crab2424/LEDplaying_system/チーム内部資料/7_3_23時計画書/img/LEDマトリクス基本設計詳細設計.pptx

エンターテイメントとしての
LEDマトリクス
Processingでの楽器選択
演奏中マトリクス
表示選択
演奏箇所の音程表示
演奏楽器の表示
演奏箇所の歌詞の表示

## Slide 2

クラスについて書く
