crab2424/LEDplaying_system/チーム内部資料/7_3_23時計画書/img/全体情報流れ.pptx

どうやって一定間隔で
LEDを光らせるのか

音程どんな形で送信するのか
長さはどうやって処理するのか(前言ってくれてた前回のテンポを参考に長さを決める)
楽譜情報は楽器用arduinoに入っているためどうやって送信するのか

点滅色の入れ替わり

指揮者用Arduino

・R,G,B値

楽器用Arduino

・音程
・音の長さ
・テンポ情報

楽器用PC(Processing)

・RBGの強さ

analogWriteでR,G,Bの値をフルカラーLEDへ送信

受光素子が受けとったR,B,G値をanalogReadで受信

USBで接続し，
シリアル通信
Serial.writeで送信．
sirialEvent()で受信．

## 通信の方法と内容

- 指揮者用Arduinoと演奏者用Arduino間のLEDでの通信
  - 指揮者用のArduinoのフルカラーLEDで色を出力し，演奏者用Arduinoに繋いだカラーセンサで受け取り通信する．
  - この時送信する内容はテンポ，誰が次のテンポを受け取った時に始めるかを送る．
- 演奏者用ArduinoとProcessing間でのシリアル通信
  - 演奏者ArduinoとPCをUSB Type-Cで接続し，Processing側でArduinoのシリアルポートと接続しシリアル通信を行う．
  - Arduino側はserial.write()関数を用いてデータを送信し，Processing側では1バイトのデータが届いた時に動くserialEvent()関数を用いて送受信を行う．
  - Processingへは演奏する音程，長さ，テンポ(テンポLED情報の間隔)を送る．

## LEDライトの状態ごとに何の信号とするのか(数値的に)

外部割り込みはLOW, CHANGE, RISING
FALLINGのときだけ発生させられる．
そのため，analogReadで取得するから無理．

・次のテンポLEDから曲をスタートする合図(楽器*4)
・テンポ用発光
5種類のRGBパターン?

テンポの取り方
パルス波的な信号をanalogReadで取得．脈拍のように下がる時の最大値を音の大きさとする
どうやって電圧値を一瞬だけ上げて下げるか　何かで時間をとってあげてその時間を過ぎたらpinの電圧を下げればよい．(外部割り込み使えない+loopの中の判定式で信号を取得する場合.短すぎるとanalogReadのタイミングで取り逃がす == 受け取り側の1Loop以上の長さ)
(赤がテンポで，青緑00以外のサンパターンはできる)ここ確認したい

アナログかデジタルか．どういう状態をどのパターンとするか

## 発表来週 計画発表

- 題目申請 今日17:00まで
- 計画発表: 題目申請 来週の計画書，設計書は全て同じ題目(タイトルにする)

## 役割分担

- システムの役割分担
- 単体，結合テスト，システムテスト
- 結合テストで作成できたものが動くのかのテスト(毎週)

## 必要な機材

- どの構成要素・役割に何が必要かまとめる
- 全てで共通のもの
- Arduino *5
- ブレッドボード
- PC processing..
- 指揮者に必要なもの
- 演奏者に必要なもの

## Slide 7
