crab2424/LEDplaying_system/チーム内部資料/7_3_23時計画書/26_計画書・設計書(2026年7月3日版)_24G1040.pdf

2026 年 7 月 3 日 Version 1.6

# ハッカソン 〜計画書と設計書〜

## チーム 26

24G1040 : 金枝 優介
24G1074 : 荘司 あかね
24G1125 : 三芝 空音
25G1009 : 飯塚 蓮
25G1034 : 恩田 隼士
25G1063 : 佐藤 羽琉

目次

第 1 章 | プロジェクトの計画書 ・・・・・・・・・・・・・・・・・・・・・・・・・・・・ | 1
1.1 | プロジェクトの概要・・・・・・・・・・・・・・・・・・・・・・・・・・・・・・ | 1
1.1.1 | プロジェクトの題目 ・・・・・・・・・・・・・・・・・・・・・・・・・・・・ | 1
1.1.2 | プロジェクトの目的 ・・・・・・・・・・・・・・・・・・・・・・・・・・・・ | 1
1.2 | 社会的背景 ・・・・・・・・・・・・・・・・・・・・・・・・・・・・・・・・・・・ | 1
1.2.1 | 既存の技術とプロジェクトの独自性・・・・・・・・・・・・・・・・・・・ | 2
1.3 | スコープ・マネジメント ・・・・・・・・・・・・・・・・・・・・・・・・・・・ | 4
1.3.1 | 成果物・・・・・・・・・・・・・・・・・・・・・・・・・・・・・・・・・・・・・ | 4
1.3.2 | プロジェクトの対象範囲と非対象範囲 ・・・・・・・・・・・・・・・・・ | 4
1.3.3 | 機能分解構造 FBS・・・・・・・・・・・・・・・・・・・・・・・・・・・・・・ | 5
1.3.4 | 製品分解構造 PBS・・・・・・・・・・・・・・・・・・・・・・・・・・・・・・ | 5
1.3.5 | FBS と PBS の対応関係 ・・・・・・・・・・・・・・・・・・・・・・・・・・ | 6
1.4 | 作業計画・・・・・・・・・・・・・・・・・・・・・・・・・・・・・・・・・・・・・ | 7
1.4.1 | 作業分解構造 WBS と管理番号・・・・・・・・・・・・・・・・・・・・・・ | 7
1.4.2 | アローダイアグラムとクリティカルパス・・・・・・・・・・・・・・・・ | 9
1.4.3 | 役割分担 ・・・・・・・・・・・・・・・・・・・・・・・・・・・・・・・・・・・ | 9
1.4.4 | ガントチャート ・・・・・・・・・・・・・・・・・・・・・・・・・・・・・・・ | 10
1.5 | 検証と妥当性確認: V&V 計画 ・・・・・・・・・・・・・・・・・・・・・・・・ | 11
1.5.1 | プロジェクトの成果物に対する有効指標 MOE ・・・・・・・・・・・・ | 11
1.5.2 | 有効指標 MOE に対応する性能指標 MOP ・・・・・・・・・・・・・・・ | 12
1.5.3 | システムテストで評価する性能指標 MOP ・・・・・・・・・・・・・・・ | 12
1.5.4 | 結合テストで評価する性能指標 MOP・・・・・・・・・・・・・・・・・・ | 13
1.5.5 | 単体テストで評価する性能指標 MOP・・・・・・・・・・・・・・・・・・ | 13
1.5.6 | プロジェクト中に監視する技術性能指標 TPM ・・・・・・・・・・・・ | 16
1.6 | 資源・調達管理・・・・・・・・・・・・・・・・・・・・・・・・・・・・・・・・・ | 16
1.7 | リスク管理 ・・・・・・・・・・・・・・・・・・・・・・・・・・・・・・・・・・・ | 18
第 2 章 | システムの基本設計・・・・・・・・・・・・・・・・・・・・・・・・・・・・・・ | 19

2

2.1 | 機能一覧・・・・・・・・・・・・・・・・・・・・・・・・・・・・・・・・・・・・・ | 19
2.2 | システム構成図・・・・・・・・・・・・・・・・・・・・・・・・・・・・・・・・・ | 21
2.3 | 操作インターフェース設計・・・・・・・・・・・・・・・・・・・・・・・・・・ | 21
2.4 | 状態遷移図 ・・・・・・・・・・・・・・・・・・・・・・・・・・・・・・・・・・・ | 23
第 3 章 | システムの詳細設計・・・・・・・・・・・・・・・・・・・・・・・・・・・・・・ | 25
3.1 | 部品一覧・・・・・・・・・・・・・・・・・・・・・・・・・・・・・・・・・・・・・ | 25
3.2 | ハードウェア設計 ・・・・・・・・・・・・・・・・・・・・・・・・・・・・・・・ | 27
3.3 | ソフトウェア設計 ・・・・・・・・・・・・・・・・・・・・・・・・・・・・・・・ | 29
3.3.1 | ファイル構成・・・・・・・・・・・・・・・・・・・・・・・・・・・・・・・・・ | 29
3.3.2 | 通信設計 ・・・・・・・・・・・・・・・・・・・・・・・・・・・・・・・・・・・ | 29
3.3.3 | LED マトリクスへの歌詞表示 ・・・・・・・・・・・・・・・・・・・・・・ | 31
3.3.4 | 音生成・再生・・・・・・・・・・・・・・・・・・・・・・・・・・・・・・・・・ | 33
3.3.5 | 受光機能 ・・・・・・・・・・・・・・・・・・・・・・・・・・・・・・・・・・・ | 33
3.4 | スイッチによる入力制御の詳細設計 ・・・・・・・・・・・・・・・・・・・・ | 37
3.4.1 | 入力ピンの割り当てと初期設定 ・・・・・・・・・・・・・・・・・・・・・ | 37
3.4.2 | 可変抵抗によるテンポ入力 ・・・・・・・・・・・・・・・・・・・・・・・・ | 38
3.4.3 | 可変抵抗による分圧の原理 ・・・・・・・・・・・・・・・・・・・・・・・・ | 38
3.4.4 | タクトスイッチによる起動・停止制御 ・・・・・・・・・・・・・・・・・ | 39
3.4.5 | 入力制御の処理フロー ・・・・・・・・・・・・・・・・・・・・・・・・・・・ | 41
3.4.6 | オブジェクト設計 (クラス図)・・・・・・・・・・・・・・・・・・・・・・・ | 42
3.4.7 | 関数設計 ・・・・・・・・・・・・・・・・・・・・・・・・・・・・・・・・・・・ | 44
3.5 | 処理フローの設計 ・・・・・・・・・・・・・・・・・・・・・・・・・・・・・・・ | 45
3.6 | テストの設計 ・・・・・・・・・・・・・・・・・・・・・・・・・・・・・・・・・・ | 50
3.6.1 | システムテストの設計 ・・・・・・・・・・・・・・・・・・・・・・・・・・・ | 50
3.6.2 | 結合テストの設計・・・・・・・・・・・・・・・・・・・・・・・・・・・・・・ | 51
3.6.3 | 単体テストの設計・・・・・・・・・・・・・・・・・・・・・・・・・・・・・・ | 51

# 第 1 章 プロジェクトの計画書

## 1.1 プロジェクトの概要

### 1.1.1 プロジェクトの題目

本プロジェクトの題目は，「単一のフルカラー LED と Arduino を用いた光無線通信 による楽器間同期演奏システムの開発」である．

### 1.1.2 プロジェクトの目的

従来の同期システムでは，有線接続による配線制約や，無線通信における通信遅 延・通信環境依存などが課題となっている．本プロジェクトの目的は，LED の光を 用いた無線通信による楽器間同期演奏システムを構築し，楽器演奏のズレを最小限に 抑え，合奏を成立させることである．さらに，利用者が楽器変更やテンポ変更等の演 奏機能を制御するための Web サイトや視覚的に合奏を認識するために LED マトリク ス歌詞表示システムを構築することでシステムの操作性及びエンターテイメント性の 向上を目指す．最終的なゴールは，ユーザの操作に応じて，複数楽器の同期演奏を成 立させることである．

## 1.2 社会的背景

近年，音楽演奏や視覚演出の分野において，出力装置を複数台組み合わせた作品や システムが研究されている．例えば神田らは複数のモバイルデバイスを用いたインタ ラクティブメディアアートを提案している [1]．これらのシステムでは，各装置が正 確なタイミングで動作することが求められ，リアルタイム同期処理が重要な要素と なる．
特に音楽演奏においては，複数の演奏者や演奏装置が同一テンポで動作する必要が あり，わずかな同期ズレであっても演奏品質に影響を与える．音声遅延が演奏に与え

1

る影響は大きく，先行研究では数 ms 程度の遅延であっても演奏品質や演奏感覚に影 響を与えることが報告されている [2]．そのため，演奏同期システムにおいては，演 奏に支障を与えるような遅延や同期ズレを低減するための高精度な同期制御技術が求 められる．
また，近年の IoT 技術の発展により，様々なデバイスがネットワークに接続される ようになり，データ流通量のさらなる増加へとつながっている [3]．このような技術 は，スマートホームや産業機器の制御，エンターテインメントシステムなど，多様な 分野において応用されている．
一方で，複数装置を連携させる従来の同期システムでは，有線接続による配線制約 や，無線通信における通信遅延・通信環境依存などの課題が存在する．そのため，複 数装置を柔軟に同期可能な，新たな同期手法が求められている． また，輪唱のような複数パートが異なるタイミングで演奏する楽曲では，聴衆が各 パートの演奏状況を聴覚のみで把握することは難しい．音楽演奏において視覚情報と 聴覚情報を組み合わせることで，聴衆の楽曲理解や没入感が向上することが報告され ており [4]，演奏システムにおける視覚的演出の重要性は高まっていると言える．

### 1.2.1 既存の技術とプロジェクトの独自性

既存の通信方法として現在幅広く利用されているものに，有線通信および

Bluetooth や Wi-Fi を用いた無線通信がある．
有線通信は通信の安定性が高く遅延の影響を受けにくいという利点を持つが，複数 装置を接続するためには配線が必要となり，設置の自由度が低下するという課題があ る．特に近距離環境での複数装置の同期において，配線の取り回しがシステム構成の 複雑化を招く．一方，無線通信は配線を必要とせず柔軟なシステム構成が可能である が，電波干渉や通信環境の影響を受けやすく，遅延やパケット損失が発生する可能性 がある [5]．
また，本システムに関連する技術として光無線通信が挙げられる．光無線通信と は，我々が日常的に使用している放送や携帯電話の電波と同じ電磁波の一種である 光を電波媒体とするシステムである [6]．この通信システムの光源には LED や LD， VCSEL が用いられ，光信号の受信用検出器には Pin-PD や APD が使われる． 従来の光通信では，光の有無や強弱といった単一の情報を扱う方式が一般的であ り，伝達可能な情報量が限られるという課題がある．これは，従来の強度検出型の光 通信方式では，主に光の強弱のみを情報として利用していることに起因する．また，

2

外乱光の影響を受けやすく，環境光の変動による誤検出が生じる可能性がある．さら に，複数の信号を識別することが困難であり，多数の装置を同時に制御する用途には 適していない．
これらの課題に対し，本システムは近距離環境での複数装置の同期制御を対象と し，フルカラー LED とカラーセンサを用いた光通信を採用することで配線を不要と し，近距離環境における配線削減およびシステム構成の簡略化を図る．
単一の LED から全演奏者へ同時に信号を送信する構成とすることで，演奏者間の 信号のばらつきをなくし，同期ズレを防ぐ設計とした．光は電波と比較して外部から の干渉を受けにくく，混線が生じないため，無線通信で問題となる同期ズレの低減が 期待される．また，光通信ではネットワークを介した無線通信と異なり，パケット損 失や通信環境変動の影響を受けにくく，安定した信号伝達を行うことができると考 えられる．加えて，単一の LED を使用することで，有線通信のように装置の増加に 伴って分配器やケーブルが増大する問題がなく，受光可能範囲内であれば装置の追加 や配置変更が容易である．さらに，光通信はネットワークを介した無線通信と比較し て，通信処理が単純であるため，低遅延化が期待できる．加えて，センサ周辺を遮光 することで外部照明の影響を低減し，誤検出の低減を図る． 本システムではフルカラー LED とカラーセンサを用いることで，光の色，発光間 隔，光強度といった複数のパラメータを同時に利用した通信を実現している．これに より，従来の強度ベースの光通信と比較してより多くの情報を表現可能である．さら に，光の点灯間隔をセンサで検出することでテンポ情報を直接取得し，数値データを 用いずに演奏タイミングを制御する点に特徴がある．また，色ごとに異なる意味を割 り当てることで複数の楽器や制御信号を同時に扱うことができる． 以上より，本システムは光通信の簡易性と多機能性を両立した光同期システムであ る点に独自性がある．さらに，本システムでは LED マトリクスによる歌詞表示機能 を実装することで，輪唱における各パートの演奏タイミングを視覚的に提示し，聴覚 情報のみでは把握しにくい輪唱の構造を視覚情報と組み合わせて表現する点にも独自 性がある．

3

## 1.3 スコープ・マネジメント

### 1.3.1 成果物

本プロジェクトにおける最低限達成すべき機能として，光無線通信による楽器間の 演奏ズレが限りなく少ない合奏機能を実装する．同期通信，演奏制御，エンターテイ メントとしての歌詞表示を含めた本プロジェクトの成果物は，以下の通りである．

•フルカラー LED を用いた光通信による同期演奏システム •各楽器の音再生プログラム
•LED マトリクスによる歌詞表示機能
•Web 演奏制御機能

### 1.3.2 プロジェクトの対象範囲と非対象範囲

フルカラー LED を用いた同期演奏システムを構築するために必要な本プロジェク トの対象範囲は以下の通りである．

•LED による光通信機能実装
•カラーセンサを用いた光信号の受信，解析
•テンポ取得
•4 種類の楽器音再生
•Web からのテンポ変更，楽器変更，音量変更，楽譜選択・ループ演奏選択機能 実装
•LED マトリクスによる歌詞表示

一方で，本プロジェクトでは，指揮者，演奏者間の同期通信に焦点を当てるため， 実際の楽器を演奏するのではなくデータとして楽器を演奏する．また，Web サイトで の演奏制御は同期処理に負荷をかけないよう，演奏前に楽器の変更などを行うため ネットワーク環境の整備は本プロジェクトでは対象外とした．よって，非対象範囲は 以下の通りである．

•商用レベルの高速・長距離光通信

4

•実際の楽器を演奏するための入力インターフェース
•システム運用に必要なネットワーク環境の整備

### 1.3.3 機能分解構造 FBS

本システムのユーザ目線から見た機能分解としての FBS を図 1.1 に示す．ユーザが 可能な制御は演奏中と，演奏前の二つに分けられる．演奏前は，演奏者ごとに楽器変 更，楽譜選択，個別音量の調節が可能で，演奏中は，テンポ変更，全体音量の調節， およびループ演奏の切り替えが可能である．また，それらの演奏制御は物理的なス

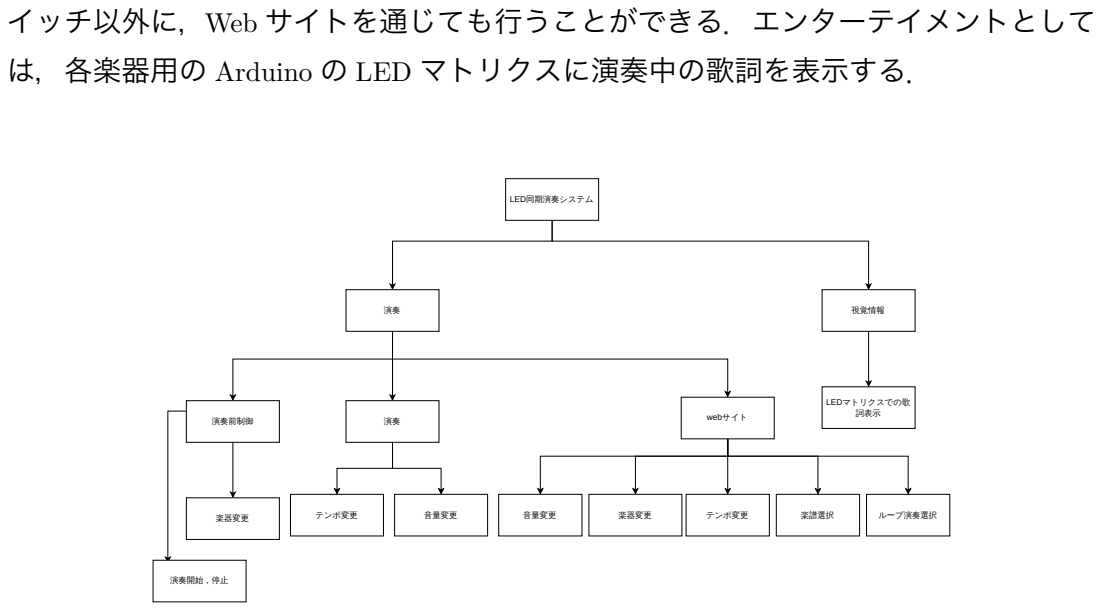
[picture p4: figure]
イッチ以外に，Web サイトを通じても行うことができる．エンターテイメントとして; は，各楽器用の Arduino の LED マトリクスに演奏中の歌詞を表示する．; LED同期演奏システム; 視覚情報; LEDマトリクスでの歌 詞表示; 演奏前制御; webサイト; 楽器変更; テンポ変更; 音量変更; 楽譜選択; ループ演奏選択; 演奏開始，停止

図 1.1 機能分解構造 (FBS)

### 1.3.4 製品分解構造 PBS

本システムの FBS を実装するための機能である PBS を図 1.2 に示す．ハードウェ アの面では，演奏同期のための LED の送受信の機能と，演奏開始や停止などの演奏 制御をボタン，スイッチを用いて実装する．また，ソフトウェアの面では，演奏を実

5

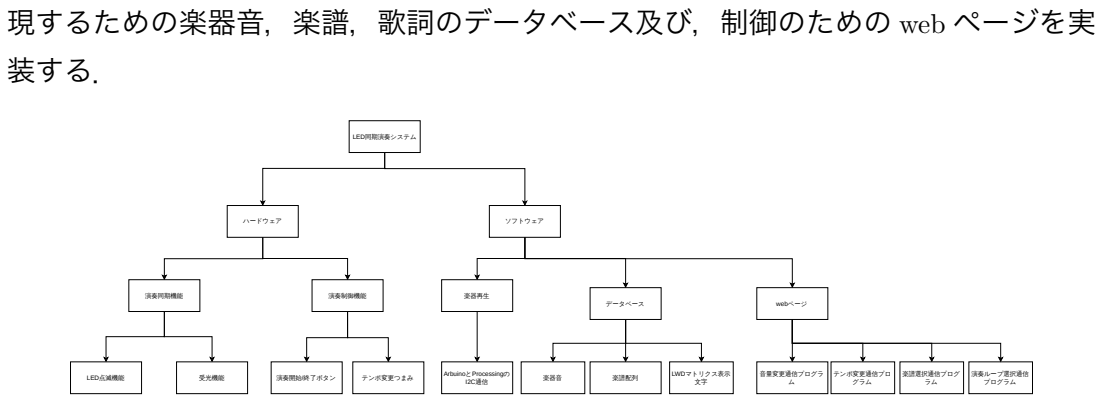
[picture p5: figure]
現するための楽器音，楽譜，歌詞のデータベース及び，制御のための web ページを実; 装する．; LED同期演奏システム; ハードウェア; ソフトウェア; 演奏同期機能; 演奏制御機能; 楽器再生; LED点滅機能; 受光機能; 演奏開始/終了ボタン; テンポ変更つまみ; ArbuinoとProcessingの; I2C通信; データベース; 楽譜配列; LWDマトリクス表示; 文字 楽器音; webページ; 音量変更通信プログラ ム; テンポ変更通信プロ グラム; 楽譜選択通信プログ ラム; 演奏ループ選択通信 プログラム

図 1.2 製品分解構造 (PBS)

### 1.3.5 FBS と PBS の対応関係

FBS と PBS の対応関係を以下の表 1.1 に示す．FBS の各機能に対して，それを実 現する PBS のサブ成果物を対応付けた．各機能は 1 つ以上の成果物によって実現さ れる．
「楽器演奏」機能については，ソフトウェア側の「演奏プログラム（ピアノ・バイ オリン・フルート・パーカッション再生）」と，ハードウェア側の「音再生用 PC」に よって実現される．「演奏制御」機能のうち，「演奏同期」は「送受信プログラム」 と「フルカラー LED」「カラーセンサ」の組み合わせにより，光無線通信として実装 される．また，「演奏開始・停止」は「Web サイト」と指揮者 Arduino に設置された 「タクトスイッチ」がその役割を担う．「Web サイト」による「テンポ変更」「音量変 更」「楽器変更」「楽譜選択」「ループ演奏選択」は，Web サイトに対応した各プログ ラムの構築により実現される．「視覚情報表示」機能である「LED マトリクス歌詞表 示」は，ソフトウェア側の「LED マトリクス表示プログラム（文字配列データ）」と， ハードウェア側の「演奏者 Arduino」によって実装される．このように，本プロジェ クトにおける全ての機能要件は，定義されたソフトウェアおよびハードウェアの構成 要素によって網羅されている．

6

表 1.1 FBS と PBS の対応関係
FBS（機能） | PBS（成果物）
ピアノ演奏 | 演奏プログラム（ピアノ音再生），楽器音データ，楽譜配列データ
バイオリン演奏 | 演奏プログラム（バイオリン音再生），楽器音データ，楽譜配列データ
フルート演奏 | 演奏プログラム（フルート音再生），楽器音データ，楽譜配列データ
パーカッション演奏 | 演奏プログラム（パーカッション音再生），楽器音データ，楽譜配列データ
演奏開始・停止 | 送信プログラム，受信プログラム
演奏同期 | 送信プログラム，受信プログラム
楽器変更 | Web サイト（楽器変更プログラム）
テンポ変更 | Web サイト（テンポ変更プログラム），テンポ変更つまみ
音量変更 | Web サイト（音量変更通信プログラム）
楽譜選択 | Web サイト（楽譜選択プログラム）
演奏ループ選択 | Web サイト（演奏ループ選択プログラム）
LED マトリクス歌詞表示 | LED マトリクス表示プログラム，LED マトリクス文字配列

## 1.4 作業計画

### 1.4.1 作業分解構造 WBS と管理番号

本開発における作業分解構造 WBS と管理番号を表 1.2 に示す．

7

表 1.2 本開発における WBS と管理番号

目的 | フェーズ | タスク | 活動タスク | 担当者
LED の発光色による光同期システム | 100 設計 | 110 基本設計 | 111 楽器演奏 | 各楽器担当者
112Web サイト | 金枝
113LED マトリクスデザイン | 三芝
120 詳細設計 | 121LED 点滅機能 | 佐藤
| 122 受光機能 | 飯塚
| 123 演奏開始・停止ボタン | 恩田
| 124Arduino と Processing の通信 | 飯塚
| 125 テンポ変更機能 | 佐藤
| 126 楽器変更機能 | 金枝
| 127 楽器音 | 各楽器担当者
| 128 楽譜配列 | 恩田
| 129LED マトリクス文字配列 | 三芝
200 機材調達 | 210 部品選定 | 211 購入または借用 | 全員
300 実装 | 310 楽器音作成 | 311 ピアノ音 | 佐藤
| | 312 フルート音 | 佐藤
| | 313 バイオリン音 | 恩田
| | 314 パーカッション音 | 荘司
| 320 同期システム | 321 光信号発信 | 佐藤
| | 322 光信号受信 | 飯塚
| | 323 演奏開始・停止ボタン | 恩田
| | 324 シリアル通信 送信 | 飯塚
| | 325 シリアル通信 受信 | 飯塚
| 330Web サイト作成 | 331 テンポ変更機能 | 佐藤
| | 332 楽器変更機能 | 金枝
| | 333 楽譜選択機能 | 金枝
| | 334 演奏ループ選択機能 | 金枝
| | 335 音量変更機能 | 金枝
| 340 演出 | 341LED マトリクス | 三芝
400 テスト | 410 単体テスト | 411 楽器音テスト | 各楽器担当者
| | 412 開始停止スイッチテスト | 恩田
| | 413 テンポ変更スイッチテスト | 飯塚
| 420 結合テスト | 421 光通信の同期テスト | 全員
| | 422Web 通信テスト | 全員
| | 423 接続テスト | 全員
| | 424 遅延テスト | 全員
| | 425 合奏が成り立っているかのテスト | 全員
| 500 仕上げ | 510 結合 | 511 全体結合 | 全員
| | 520 システム評価会 | 521 システム評価会実施 | 全員

各タスクには 100 番台から 500 番台の管理番号を付与し，設計・機材調達・実装・ テスト・仕上げの 5 フェーズで構成した．

8

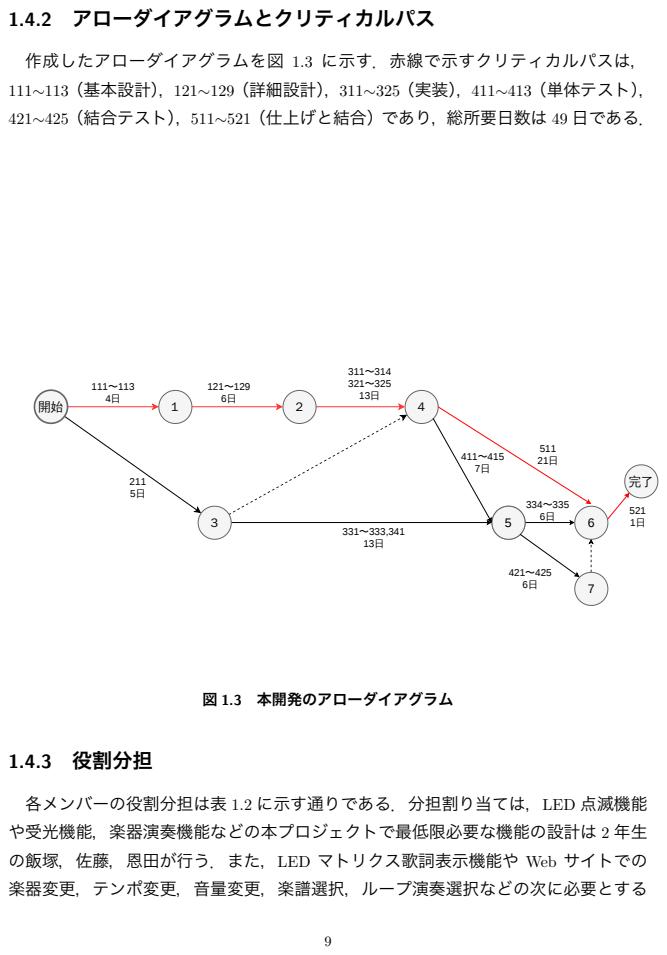
[picture p6: page 12]
1.4.2 アローダイアグラムとクリティカルパス; 図 1.3 本開発のアローダイアグラム; 1.4.3 役割分担

作成したアローダイアグラムを図 1.3 に示す．赤線で示すクリティカルパスは，
111∼113（基本設計），121∼129（詳細設計），311∼325（実装），411∼413（単体テスト），
421∼425（結合テスト），511∼521（仕上げと結合）であり，総所要日数は 49 日である．

各メンバーの役割分担は表 1.2 に示す通りである．分担割り当ては，LED 点滅機能
や受光機能，楽器演奏機能などの本プロジェクトで最低限必要な機能の設計は 2 年生
の飯塚，佐藤，恩田が行う．また，LED マトリクス歌詞表示機能や Web サイトでの
楽器変更，テンポ変更，音量変更，楽譜選択，ループ演奏選択などの次に必要とする

機能の設計を 3 年生全体で行う．結合テストおよび機材調達については全員で対応 する．

### 1.4.4 ガントチャート

本プロジェクトにおけるガントチャートを図 1.4 に示す．横軸に日付，縦軸に WBS の各タスクを示す．プロジェクトは 2026 年 5 月 20 日に開始し，設計・機材調達・実 装・テストの順に進める．設計フェーズを 5 月中に完了させ，6 月上旬までに実装，7 月頭までにテストを完了することを目標とする．テスト終了予定日から 1 週間は，不 具合発生時の修正作業および開発遅延への対応を行うための予備期間として確保す る．これにより，リスク管理で想定する遅延や同期精度の問題に対して柔軟に対応で きるようにする．また，中間テストのある 6 月上旬に，土日を含めた 3 日間をテスト 対策期間として空けている．

10

LED の発光色による光同期システム | シンプル ガント チャート (Vertex42.com)

26班

| https://www.vertex42.com/ExcelTemplates/simple-gantt-chart.html

セル B3 に、プロジェクト主任の名前を入力します。セル E3 には、プロジェクトの開始日を入力します。プロジェクトの開始: ラベルはセル C3 にあります。

1

18 19 20 21 22 23 24 | 25 26 27 28 29 30 31 | 1 | 2 | 3 | 4 | 5 | 6 | 7 | 8 | 9 10 11 12 13 14 | 15 16 17 18 19 20 21 | 22 23 24 25 26 27 28 | 29 30 1 | 2 | 3 | 4 | 5 | 6 | 7 | 8 | 9 10 11 12
タスク | 担当者 | 進捗状況 | 開始 | 終了 | 月 | 火 | 水 | 木 | 金 | 土 | 日 | 月 | 火 | 水 | 木 | 金 | 土 | 日 | 月 | 火 | 水 | 木 | 金 | 土 | 日 | 月 | 火 | 水 | 木 | 金 | 土 | 日 | 月 | 火 | 水 | 木 | 金 | 土 | 日 | 月 | 火 | 水 | 木 | 金 | 土 | 日 | 月 | 火 | 水 | 木 | 金 | 土 | 日 | 月 | 火 | 水 | 木 | 金 | 土 | 日

基本設計

楽器演奏 | 2年 | 5/20/26 | 5/23/26
Webサイト | 金枝 | 5/20/26 | 5/23/26
LEDマトリクスデザイン | ３年 | 5/20/26 | 5/23/26

詳細設計

LED点滅機能 | 佐藤 | 5/23/26 | 5/27/26
受光機能 | 飯塚 | 5/23/26 | 5/27/26
演奏開始、停止ボタン | 恩田 | 5/23/26 | 5/27/26
ArduinoとProcessing通信 | 飯塚 | 5/26/26 | 5/28/26
テンポ変更機能 | 佐藤 | 5/26/26 | 5/28/26
楽器変更機能 | 金枝 | 5/26/26 | 5/28/26
楽器音 | 2年 | 5/23/26 | 5/27/26
楽譜配列 | 恩田 | 5/26/26 | 5/28/26
LED マトリクス文字配列 | 3年 | 5/23/26 | 5/27/26

機材調達

部品選定 | 全員 | 5/20/26 | 5/24/26

実装

ピアノ音 | 佐藤 | 5/25/26 | 6/12/26
フルート音 | 佐藤 | 5/25/26 | 6/12/26
バイオリン音 | 恩田 | 5/25/26 | 6/12/26
パーカッション音 | 荘司 | 5/25/26 | 6/14/26
光信号発信 | 佐藤 | 5/25/26 | 6/12/26
光信号受信 | 飯塚 | 5/25/26 | 6/12/26
演奏開始、停止ボタン | 恩田 | 5/25/26 | 6/12/26
テンポ変更機能 | 佐藤 | 5/25/26 | 6/12/26
楽器変更機能 | 金枝 | 5/25/26 | 6/12/26
楽譜選択機能 | 金枝 | 6/20/26 | 6/25/26
ループ演奏選択機能 | 金枝 | 6/20/26 | 6/25/26
Webサイト | 金枝 | 5/25/26 | 6/3/26
LEDマトリクス | 三芝 | 5/25/26 | 6/5/26
ArduinoとProcessing通信 | 飯塚 | 5/27/26 | 6/12/26

テスト

楽器音テスト | 2年 | 6/13/26 | 6/19/26
開始停止スイッチテスト | 恩田 | 6/13/26 | 6/19/26
テンポ変更スイッチテスト | 飯塚 | 6/13/26 | 6/19/26
Web通信テスト | 金枝 | 6/13/26 | 6/19/26
光通信同期テスト | 全員 | 6/20/26 | 7/1/26
接続テスト | 全員 | 6/20/26 | 7/1/26
遅延テスト | 全員 | 6/20/26 | 7/1/26
演奏が成り立っているかテスト | 全員 | 6/20/26 | 7/1/26

仕上げ

結合 | 全員 | 6/17/26 | 7/7/26
班内システム評価会実施 | 全員 | 7/8/26 | 7/8/26

プロジェクトの開始:

週表示: | 2026/6/15 | 2026/7/6

水, 2026/5/20

2026/5/18 | 2026/5/25 | 2026/6/1 | 2026/6/8 | 2026/6/22 | 2026/6/29

図 1.4 ガントチャート

## 1.5 検証と妥当性確認: V&V 計画

### 1.5.1 プロジェクトの成果物に対する有効指標 MOE

本プロジェクトの成果物は，離れた場所にいる演奏者が指揮者の LED による光信 号を基準として同期しながら合奏できるシステムである．このシステムの有効性を評 価するための有効指標（MOE）を以下に示す．

•MOE1：光同期の実現
指揮者の光信号が各演奏者に遅延なく届き，演奏者間の同期がとれた合奏が成立

11

すること．
•MOE2：音色の再現性
本システムが出力する楽器音が，実際の楽器音を十分な精度で再現している こと．
•MOE3：Web サイトによるリアルタイム制御
指揮者が Web サイトを通じてテンポや楽器などの演奏パラメータをリアルタイ ムに変更できること．

### 1.5.2 有効指標 MOE に対応する性能指標 MOP

各 MOE に対応する定量的な性能指標（MOP）を以下に示す．

表 1.3 MOE と MOP の対応
MOE | 評価項目 | MOP | 目標値
MOE1 | 光と音の発生時間差 演奏者間の同期ズレ 光同期の通信精度 | 通信遅延 楽器間同期ズレ パケット損失率（IPLR） | 125 ms 以内 40 ms 以内 1%以内
MOE2 | 楽器音の再現度 | 立ち上がり時間差（AT 差） スペクトル重心相対差（SC 差） スペクトル変動度差（DSV 差） 奇偶倍音比差（OER 差） 音色アンケート評価 | 60 ms 以内 24%以内 16%以内 0.20 以内 3.51 以上
MOE3 | Web サイトの応答速度 Web サイトの通信精度 | 送信〜反映までの遅延 パケット損失率（IPLR） | 100 ms 以内 1%以内

### 1.5.3 システムテストで評価する性能指標 MOP

システムテストでは，システム全体を結合した状態で以下の MOP を評価する．

•光と音の発生時間差（目標：125 ms 以内）
指揮者の LED が発光してから演奏者 PC のスピーカーから音が出るまでの時間 差を評価する．光（映像）が先，音（音声）が後の場合，125 ms を超えるとズレ に気づき，185 ms を超えると許容できなくなることが知られている [7]．

12

•楽器間の同期ズレ（目標：40 ms 以内）
複数の演奏者間における各拍の発音タイミングのズレを評価する．先行音と後続 音のズレが 40 ms 以内であれば一つの音として認識される [8]．
•Web サイト送信〜演奏反映までの遅延（目標：100 ms 以内）
Web サイトでテンポなどのパラメータを Web サイトで変更してから，演奏プロ グラムに反映されるまでの時間を評価する．人間がシステムを操作した際，100 ms 以内の応答であれば遅延を知覚しない [9]．

### 1.5.4 結合テストで評価する性能指標 MOP

結合テストでは，各機能モジュールを接続した状態で以下の MOP を評価する．

•光同期のパケット損失率（目標：1%以内）
指揮者から演奏者への光同期通信において，LED の発光を光センサで検知でき たかを計数し，パケット損失率を評価する．ITU-T の規定するリアルタイムデー タ通信の許容 IPLR は 1%以下である [10]．
•Web サイトのパケット損失率（目標：1%以内）
Web サイトから演奏プログラムへの制御コマンド送信において，送信ログと受信 ログを比較し，パケット損失率を評価する．同様に ITU-T の規定する許容 IPLR である 1%以下を目標とする [10]．

### 1.5.5 単体テストで評価する性能指標 MOP

単体テストでは，個々の機能モジュール単体で以下の MOP を評価する．

•音色の再現性（目標：各音色特徴量が目標差以内）
実際の楽器音の録音データと，本システムが出力した音の録音データを録音して 比較する．
人間の音色知覚を構成する特徴量である以下の 4 つを用いて音色の再現精度を 評価する [17]．比較の前処理として，両者の音量を RMS 正規化により統一し， pYIN アルゴリズムで推定した F0 を用いて音程が一致していることを確認する． AT・SC・DSV・OER の 4 つの音色特徴量を算出し，各音程ごとに参照音源と再 現音のズレ量（または相対差）を求め、全音程にわたる平均値を目標値と比較す る．それぞれの数値の説明は以下に示す．本テストは各楽器・音程ごとに行った

13

うえで平均を取り評価する．
立ち上がり時間（AT）：RMS エンベロープがピーク値に到達するまでの時間 [ms]．音の立ち上がり（アタック）の速さが参照音とどれだけズレているかを評 価する．音声波形から RMS エンベロープ（短時間ごとの RMS 振幅の時系列）を 計算し，音が鳴り始めた時点から RMS が最大値（ピーク）に達するまでの時間 を求める．全音程にわたるズレの平均値を 60 ms 以内に収めることを目標とす る．この数値は，Siedenburg (2019) が 10 楽器 Œ12 音程の実験において，AT を ś60ms 操作した際の弁別命中率が約 79%になることから決定した [12]．この水準 を「人間が違いに気づきはじめる境界」とみなし，それ未満のズレであれば知覚 的に同等とみなせるとし，目標とした．
スペクトル重心（SC）：持続区間（全体の 25〜75%）でのスペクトル重心周 波数 [Hz]．音の明るさ・硬さの指標であるスペクトル重心が参照音とどれだ けズレているかを評価する．音の持続区間（音の長さの 25%〜75%の区間）に ついて FFT で周波数スペクトルを求め，各周波数成分をその振幅で重み付け した平均周波数（重心）を計算する．SC は SC =

P
P

(fi×|X(fi)|)
|X(fi)| で求められる．
ここで fi は周波数、X(fi) は振幅である．参照音源と再現音の SC 値の相対差

（|SCref−SCsynth|

SCref

× 100）を音程ごとに算出し，全音程の平均値を求める．全音程に わたる SC 相対差の平均値を 24%以内に収めることを目標とする．この数値は Wun et al. (2014) が複数楽器の平均で SC を − 24%変化させると弁別率が 75%を 超えることを確認したことに基づき決定した [13]．この変化量を「聴感上区別が つき始める閾値」とし，それ未満を目標とした．
スペクトル変動度（DSV）：フレーム間の L2 相対変化量の平均 [%]．音の持続 中にスペクトル（音色）がどれだけ揺らぐか、その安定性が参照音とどれだけズ レているかを評価する．音声を短いフレームに分割し，連続するフレーム間での スペクトル（FFT 振幅）の変化量を L2 ノルムで算出し，前フレームのスペクト ルで正規化した相対変化量を求める．参照音源と再現音の DSV 値の相対差を音 程ごとに算出し，全音程の平均値を求める．全音程にわたる DSV ズレの平均値 を 16%以内に収めることを目標とする．この数値は Horner et al. (2004) が 8 楽器 を対象とした実験において，スペクトル変動誤差が 16%程度で知覚上の弁別が中 程度となることを報告していることに基づき決定した [14]．これを許容できる誤 差の上限として採用した．
奇偶倍音比（OER）：奇偶倍音比奇数倍音と偶数倍音のバランス（楽器固有の

14

音色を決定づける要素．例：クラリネットは奇数倍音優位，フルートは均等）が 参照音とどれだけズレているかを評価する．pYIN アルゴリズム [15] で F0（基本 周波数）を推定し，n×F0 （n=1,2,3…）の位置にある倍音成分のエネルギーを抽 出する．奇数次倍音のエネルギー合計を E_odd、偶数次倍音のエネルギー合計 を E_even とし，Eodd/(Eodd + Eeven) を算出する．参照音源と再現音の OER 値の 相対差を音程ごとに算出し，全音程の平均値を求める．全音程にわたる OER 相 対差の平均値を 20%以内に収めることを目標とする．Caclin et al. (2005) がスペ クトル不規則性（奇偶倍音比はその指標の一つ）が音色知覚の重要な相関物であ ることを実験的に確認した [16] こと，McAdams et al. (1995) の知覚次元モデルと も一致するため，相対差 20%以内を目標とした [17]．

音色の知覚には倍音構成・エンベロープ・ノイズ成分など無数の物理的特徴が関わ るが，心理学的な多次元尺度構成法（MDS）を用いた聴取実験から，人間が実際に音 色を判断する際に利用している主要な次元はごく少数に絞り込めることが示されてい る．McAdams et al. (1995) は楽器音に対する非類似度判断を MDS 分析し，人間の音 色知覚が「立ち上がり時間（時間的特徴）」「スペクトル重心（明るさ）」「スペクトル 変動度（音色の時間的揺らぎ）」というごく少数の次元でほぼ説明できることを示し た [17]．AT・SC・DSV はこの主要 3 次元に直接対応する指標である．一方，この 3 次元だけでは一部の楽器に残る差（楽器固有の「特異性」）を説明できないことも示 されており,Caclin et al. (2005) はその主な要因がスペクトル不規則性（奇数次倍音と 偶数次倍音のエネルギーバランスの偏り）であることを実験的に確認した [16]．OER はこの第 4 の次元に対応する指標である．つまり AT・SC・DSV が音色知覚の主要 3 次元，OER がそれだけでは捉えきれない楽器固有の特異性を補う指標として機能し ており，この 4 つを組み合わせることで人間が実際に音色の違いとして知覚する範囲 をほぼ網羅的に説明できる．そのため，4 項目すべてが目標差以内に収まっていれ ば，人間が知覚する音色差は小さいと考えられ，参照音源と再現音は知覚上おおむね 類似した音色を有すると判断できる．
また，音色の評価に関して，AT・SC・DSV・OER の 4 つの音色特徴量の算出の他 にアンケートも同時に行う．作成した回答用フォームを用いた音色評価を実施し，そ の結果を元に評価を行う．この音色評価は，参加者に作成した音と実際の楽器の音を 聞き比べてもらい，目的音をどの程度再現できているかを以下の 5 段階で評価しても らい，その平均値を用いて評価する．集計したものの平均が 3.51 以上の場合，音色が

15

十分再現されていると判断する．音色の評価では，AT・SC・DSV・OER による音響 特徴量の解析結果と，アンケートによる聴取評価の双方を用いて総合的に評価する．

### 1.5.6 プロジェクト中に監視する技術性能指標 TPM

作業分解構造に基づくタスクの消化進捗率を監視する．当初の予定に対して進捗の 遅延が 15％を超えた場合には，楽器変更機能などの付加的な機能の優先順位を下げ， コアとなる合奏同期機能の完成を最優先する．
プロジェクト実行中に監視する技術性能指標 TPM を表 1.4 に示す．演奏同期は， 光信号受信から演奏開始までの遅延を測定し，100ms を超えた場合には通信方式や処 理手順を見直す．楽器演奏は，出力音の周波数を測定し，基準周波数との差を確認す る．誤差が大きい場合には，発振周波数や音源生成処理を調整する．LED マトリク ス歌詞表示は，演奏タイミングとのズレを測定し，ś100ms を超える場合には表示更 新処理の改善を行う．
これらの TPM を継続的に監視することで，システム全体の品質向上と問題の早期 発見を目指す

表 1.4 技術性能指標 TPM

FBS 要素 | 監視指標 | 理由
演奏同期 | 光信号受信から演奏開始までの遅延 | 同期はシステムの根幹にかかわるため
楽器演奏 | 参考周波数とのズレ | 音程の正確さはシステムの品質に直結するため
LED マトリクス歌詞表示 | 演奏タイミングと歌詞表示のズレ | 視覚情報の同期はシステムの完成度にかかわるため

## 1.6 資源・調達管理

本開発にあたって必要な機材とその調達方法を表 1.5 に示す．

16

表 1.5 使用機材一覧

使用機材 | 型番 | 単価 (円) | 個数 | 調達方法
マイコンボード | Arduino UNO R4 WiFi | 0 | 5 | 所有
抵抗器 330 Ω | - | 6 | - | 所有
抵抗器 3300 Ω | - | 1 | - | 所有
ブレッドボード | 165401020E | 0 | 3 | 所有
ジャンパワイヤー | 165012000E | 0 | 1 式 | 所有
カラーセンサ | TCS34725 | 500 | 4 | Amazon にて購入
カラー LED | OSTA5131A-R/PG/B | 50 | 2 | 秋月電子通商にて購入
Processing 実行用 PC | MacBook Air/Pro | - | 5 台 | 所有
USB Type-C to C ケーブル | - | - | 5 | 所有
タクトスイッチ | - | - | 1 | 学科借用
可変抵抗器 | RK09D117000B | 60 | 1 | 秋月電子通商にて購入
ルータ | - | 0 | 1 | 学科借用
覆いの箱 | - | 0 | 1 | 班員私物

17

## 1.7 リスク管理

本プロジェクトにおいて，光同期の精度が低い，進捗が遅く実装が間に合わないな どのリスクが考えられる．光同期の精度が低い場合，周囲の光によるノイズなどの外 部からのノイズを排除するために，光通信全体を仕切りで覆うなどの処置を施す．進 捗が遅く実装が間に合わない場合，進捗が十分なメンバーが終わっていない作業のサ ポートを行い，それでも間に合わない場合は優先順位の低い追加機能の実装を諦める こととする．これらをまとめた，リスク内容と発生可能性並びに影響度，対策を表 1.6 に示す．

表 1.6 リスク管理

リスク内容 | 発生可能性 | 影響 | 対策
光通信の精度が出ない | 高 | 大 | センサの感度調整・遮光対策を行う
遅延が大きく同期がとれない | 中 | 大 | テストを早めに行い早期発見する
想定より実装に時間がかかる | 中 | 大 | クリティカルパスを優先し，余裕日数を活用する
メンバー間で進捗に差が出る | 中 | 中 | 進捗をこまめに共有し，タスクを再分配する
データの紛失 | 低 | 大 | GitHub などでバージョン管理を行う
部品が届かない・壊れる | 低 | 中 | 予備部品を確保しておく

18

# 第 2 章 システムの基本設計

## 2.1 機能一覧

本システムの機能一覧を FBS に基づいて表 2.1 に示す．本システムは，指揮者と複 数の演奏者からなるオーケストラ形式の同期演奏を実現するための多様な機能を備え ている．システムの根幹となる制御機能は，指揮者用 Arduino に直接取り付けられた スイッチによって管理され，これにより LED の点滅開始と終了，すなわち演奏の開 始と停止を即座に行うことが可能である．通信においては，フルカラー LED を用い た独自の光通信プロトコルを採用しており，発光色によって各 Arduino の演奏開始を 指示する．なお，再生する楽器音は Web サイトから事前に指定された楽器 ID に従う ため，色と楽器音は直接対応しない．点滅間隔の長さによって楽曲のテンポを精密に 調整する．また，LED の点滅の強さ，すなわち光量のピーク値を算出することで，各 楽器の音量を動的に変化させることができ，柔軟な強弱表現を可能としている． ユーザーとのインターフェースとして機能する Web サイトからは，テンポ変更や 全体音量の調節，演奏者ごとの個別音量の調節に加えて，演奏の開始と停止，楽譜選 択，ループ演奏選択といった高度な演奏制御が行える．さらに，ネットワーク環境に 問題が発生するなどして Web サイトが利用できない事態を想定し，可変抵抗による アナログ電圧変化を用いたテンポ調整機能もあわせて実装する．視覚的な演出面で は，演奏者側の Arduino に搭載された LED マトリクスのうち，横 8× 縦 8 の範囲を利 用して歌詞を一文字ずつ表示する．楽譜情報の送信進捗に合わせた動的なテキスト表 示をすることによって，エンターテインメント性における独創性を高めている．

19

表 2.1 本システムの機能一覧
機能名 | 機能概要
システム起動・停止 | 指揮者用 Arduino に取り付けられた物理スイッチを 操作することで，全体の演奏開始および終了を制御 する．
光信号同期通信 | 指揮者側 LED の発光色によって各パートの演奏開 始を指示し，点滅間隔の長さに基いてテンポを調節 する．
Web 遠隔制御 | Web ブラウザを介して，BPM の指定，全体音量の調 節，楽器パートの変更，楽譜選択，演奏者ごとの個 別音量の調節，およびループ演奏の切り替えを指示 する．
楽器音合成・再生 | 演奏者側 PC の Processing 上で，受信した音高，光量 由来の音強，点滅由来の音長情報を基に波形を合成 し再生する．
個別音量・表現制御 | LED の点滅の強さ（光量のピーク値）から個別の音 量倍率を算出し，動的な音楽表現を実現する．
歌詞表示演出 | LED マトリクスの横 8× 縦 8 範囲を利用し，カタカ ナを用いて歌詞を一文字ずつ表示する．輪唱におい て各パートが異なるタイミングで演奏を開始するた め，聴覚のみでは把握しにくい演奏構造を視覚情報 として補完する．
アナログ制御（予 備） | ネットワーク環境等により Web 制御が困難な場合， 可変抵抗の電圧変化を利用してテンポを可変させる．
同期確認用 LED（箱 外） | 視覚フィードバックおよび遅延計測用に使用する LED，指揮者側 LED と同じ光り方をする．

20

## 2.2 システム構成図

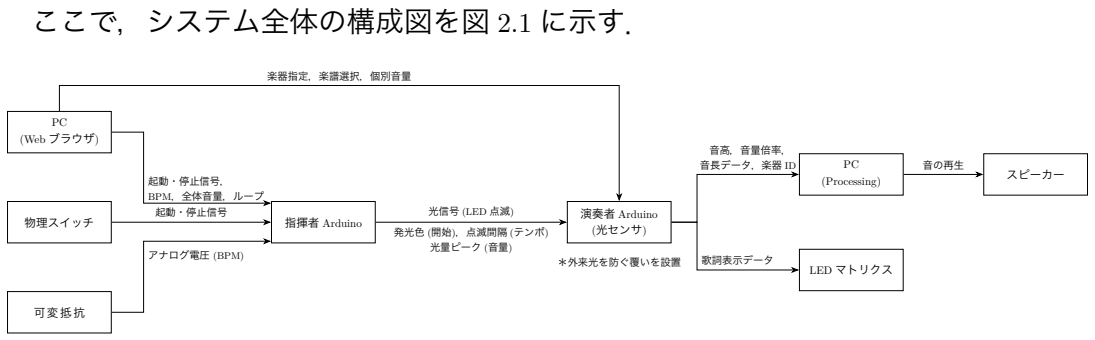
[picture p7: figure]
ここで，システム全体の構成図を図 2.1 に示す．; 指揮者 Arduino; 演奏者 Arduino; (光センサ); ＊外来光を防ぐ覆いを設置; 物理スイッチ; PC (Web ブラウザ); 可変抵抗; (Processing); LED マトリクス; スピーカー 起動・停止信号，; BPM，全体音量，ループ; 起動・停止信号; アナログ電圧 (BPM); 楽器指定，楽譜選択，個別音量; 光信号 (LED 点滅); 発光色 (開始)，点滅間隔 (テンポ) 光量ピーク (音量); 音高，音量倍率， 音長データ，楽器 ID; 歌詞表示データ; 音の再生

図 2.1 システム構成図

## 2.3 操作インターフェース設計

本システムの操作インターフェースでは，主系統である Web ブラウザ UI と，予備 系統である物理的なアナログ入力の両方を設計する．
主系統のインターフェースとして，WiFi ネットワーク経由の HTTP 通信を利用し たブラウザベースのコントロールパネルを用意する．図 2.2 に Web ブラウザの UI 配 置を示す．

21

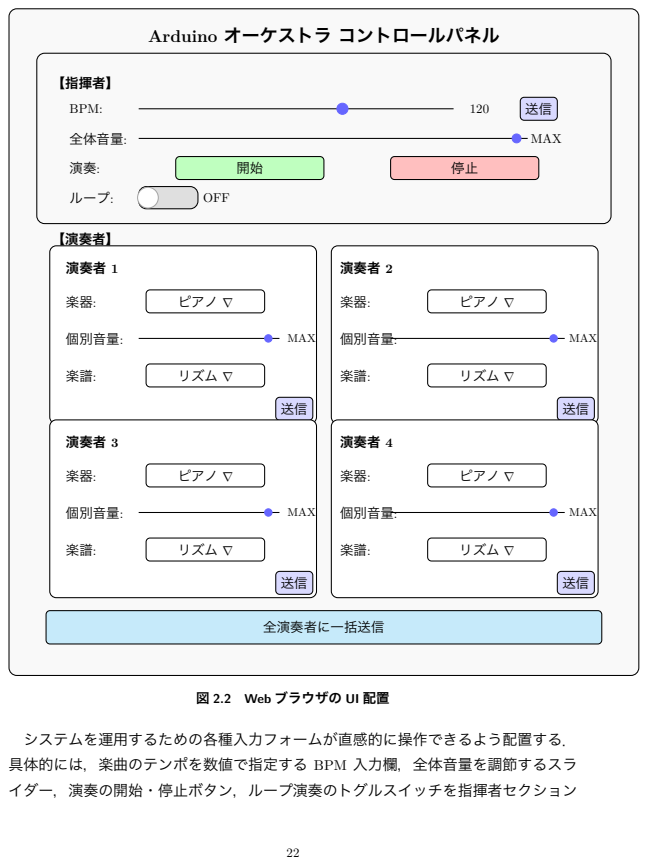
[picture p8: page 25]
【指揮者】; BPM:; 全体音量:; MAX; ループ:; OFF; 【演奏者】; 演奏者 1; ピアノ ∇; 個別音量:; リズム ∇; 演奏者 2; 演奏者 3; 演奏者 4; 全演奏者に一括送信

Arduino オーケストラ コントロールパネル

サーバー IP: 192.168.xx.xx

図 2.2 Web ブラウザの UI 配置

システムを運用するための各種入力フォームが直感的に操作できるよう配置する．
具体的には，楽曲のテンポを数値で指定する BPM 入力欄，全体音量を調節するスラ
イダー，演奏の開始・停止ボタン，ループ演奏のトグルスイッチを指揮者セクション

に配置する．また，演奏者ごとに楽器の変更，個別音量の調節，楽譜の選択が行え る演奏者カードを設ける．入力された各種パラメータは，送信ボタンを押すことで HTTP 通信によって Arduino へ送信される仕組みである． 一方，予備系統のインターフェースとして，ネットワーク障害や PC の不具合等に より Web UI が利用不可能な事態を想定し，指揮者用 Arduino に直接接続された可変 抵抗を用いた物理的な操作機構を用意する．可変抵抗を操作することによって生じる アナログ電圧の変化を Arduino の A/D コンバータで読み取り，その数値を BPM に マッピングすることで，直感的なテンポ制御を可能とする．これにより，不測の事態 においても合奏の続行は担保することができる設計となっている．

## 2.4 状態遷移図

本システムの中心となる指揮者用 Arduino は，外部からの入力に応じて複数の状態 を遷移しながら動作を継続する．図 2.3 にその詳細な状態遷移を示す．システムの 電源投入および初期設定の完了後，デバイスは「待機・定周期点滅状態」へと移行 し，接続要求を待つ．この状態において Web ブラウザから BPM 情報を受信した場合 「BPM 更新処理」へと遷移し，内部変数の書き換えが完了した後に再び待機状態へと 復帰する．
また，指揮者用 Arduino に搭載された物理スイッチが押下（ON）されると，システ ムは「演奏・同期信号送出状態」へと移行し，設定された BPM に基づいた光信号の 送出を開始する．演奏中に再度スイッチが押下（OFF）される，あるいは Web ブラ ウザから停止命令を受信した場合には，信号送出を停止して初期の待機状態へと遷移 する仕組みである．

23

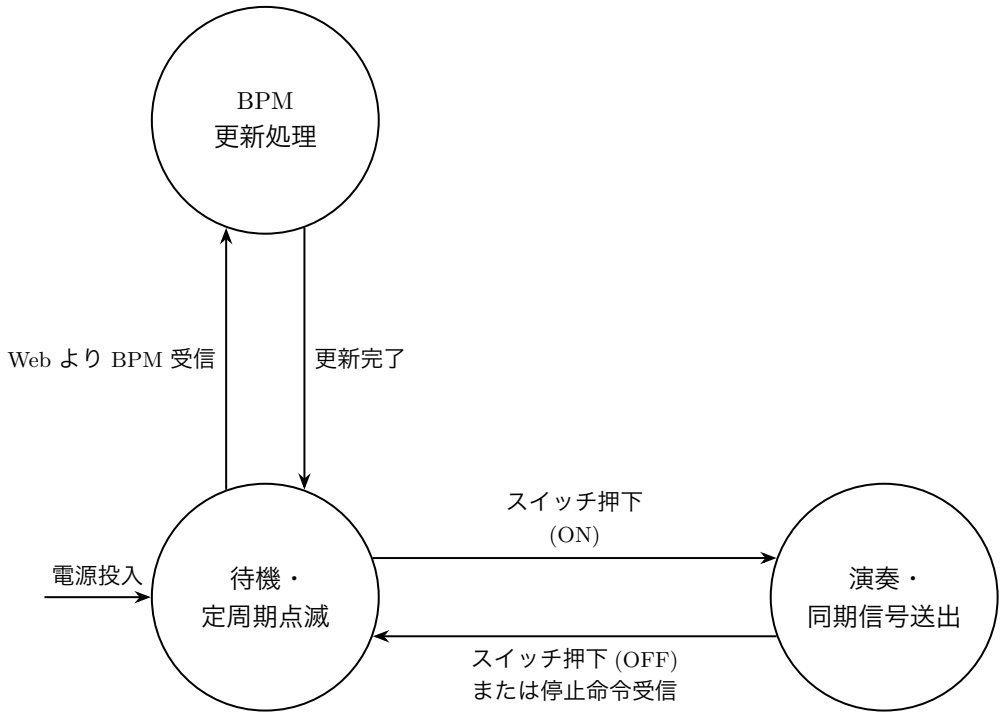
[picture p9: figure]
待機・ 定周期点滅; BPM 更新処理; 演奏・ 同期信号送出; 電源投入; Web より BPM 受信; 更新完了; スイッチ押下; スイッチ押下 (OFF) または停止命令受信

図 2.3 指揮者 Arduino の状態遷移図

24

# 第 3 章 システムの詳細設計

## 3.1 部品一覧

本システムを構築するために使用する主要なハードウェア部品の一覧を表 3.1 に 示す．

25

表 3.1 本システムの主要部品一覧
部品名 | 型番・仕様 | 用途および選定理由
マ イ ク ロ コ ン ト ローラ | Arduino Uno R4 WiFi | 指揮者側および演奏者側のメイン制御を行う． PC とのシリアル通信や，センサ・LED の高速 な制御に必要な処理能力を満たす．
カラーセンサ | TCS34725 | 演奏者側デバイスにおいて，指揮者側からの光 信号（発光色および光量）を読み取るために使 用する．RGB 値に加えて Clear 値（光量そのも のの値）を直接出力できる特性を持つため，音 量計算用の値を直接測定することができ，処理 負荷の軽減が期待できる点が選定の決め手と なった．
フルカラー LED | OSTA5131A-R/PG/B | 指揮者側デバイスにおいて，演奏開始・停止， テンポ，および音量の各情報を，発光色，点滅 間隔，光強度という光信号に変換して空間へ送 出するために使用する．
LED マトリクス | 8×8 ドット | 演奏者側デバイスにおいて，楽曲の進行に合わ せて歌詞を表示する演出用ディスプレイとして 使用する．解像度の制約上，カタカナを一文字 ずつ描画する．Arduino Uno R4 WiFi 内蔵のも のを利用する．
物理スイッチ | タクトスイッ チ | 指揮者側デバイスにおいて，システム全体の合 奏を物理的に起動および停止させるためのトリ ガー入力として使用する．
可変抵抗 | ポ テ ン シ ョ メータ | Web インターフェースがネットワーク障害等 で使用できない場合の予備系統として用意す る．ツマミの回転によるアナログ電圧変化を BPM 制御に利用する．

26

## 3.2 ハードウェア設計

本システムのハードウェアは，図 3.1 に示すように，独立した指揮者デバイスと演 奏者デバイスの 2 種類の筐体で構成される．本ハードウェア構成にした理由は，指揮 者の出す LED 同期信号を複数の演奏者が同時に受信し遅延を減少させることを目的 としたため，図 3.1 のように構成した．

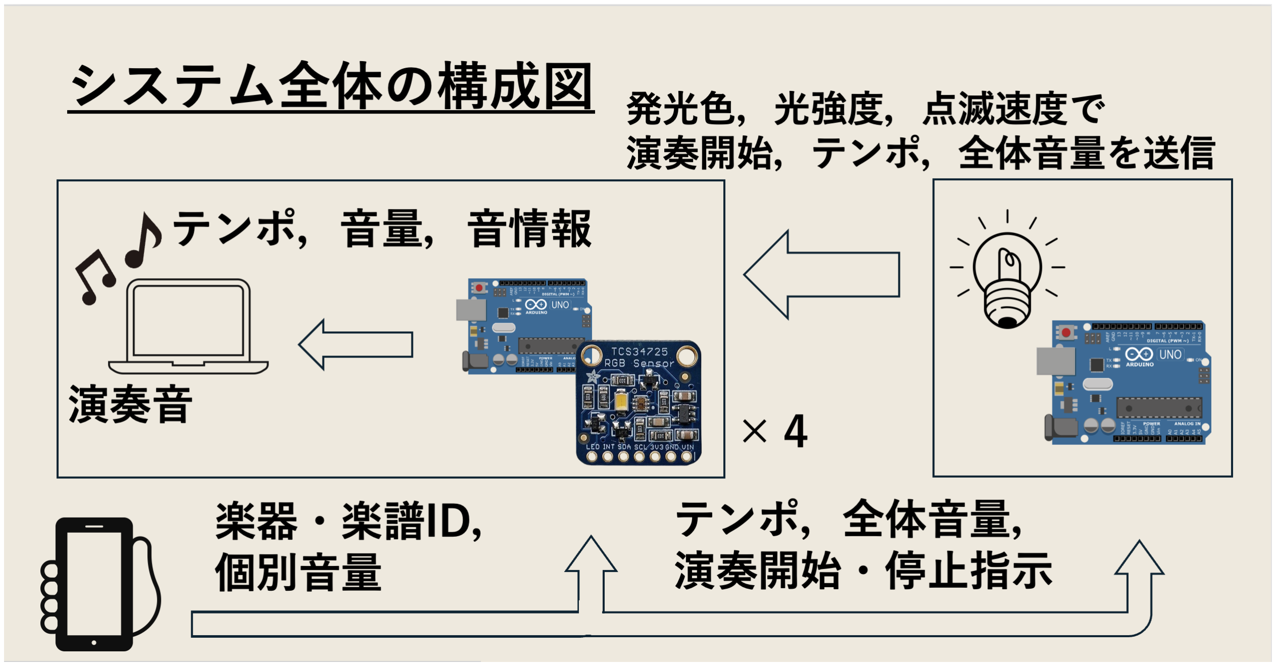
[picture p10: figure]

図 3.1 指揮者および演奏者デバイスの構成図

また，本システムの LED 通信部の指揮者，演奏者 Arduino の回路図を図 3.2 に示 す．指揮者デバイスでは，フルカラー LED 赤，青，緑のピンを Arduino の D9，D10， D11 ピンへ接続し，PWM 制御によって発光色及び光強度を制御する．演奏者デバイ スでは，カラーセンサと I2C 通信を行うため，Arduino で用意されている SDA，SCL， 電源，2 つの GND ピンを用いて受光機能を実現する．このとき，電圧はカラーセン サごとの最大電圧に応じて決定する．

27

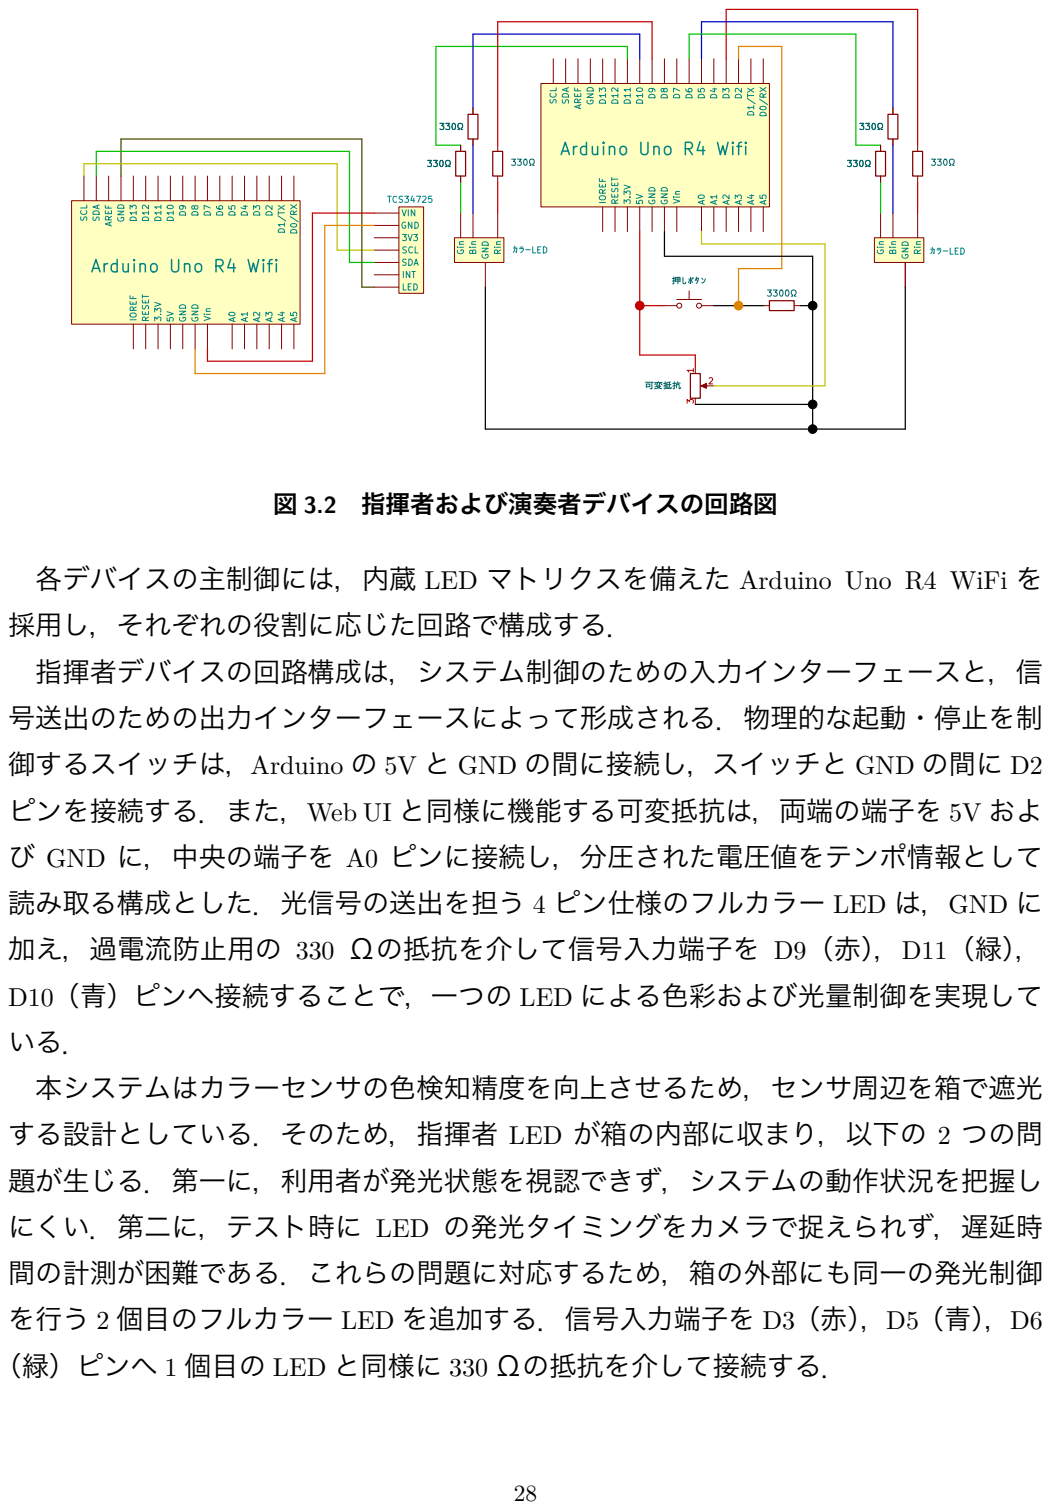
[picture p11: page 31]

Arduino Uno R4 Wifi RESET

各デバイスの主制御には，内蔵 LED マトリクスを備えた Arduino Uno R4 WiFi を
採用し，それぞれの役割に応じた回路で構成する．
指揮者デバイスの回路構成は，システム制御のための入力インターフェースと，信
号送出のための出力インターフェースによって形成される．物理的な起動・停止を制
御するスイッチは，Arduino の 5V と GND の間に接続し，スイッチと GND の間に D2
ピンを接続する．また，Web UI と同様に機能する可変抵抗は，両端の端子を 5V およ
び GND に，中央の端子を A0 ピンに接続し，分圧された電圧値をテンポ情報として
読み取る構成とした．光信号の送出を担う 4 ピン仕様のフルカラー LED は，GND に
加え，過電流防止用の 330 Ωの抵抗を介して信号入力端子を D9（赤），D11（緑），
D10（青）ピンへ接続することで，一つの LED による色彩および光量制御を実現して
本システムはカラーセンサの色検知精度を向上させるため，センサ周辺を箱で遮光
する設計としている．そのため，指揮者 LED が箱の内部に収まり，以下の 2 つの問
題が生じる．第一に，利用者が発光状態を視認できず，システムの動作状況を把握し
にくい．第二に，テスト時に LED の発光タイミングをカメラで捉えられず，遅延時
間の計測が困難である．これらの問題に対応するため，箱の外部にも同一の発光制御
を行う 2 個目のフルカラー LED を追加する．信号入力端子を D3（赤），D5（青），D6
（緑）ピンへ 1 個目の LED と同様に 330 Ωの抵抗を介して接続する．

一方，演奏者デバイスの回路構成は，受光および視覚的フィードバックに特化した 設計となっている．指揮者側からの光信号を検知するカラーセンサは，I2C 通信イン ターフェースを利用して接続される．具体的には，モジュールの VIN および GND を Arduino の 5V および GND へ接続し，SDA および SCL ピンをそれぞれの通信専用ピ ンへと結線している．またモジュールの LED もモジュールに付属している LED が発 光するのを防ぐため，GND に接続している．

## 3.3 ソフトウェア設計

### 3.3.1 ファイル構成

本システムのソフトウェアは，指揮者デバイス，演奏者デバイス，および PC 上で 動作する音声再生プログラム，Web サイトでの演奏制御プログラムの 4 種類によって 構成される．各プログラムの主要ファイルを表 3.2 に示す．

表 3.2 ソフトウェアのファイル構成

ファイル名 | 動作環境 | 主な処理内容
conductor.ino | 指揮者 Arduino | BPM 取得，LED 発光制御，演奏開始・停止制御，Web 受信処理を行う．
playerRGBMethod.ino | 演奏者 Arduino | カラーセンサによる光信号受信，色判定，音情報のシリアル送信，Web 受信処理を行う．
soundPlayer.pde | Processing | Arduino から受信した音情報に基づき，楽器音の再生および制御を行う．
lyrics.h | 演奏者 Arduino | LED マトリクスに表示する歌詞データ，楽譜データを管理する．
index.html | PC | 利用者が楽器やテンポ等の演奏パラメータを選択するための操作画面を定義する．
script.js | PC | 送信ボタン押下時に設定値を JSON 形式でサーバーへ送信する処理を担う．
server.js | PC | Node.js 環境で動作し，ブラウザからの要求を各 Arduino へ中継する．

### 3.3.2 通信設計

### 3.3.2.1 LED 通信

指揮者 Arduino と演奏者 Arduino 間での通信の内容と方法を示す．この区間での通 信内容は，表 3.3 のように LED の点滅によるテンポ，点灯時のピーク時の光量による 全体音量，LED の発光色による演奏者 Arduino ごとの開始タイミングである．

29

表 3.3 LED 通信内容
送信データ | LED 表現 | 受信側処理
テンポ (bpm) | 指 揮 者 の 保 持 す る bpm に応じて LED を 点滅 | 前回 LED 全体の光量が閾値を超えた ときとの時間差で計算する．
全体音量 | 音量を光量で制御す る． | ピーク時の CLEAR 値を CLEAR_MAX_LOW から CLEAR_MAX_HIGH の範囲で 20〜 100 にリスケーリングし，個別音量倍 率をかけて音量を算出する．
Arduino ご と の 開始タイミング | 特定の LED の色を演 奏者の開始タイミン グとして設定する． | 紫，赤，青，緑を受光した RGB 値の閾 値で判別し，各色に対応する Arduino を識別する．自身の担当色を検出した Arduino が，Web サイトから事前に受 信した楽器 ID に従って音再生を開始 する．

### 3.3.2.2 シリアル通信

演奏者 Arduino と楽器演奏用の Processing 間での通信の内容と方法を示す．送信内 容は，表 3.4 のように，楽器変更，音再生のために音高，音量，音の長さ，楽器 ID を

送信する．この区間の通信は Arduino と Processing 側の PC を USB Type-C で繋げ，
シリアル通信を行う．シリアル通信の送受信は，データ転送レート bps(baud) を合わ

せる．送信は serial.write(buf,len) を用いて行う．Serial.write は 1 Byte ずつデータを送
ることができ，本送信データは合計 4 Byte 以下であるため，4 つの 1 Byte 配列で送 信する．そのため，図 3.3 のように，通信データをビットシフトで非負 32 bit 整数に 入れ込み，バイト配列に入れていく．受信は，SerialEvent 関数を用いて 4 Byte 受け 取ったら，データを取り出し音を再生する．

30

表 3.4 送信内容
送信データ | 送信内容 | 送信ビット数
音高 (pitch) | ドレミファソラシドを (0-31) に対応し送信 | 6 bit
音量 (volume) | 音量を (0-100) で送信 | 7 bit
音の長さ (duration) | 一音の長さを (0-4095)ms で送信 | 12 bit
楽器 ID(instrumentData) | ピアノ・バイオリン・フルート・パーカッションを (0-3) に対応し送信 | 2 bit

uint32_t data

音の長さ 12bit | 音量 7bit | 音高 6bit 楽器ID
2bit 余り
d | v1 | v2 | v3 | v4 | v5 | v6 | v7 | p1 | p2 | p3 | p4 1 | d2 | d3 | d4 | d5 | d6 | d7 | d8 | d9 | d10 | d11 | d12 i 1 | i 2
v4 | v5 | v6 | v7 | p1 | p2 | p3 | p4 d | v1 | v2 | v3 i 2 | d1 | d2 | d3 | d4 | d5 | d6 | 8 | d9 | d10 | d11 | d12 i 1 | d7

送信データ uint8_t buf[4]
buf[0] | buf[1] | buf[2] | buf[3]
p5 | p6
p5 | p6

図 3.3 Byte 配列での送信方法

### 3.3.3 LED マトリクスへの歌詞表示

エンターテイメントとして演奏者 Arduino に現在の再生している音に対応した歌詞 を表示させる．データは演奏者 Arduino が保持し，表示内容は図 3.4 のように Arduino の LED マトリクスへカタカナを表示させる．表示タイミングは全体の演奏の遅延を 考慮して，演奏者 Arduino から Processing へ音情報を送信した後に歌詞を表示させ る．データとしては，表 3.5 のように各文字ごとの配列と曲全体の歌詞配列を持つ． このとき，歌詞データは楽譜情報と同じ要素数を持ち，同じインデックスを共有して 使用する．それぞれの文字は，定数で 32 ビットの符号なし整数型であり，16 進数の 3 要素で LED マトリクスの 96 bit を表現している．マトリクスをコード内で使用す るために必要な関数などを表 3.6 に示す．LED マトリクス用のヘッダファイルと楽譜

31

情報の入った lyrics ヘッダファイルをインクルードし，オブジェクトを作成する．

セットアップ関数内で Serial.begin を呼び出し，matrix.loadFrame 関数で表示する．


図 3.4 LED マトリクスに 1 文字ずつ表示

表 3.5 歌詞データ
型 | 配列名 | 要素内容 | データ
const uint32_t | ka[3] | カタカナの「カ」 | 0x201f, 0xc0240240, 0x4404408c
const uint32_t | e[3] | カタカナの「エ」 | 0x1f004, 0x400400, 0x400403f8
const uint32_t∗ | lyrics[] | カエルの歌全体の歌詞 | ka, e, ru,..

表 3.6 LED マトリクスを使用するためのコード
コード | 場所 | 内容
#include "Arduino_LED_Matrix.h" | コード先頭 | LED マトリクスを使用するためのヘッダファイル

#include "lyrics.h" | コード先頭 | 歌詞データを格納したヘッダファイル

ArduinoLEDMatrix matrix | コード先頭 | オブジェクトを作成
matrix.begin() | setup 関数内 | LED Matrix を開始
matrix.loadFrame(lyrics[index]) | loop 関数内 | 表示させたい文字配列を引数で指定し表示する．

32

### 3.3.4 音生成・再生

楽器音は Processing のオーディオライブラリ Minim を使用し，各楽器の音色特性に 応じて，波形，倍音，ノイズ成分，エンベロープを組み合わせて生成する． ピアノ・バイオリン・フルートの音色生成には加算合成を用いる．加算合成とは， 複数のサイン波（基音および倍音）を重ね合わせることで任意の音色を表現する手法 であり，出力波形 y(t) は式 (3.1) で表される．

y(t) = X

N

n=1

An sin(2πnf0t) | (3.1)

ここで，f0 は基音周波数，n は倍音次数，An は各倍音の振幅である．An の組み合 わせを楽器ごとに変えることで音色の違いを表現する．パーカッションはノイズ成分 と低周波サイン波を組み合わせて打撃音を生成する．
各楽器の倍音構成 An は，実際の楽器音の録音データに対して FFT（高速フーリ エ変換）を適用し，得られた周波数スペクトルから基音および各倍音成分の振幅を 読み取ることで決定する．また，録音データ全体の振幅を解析し，Attack，Decay， Sustain，Release の各パラメータを取得する．取得した ADSR パラメータは，振幅の 時間変化として波形生成に反映する．

### 3.3.5 受光機能

### 3.3.5.1 点滅間隔計測

LED の点滅間隔を計測することで，演奏テンポの取得を行う．clear 値が閾値を超 えた時刻を記録し，連続する 2 回の検出時刻の差を点滅間隔として算出する．この値 を演奏タイミング制御へ利用する．
図 3.5 に点滅間隔計測の概要を示す．

33

# 受光機能(点滅間隔の計測)

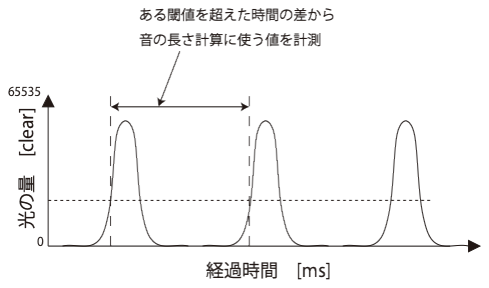
[picture p12: figure]

図 3.5 点滅間隔計測の概要

### 3.3.5.2 光量ピーク検出

受光した光量値の最大値を利用することで，演奏音量の制御を行う．受光した光が 強いほど大きな音量，弱いほど小さな音量となるように設定することで，光強度に応 じた演奏表現を可能とする．
図 3.6 に光量最大値計測の概要を示す．

34

# 受光機能(光量最大値の計測)

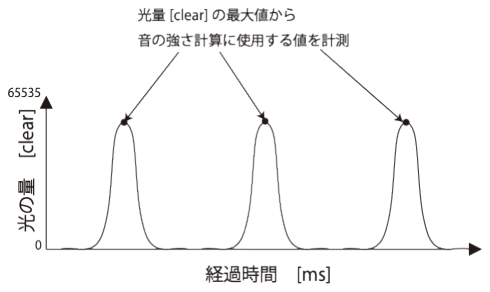
[picture p13: figure]

図 3.6 光量最大値計測の概要

### 3.3.5.3 発光色の識別

カラーセンサから取得した RGB 値を用いて，発光色の識別を行う．本システム では赤・緑・青・紫の 4 色を使用し，各色に異なる Arduino を割り当てる．演奏者 Arduino は割り当てられた色を検出したら，演奏を開始する．一度自色を検出した後 は，以降の点滅に対して色判定を行わず点滅検出のみで楽譜を進行させる．色の判定 は RGB 値そのものではなく，図 3.7 に示すように各成分の割合（R/(R+G+B) など） が事前測定により決定した閾値を上回るか下回るかによって行う．具体的には，R 成 分の割合が閾値以上かつ G・B 成分の割合が閾値以下の場合を赤と判定するなど，各 色に対応する RGB 割合の条件を図 3.8 に示す方法で事前測定により決定し，色識別 を行う．

35

R 値

## R 値 +G 値 +B 値

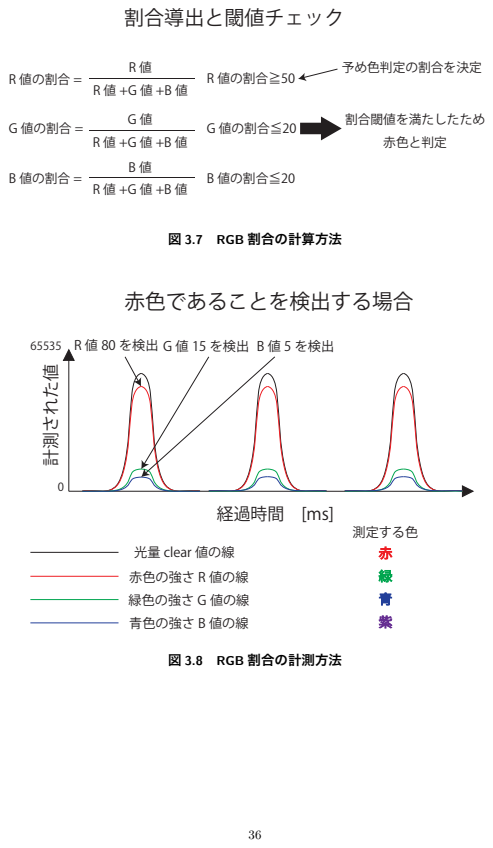
[picture p14: page 39]
R 値の割合 =; G 値の割合 =; B 値の割合 =; 割合導出と閾値チェック; R 値の割合≧50; G 値の割合≦20; B 値の割合≦20; 割合閾値を満たしたため 赤色と判定; 予め色判定の割合を決定; 図 3.7 RGB 割合の計算方法; 経過時間 [ms]; R 値 80 を検出; 赤色であることを検出する場合; B 値 5 を検出; 計測された値; G 値 15 を検出; 測定する色 赤 緑 青 紫; 図 3.8 RGB 割合の計測方法

光量 clear 値の線
赤色の強さ R 値の線
緑色の強さ G 値の線
青色の強さ B 値の線

## 3.4 スイッチによる入力制御の詳細設計

本節では，指揮者デバイスにおける物理入力，すなわち演奏の起動・停止を担うタ クトスイッチと，予備系統としてテンポを制御する可変抵抗について，その具体的な 入力制御の方法を述べる．これらの入力は，図 2.1 に示すシステム構成のうち，指揮 者 Arduino への入力インターフェースに該当する．以降の設計は，検証用に実装した 指揮者デバイスの入力制御プログラム（LED_switch.ino）の動作を基にしている．

### 3.4.1 入力ピンの割り当てと初期設定

指揮者デバイスでは，タクトスイッチ，可変抵抗，および同期用 LED をそれぞれ 独立したピンに割り当てる．各入力の接続および設定方法を表 3.7 に示す．

表 3.7 指揮者デバイスの入力ピン割り当てと設定
入力要素 | ピン | 設定および接続方法
タクトスイッチ | D2 | INPUT_PULLUP に設定し，内部プルアップ抵 抗を有効化する．スイッチの他端を GND へ 接続し，外付け抵抗を不要とするとともに ノイズによる誤検出を抑制する．
可変抵抗 | A0 | INPUT に設定し，A/D コンバータでアナロ グ電圧を読み取る．3 端子の可変抵抗（ポテ ンショメータ）を用い，両端の端子を 5V・ GND に，中央端子（ワイパ）を A0 へ接続す ることで，可変抵抗自体が分圧器として機 能し，ツマミ位置に応じた電圧をテンポ情 報として取得する（3.4.3 項参照）．
同期用 LED | D9,D11,D10 | OUTPUT に設定し，analogWrite による PWM 制御で発光の ON/OFF および光強度を制御 する．
同 期 用 LED（箱 外） | D3,D5,D6 | 箱内 LED と同一の制御信号を出力する．利 用者への視覚フィードバックおよびテスト 時の遅延計測を目的として追加する．

37

タクトスイッチを INPUT_PULLUP とすることで，スイッチが押されていないときは 入力が HIGH，押されたときに GND へ落ちて LOW となる．プログラム上では，押下 を真として扱うために読み取り値を論理反転し，「押下時に true」となる状態変数と して保持する．

### 3.4.2 可変抵抗によるテンポ入力

可変抵抗から読み取ったアナログ値を，演奏テンポ（BPM）および同期用 LED の 点滅間隔へ変換する．A/D コンバータは入力電圧を 0〜1023 の整数値として出力す る．この入力値 v を，演奏に用いるテンポ範囲 30〜240 BPM へ対応させる．変換後 の BPM B は式 (3.2) で与えられる．

B = 30 +

240 − 30
1023
v | (3.2)

得られた BPM から，同期用 LED が 1 回点滅する周期（点灯と消灯を合わせた時 間）Tpulse [ms] を式 (3.3) により算出する．本設計では，1 拍を 2 分割した 8 分音符の 間隔で点滅させる．

Tpulse =

60000
B × 2

(3.3)

ここで，1 回の点滅における点灯時間は，テンポによらず短い固定値 Ton（本設計 では 20 ms）とし，残りの時間 Tpulse − Ton を消灯時間に充てる．このように点灯時間 を短縮することで，発光が鋭いパルス状となり，受光側のカラーセンサが点滅（テン ポ）を検出しやすくなる利点がある．
式 (3.2)・式 (3.3) により，可変抵抗のツマミ位置に応じて LED の点滅間隔が連続的 に変化し，ネットワークを介さずに直感的なテンポ制御を可能とする．可変抵抗の値 はメインループ内で常時読み取られ，演奏中のリアルタイムなテンポ変更にも対応 する．

### 3.4.3 可変抵抗による分圧の原理

前項のテンポ入力を成立させるには，ツマミの操作に応じて A0 ピンの電圧が連続 的に変化する必要がある．本設計では，図 3.9 に示すように，3 端子の可変抵抗（ポ テンショメータ）を分圧器として用いる．
3 端子の可変抵抗は，抵抗体の両端（端子 1・端子 3）と，抵抗体上を摺動するワイ

38

パ（端子 2）からなる．ワイパによって抵抗体は，端子 1 側の抵抗 Ra と端子 3 側の 抵抗 Rb の 2 つに分割される．ここで，端子 1 を電源電圧 Vcc（5 V），端子 3 を GND， ワイパを A0 ピンへ接続すると，A0 ピンの電圧 VA0 は式 (3.4) で与えられる．

VA0 = Vcc ·

Rb
Ra + Rb

(3.4)

ツマミを回すとワイパ位置が移動し，Ra と Rb の比が変化するため，式 (3.4) に 従って VA0 が 0 V から Vcc まで連続的に変化する．このように，可変抵抗 1 つで分圧 器が構成されるため，外付けの固定抵抗を別途追加する必要はない．この電圧変化を A/D コンバータで 0〜1023 の値として読み取り，式 (3.2) により BPM へ対応させる ことで，テンポの可変制御を実現する．

端子 1：Vcc (5 V)

端子 3：GND

端子 2（ワイパ）：A0 ピンへ

Ra

Rb

図 3.9 3 端子可変抵抗（ポテンショメータ）による分圧

### 3.4.4 タクトスイッチによる起動・停止制御

タクトスイッチは，押すたびに演奏の開始・停止が交互に切り替わるトグル動作と する．ここで，スイッチを「押している間 ON」とする単純な読み取りではなく，「押 された瞬間」のみを一度だけ検出してシステム状態を反転させる方式を採用する．こ れは，1 回の押下で複数回の切り替えが発生することを防ぐためである．

### 3.4.4.1 押下エッジの検出

押された瞬間を検出するため，直前のループでのスイッチ状態 sprev と現在のス イッチ状態 snow の 2 つを保持する．そして，sprev が非押下（false）かつ snow が押 下（true）へ変化した遷移を「押下の立ち上がりエッジ」として検出する．この立ち 上がりエッジが検出されたときにのみ，システム全体の ON/OFF 状態 Ssys を反転さ

39

せる．ループの末尾で sprev ← snow と更新することで，次回ループでの変化検出に備 える．

### 3.4.4.2 チャタリング（バウンス）対策

機械式スイッチでは，押下・開放の瞬間に接点が短時間振動し，意図しない複数回 の ON/OFF が発生するチャタリング（バウンス）が生じる．これを抑制するため， 状態を切り替えた時刻 tlast を記録し，前回の切り替えから一定時間 Tdeb（本設計では 定数として 50 ms を与える）が経過していない間は，新たな押下エッジを無効とする 時間的なフィルタリングを行う．すなわち，押下エッジの検出条件は式 (3.5) を満た す場合に限る．

¬sprev ∧ snow ∧ (tnow − tlast > Tdeb) | (3.5)

この時間判定は，押下エッジの検出条件と同一の条件式の中で評価する実装とし た．条件が成立した場合のみ Ssys を反転し，tlast を現在時刻 tnow で更新する．ここ で，経過時間の判定にはマイコンの起動からの経過ミリ秒を返す関数（millis）を用 い，処理を止めて待つブロッキング遅延を使わずに実装する．これにより，待機中も 可変抵抗の読み取りや LED 点滅などの他処理を継続したまま，1 回の物理的な押下 を確実に 1 回の状態遷移へ対応させることができる．

### 3.4.4.3 システム状態に応じた点滅制御

システム状態 Ssys が ON（true）のときのみ，同期用 LED を点滅させる．このと き，点灯状態では前回の切り替えからの経過時間が点灯時間 Ton を超えた時点で消灯 へ，消灯状態では経過時間が Tpulse − Ton を超えた時点で点灯へ切り替える．すなわ ち，短い点灯と相対的に長い消灯を交互に繰り返すことで，鋭いパルス状の発光を Tpulse の周期で送出する．点灯時の光強度は PWM のデューティ比により設定し，全 体音量に対応する光量として送出する．Ssys が OFF（false）のときは LED を消灯 し，点滅状態を初期化する．スイッチの読み取りと状態判定を高速に繰り返すため， メインループは短い周期で実行する構成とする．

40

### 3.4.5 入力制御の処理フロー

以上のタクトスイッチおよび可変抵抗による入力制御の流れを，図 3.10 に示す． 本処理はメインループ内で繰り返し実行され，可変抵抗値の読み取りによるテンポ

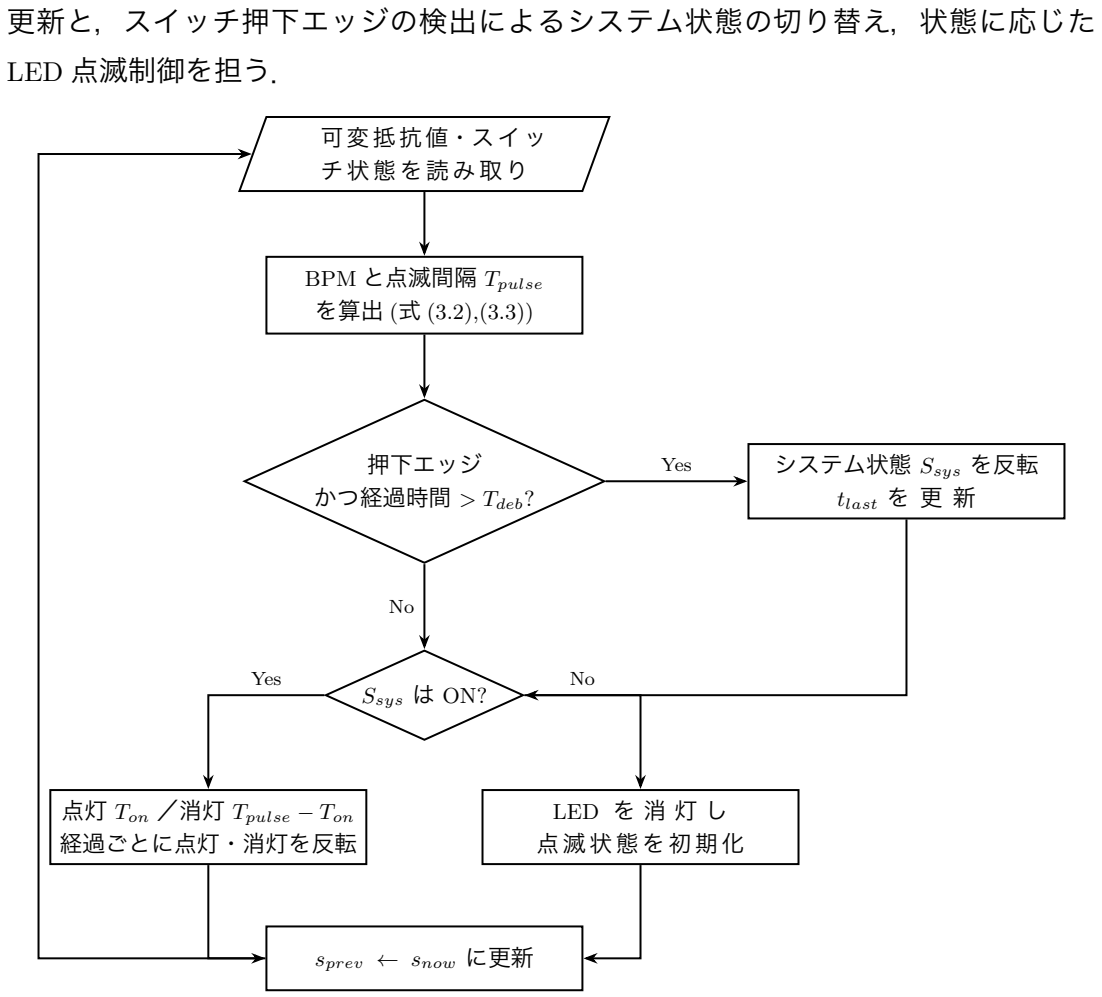
[picture p15: figure]
更新と，スイッチ押下エッジの検出によるシステム状態の切り替え，状態に応じた; LED 点滅制御を担う．; 可変抵抗値・スイッ チ状態を読み取り; BPM と点滅間隔 Tpulse; を算出 (式 (3.2),(3.3)); 押下エッジ かつ経過時間 > Tdeb?; システム状態 Ssys を反転; tlast を 更 新; Ssys は ON?; 点灯 Ton ／消灯 Tpulse − Ton 経過ごとに点灯・消灯を反転; LED を 消 灯 し 点滅状態を初期化; sprev ← snow に更新; Yes

図 3.10 タクトスイッチ・可変抵抗による入力制御の処理フロー

このように，本システムの起動・停止およびテンポ制御は，押下エッジ検出とチャ タリング対策を備えたトグル方式のスイッチ入力，ならびに可変抵抗のアナログ値を BPM へ線形変換するテンポ入力によって実現する．

41

### 3.4.6 オブジェクト設計 (クラス図)

全体で使用するクラスを図 3.11 に示す．使用するクラスは，楽器再生の Processing で使用する楽器クラスで構成されている．各楽器クラスは Instrument インタフェー

スを実装しており，PianoInst（ピアノ），FluteInst（フルート），ViolinInstrument
（バイオリン），SnareInstrument（スネアドラム）の 4 種類が定義されている．各ク ラスは playNoteFromData() 関数から楽器 ID に応じて呼び出され，音高・音量・音長 の情報をもとに，それぞれの音合成アルゴリズムで音を生成・出力する役割を持って いる．指揮者デバイス（conductor.ino）では，BPM や演奏状態などの変数を保持し， LED 発光制御・Web 受信・BPM 表示を制御する役割を持っている．演奏者デバイス （playerRGBMethod.ino）では，カラーセンサからの RGB 値や音符番号などの変数を 保持し，LED 同期による色判定・音情報の生成・シリアル送信を制御する役割を持っ ている．

42

LEDController

- int bpm; テンポ
- Color color; R,G,B値

+ void sendSignal(color);
colorのRGB値に応じて，
LEDのピンに電圧を出力．

void updateTempo(&bpm);
bpmに新しいテンポの値を
代入

SensorReader

- Color color; R,G,B値
- int brightness; LEDからの明るさの値
- unsigned long lastTempoTime; 最後にLEDを 受け取った時間．
- unsigned long noteNum; Processingへ送る楽 譜の音番号
- bool detectStart; 演奏をするかの判定
- unsigned long peakVol; ピーク値の電圧

+ void readLED(&color, &brightness); LEDから の情報を変数に代入する

+ int changeTempo
(&lastTempoTIme); lastTempoTimeを更新

+ int thresholdDetect(); 受け取ったRGB値が閾 値を超えているか．

+ void detectPlay();
受け取ったRGB値に応じてdetectStartをtrue または，演奏情報を送信.

+ bool peakDetect(); peakVolが下がったら false

+ sendSerial(peakVol): 送ったらpeakVolを0に する．

audioPlayer

- int instrument; 演奏楽器
- Note note; 音情報
- int bpm; テンポ

+ playback(instrument,
note, bpm); 再生のための情
報を引数として，演奏楽器
の音程をもらい，音を出
力．

図 3.11 役割ごとのクラス図

43

### 3.4.7 関数設計

表 3.8 LED 同期関連の関数設計
関数名 | 引数 | 戻り値 | 処理
applyLED(c, level) | c : 点灯色, level : 輝度 | void | フルカラー LED を指定した色・輝 度で点灯させる．（conductor.ino）
colorForPulse(pul-seIdx) | pulseIdx : パルス番号 | LightColor | パルス番号に対応する点灯色を 返す．（conductor.ino）
detectColorID(r, g, b) | r, g, b : RGB 値 | int | 受信した色情報が自分の担当色 と一致するか判定し，色 ID を返 す．一致しない場合は-1 を返す． （playerRGBMethod.ino）

表 3.9 シリアル通信関連の関数設計
関数名 | 引数 | 戻り値 | 処理
sendNote() | なし | void | 音高・音量・音長・楽器 ID を 32bit にパックしてシリアル通信で送 信 す る．（playerRGBMethod.ino）
serialEvent(p) | p : Serial オブジェクト | void | 受信した 4 バイトをシフト演 算 で 分 解 し，音 高・音 量・音 長・楽器 ID を変数へ格納する． （soundPlayer.pde）

表 3.10 LED マトリクス関連の関数設計
関数名 | 引数 | 戻り値 | 処理
showBPM(bpm) | bpm : BPM 値 | void | BPM の値を 3 桁の数字として LED マトリクスに表示する． （conductor.ino）
drawDigit(bitmap, digit, xOffset) | bitmap : 描 画 バ ッ ファ, digit : 表示する 数字, xOffset : X 方向 オフセット | void | LED マトリクスの描画バッファ に 1 桁の数字を書き込む．（con-ductor.ino）

44

表 3.11 音再生関連の関数設計
関数名 | 引数 | 戻り値 | 処理
playNoteFrom-Data(pi, vol, dur, inst) | pi : 音高, vol : 音量, dur : 音長, inst : 楽器 ID | void | 受信した音情報を基に，楽器 ID に応じた音色で音を再生する． （soundPlayer.pde）

表 3.12 Web 通信関連の関数設計
関数名 | 引数 | 戻り値 | 処理
handleWebRe-quest() | なし | void | Web サーバーからの HTTP リ ク エ ス ト を 受 信 し，BPM・音 量・演奏開始停止等のパラメー タを反映する．（conductor.ino / playerRGBMethod.ino）
sendHeartbeat() | なし | void | サーバーへ定期的に登録リク エ ス ト を 送 信 し，接 続 状 態 を 維持する．（conductor.ino / play-erRGBMethod.ino）
tryReconnect() | なし | void | 待機中にサーバーへの再登録を 試み，成功した場合は Web サー バーを起動する．（conductor.ino / playerRGBMethod.ino）
getWeb-Param(query, key) | query : クエリ文字列, key : パラメータ名 | int | クエリ文字列から指定キーの 値 を 取 り 出 す．存 在 し な い 場 合は-1 を返す．（conductor.ino / playerRGBMethod.ino）
enterStan-daloneMode() | なし | void | WiFi への接続またはサーバーへ の登録に失敗した場合に，WiFi 無しの単体動作モードへ移行 する．（conductor.ino）

## 3.5 処理フローの設計

図 3.12 に本システム全体のシーケンス図を示す．本システムは指揮者 Arduino，演

奏者 Arduino，Processing，Web サイトの 4 つで構成される．Web サイトから BPM，
全体音量，ループ，起動・停止信号を指揮者 Arduino が受信し，LED による光信号と して演奏者 Arduino へ送信する．また，楽器，楽譜，個別音量は Web サイトから演奏

45

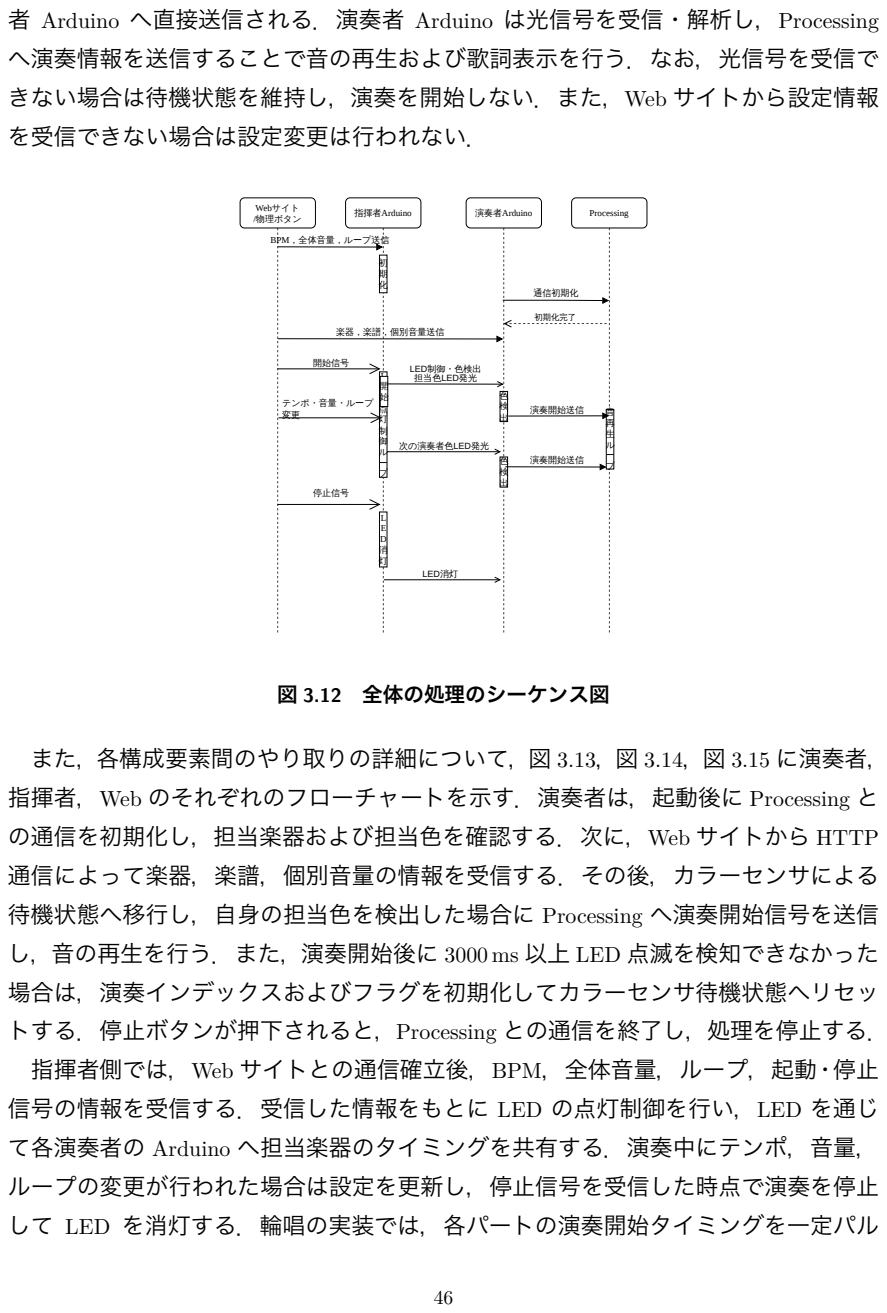
[picture p16: page 49]
指揮者Arduino; 演奏者Arduino; LED制御・色検出; 次の演奏者色LED発光; Processing; 初期化完了; Webサイト /物理ボタン; 通信初期化; 開始信号; 担当色LED発光; 演奏開始送信; 停止信号; LED消灯; 図 3.12 全体の処理のシーケンス図

者 Arduino へ直接送信される．演奏者 Arduino は光信号を受信・解析し，Processing
へ演奏情報を送信することで音の再生および歌詞表示を行う．なお，光信号を受信で
きない場合は待機状態を維持し，演奏を開始しない．また，Web サイトから設定情報
を受信できない場合は設定変更は行われない．

BPM，全体音量，ループ送信

楽器，楽譜，個別音量送信

テンポ・音量・ループ

また，各構成要素間のやり取りの詳細について，図 3.13，図 3.14，図 3.15 に演奏者，
指揮者，Web のそれぞれのフローチャートを示す．演奏者は，起動後に Processing と
の通信を初期化し，担当楽器および担当色を確認する．次に，Web サイトから HTTP
通信によって楽器，楽譜，個別音量の情報を受信する．その後，カラーセンサによる
待機状態へ移行し，自身の担当色を検出した場合に Processing へ演奏開始信号を送信
し，音の再生を行う．また，演奏開始後に 3000 ms 以上 LED 点滅を検知できなかった
場合は，演奏インデックスおよびフラグを初期化してカラーセンサ待機状態へリセッ
トする．停止ボタンが押下されると，Processing との通信を終了し，処理を停止する．
指揮者側では，Web サイトとの通信確立後，BPM，全体音量，ループ，起動・停止
信号の情報を受信する．受信した情報をもとに LED の点灯制御を行い，LED を通じ
て各演奏者の Arduino へ担当楽器のタイミングを共有する．演奏中にテンポ，音量，
ループの変更が行われた場合は設定を更新し，停止信号を受信した時点で演奏を停止
して LED を消灯する．輪唱の実装では，各パートの演奏開始タイミングを一定パル

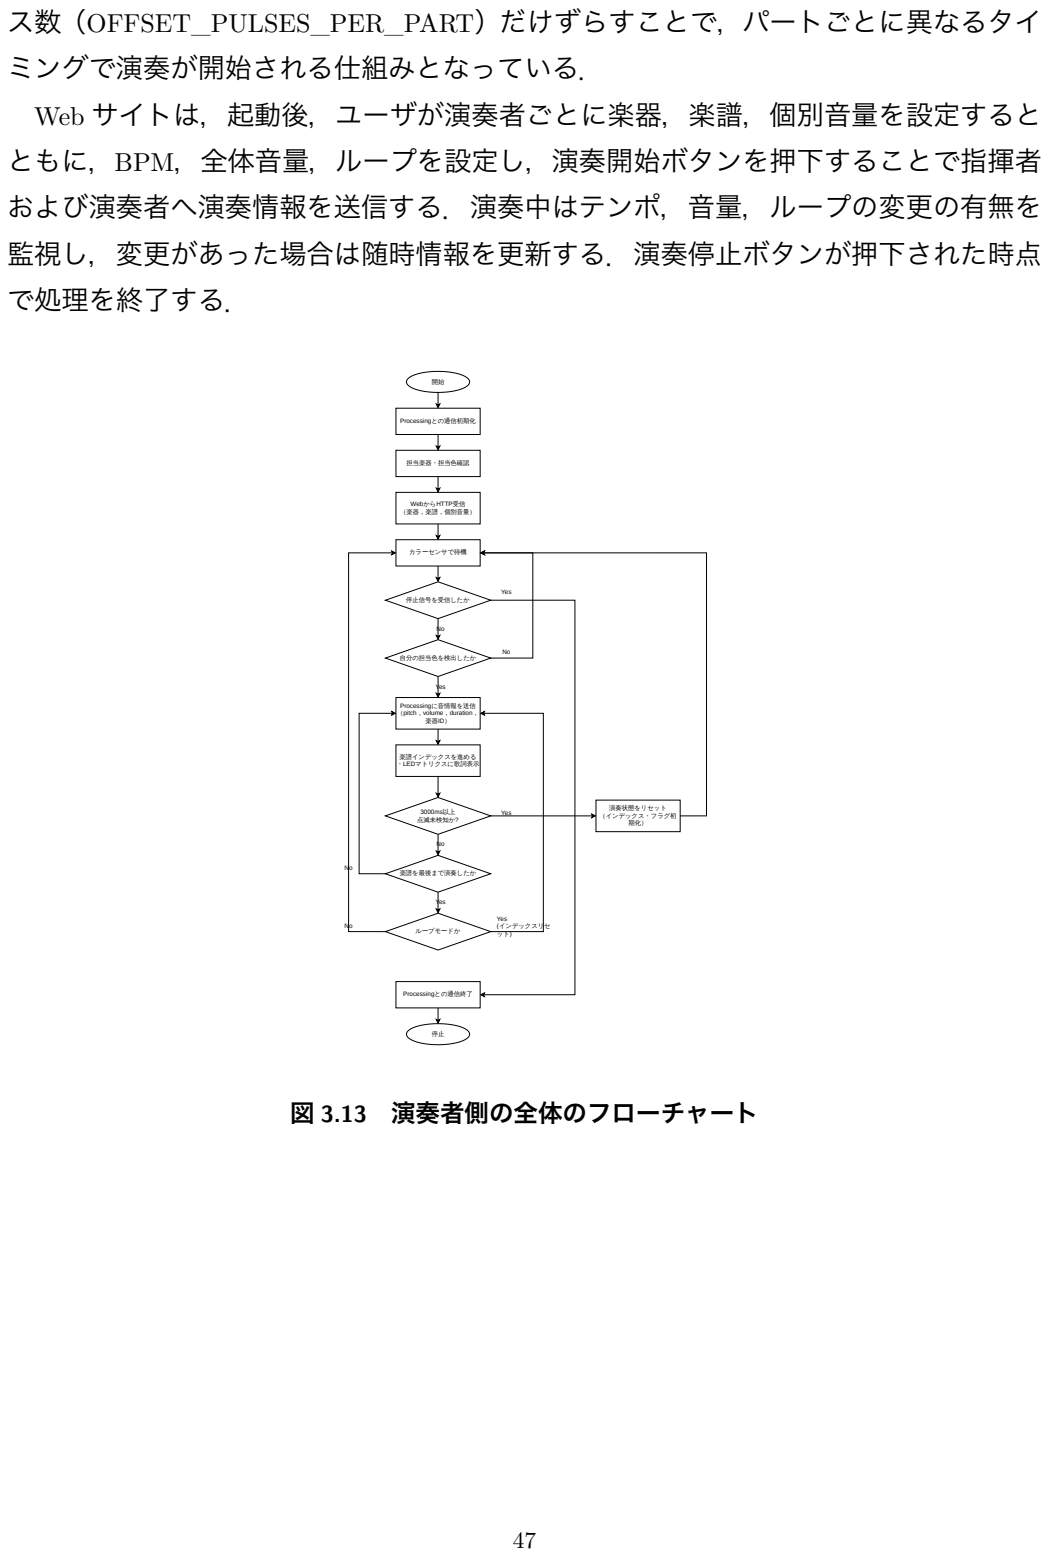
[picture p17: page 50]
Processingとの通信初期化; 担当楽器・担当色確認; カラーセンサで待機; 停止信号を受信したか; 自分の担当色を検出したか; 楽器ID）; 楽譜インデックスを進める ・LEDマトリクスに歌詞表示; 3000ms以上 点滅未検知か?; 演奏状態をリセット （インデックス・フラグ初 期化）; 楽譜を最後まで演奏したか; ループモードか; Processingとの通信終了; Yes; Yes (インデックスリセ ット); 図 3.13 演奏者側の全体のフローチャート

ス数（OFFSET_PULSES_PER_PART）だけずらすことで，パートごとに異なるタイ
ミングで演奏が開始される仕組みとなっている．
Web サイトは，起動後，ユーザが演奏者ごとに楽器，楽譜，個別音量を設定すると
ともに，BPM，全体音量，ループを設定し，演奏開始ボタンを押下することで指揮者
および演奏者へ演奏情報を送信する．演奏中はテンポ，音量，ループの変更の有無を
監視し，変更があった場合は随時情報を更新する．演奏停止ボタンが押下された時点
で処理を終了する．

WebからHTTP受信
（楽器，楽譜，個別音量）

Processingに音情報を送信
（pitch，volume，duration，

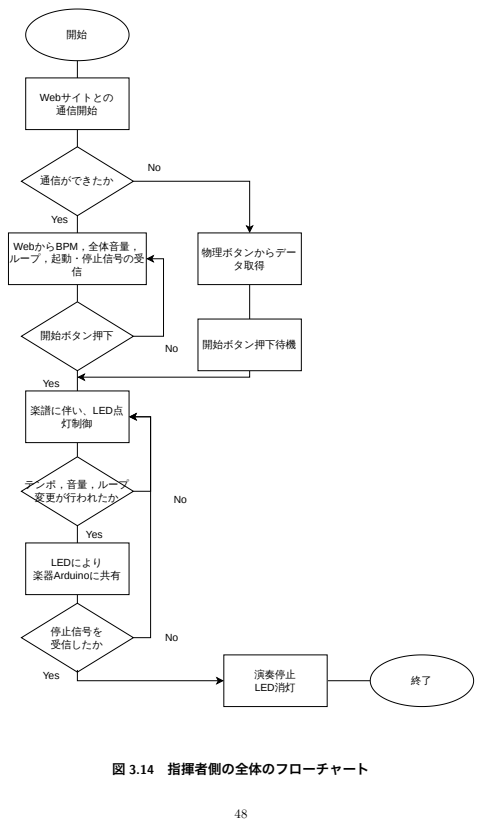
[picture p18: page 51]
Webサイトとの 通信開始; 楽譜に伴い、LED点 灯制御; 停止信号を 受信したか; 演奏停止; LED消灯; 開始ボタン押下; Yes; 通信ができたか; 物理ボタンからデー タ取得; 開始ボタン押下待機; LEDにより 楽器Arduinoに共有; 図 3.14 指揮者側の全体のフローチャート

WebからBPM，全体音量，
ループ，起動・停止信号の受

テンポ，音量，ループ
変更が行われたか

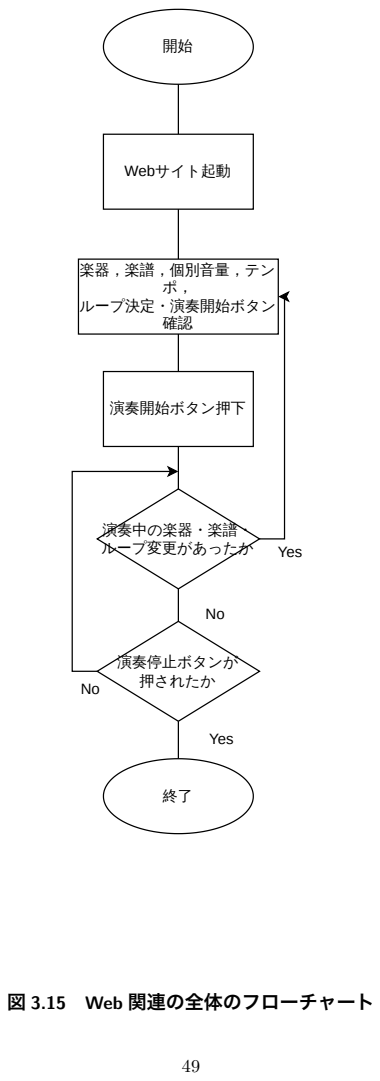
[picture p19: page 52]
ポ， ループ決定・演奏開始ボタン 確認; 演奏開始ボタン押下; 演奏中の楽器・楽譜・ ループ変更があったか; Webサイト起動; Yes; 演奏停止ボタンが 押されたか No; 図 3.15 Web 関連の全体のフローチャート

楽器，楽譜，個別音量，テン

## 3.6 テストの設計

### 3.6.1 システムテストの設計

(1) 光と音の発生時間差

スマートフォンまたはカメラのハイスピード撮影機能（240 fps 等）を使用し，指揮 者の LED と演奏者 PC のスピーカーが同一画面内に収まるよう動画を撮影する．撮 影した動画を PC 上の動画編集ソフトに読み込み，LED が発光したフレームから，ス ピーカーから音が出たフレームまでのフレーム数を計測し，時間差を算出する．

(2) 楽器間の同期ズレ
(1) と同様に，ハイスピード撮影を用いて複数の演奏者 PC のスピーカーを同一画 面内に収めて撮影する．撮影した動画から各演奏者の発音フレームを特定し，演奏者 間のフレーム差を時間に換算して同期ズレを算出する．
(3) Web サイト送信〜演奏反映までの遅延

以下の 2 種類の方法を併用して計測する．

•ハイスピード動画撮影による計測：
ハイスピード撮影機能を用いて，Web サイト画面と演奏者 PC のスピーカーが同 一画面内に収まるよう動画を撮影する．撮影した動画から，送信が実行されたフ レームから音が変化したフレームまでのフレーム数を計測し，遅延時間を算出 する．
•ログによるシステム計測：
Web サイト側で送信が実行された瞬間の UNIX タイムスタンプ（ミリ秒単位）を ログに記録する．同様に，演奏側プログラムにおいて，受信データの解析および テンポ変数等の書き換え処理が完了した瞬間のタイムスタンプを記録する．両タ イムスタンプの差分を遅延時間として算出する．なお，PC 間で時計が同期して いない場合は NTP による時刻同期を行うか，同一 PC 上でテストを実施する．

50

### 3.6.2 結合テストの設計

(1) 光同期のパケット損失率

LED を一定回数（2000 回）発光させ，受信側の光センサが正しく検知できた回数 および検知できなかった回数を目視により計数する．発光回数（総パケット数）に対 する検知失敗回数（損失パケット数）の割合をパケット損失率（IPLR）として算出 する．

(2) Web サイトのパケット損失率
Web サイトからテンポ変更や楽器指定などの制御コマンドを一定回数送信し，送信 ログと受信ログを出力する．両ログを比較し，総パケット数に対する損失パケット数 の割合（パケット損失率／ IPLR）を算出する．

### 3.6.3 単体テストの設計

(1) 音色の再現性
再現対象となる実際の楽器音の録音データと，本システムから出力された再現音の 録音データをそれぞれ用意する．比較の前処理として，両者の音量を RMS 正規化に より統一し，pYIN アルゴリズムで推定した F0 を用いて音程が一致していることを確 認する．その後，両者の音声波形データから，立ち上がり時間（AT），スペクトル重 心（SC），スペクトル変動度（DSV），奇偶倍音比（OER）の 4 つの音色特徴量を算出 する．AT は RMS エンベロープのピーク到達時間，SC は持続区間（25〜75%）のスペ クトル重心周波数，DSV はフレーム間 L2 相対変化量の平均，OER は pYIN で推定し た F0 を用いた Eodd/(Eodd + Eeven) として算出する．実際の楽器音と再現音の各特徴 量を比較し，それぞれの目標差以内であることを確認する．本テストは各楽器・音程 ごとに実施し，全結果の平均を取り評価する．
また，音色の評価に関して，AT・SC・DSV・OER の 4 つの音色特徴量の算出の他 にアンケートも同時に行う．作成した回答用フォームを用いた音色評価を実施し，そ の結果を元に評価を行う．この音色評価は，参加者に作成した音と実際の楽器の音を 聞き比べてもらい，目的音をどの程度再現できているかを以下の 5 段階で評価しても らう形式とする．

51

•5, 似ている
•4, どちらかといえば似ている
•3, どちらとも言えない
•2, どちらかといえば似ていない
•1, 似ていない

この 5 段階評価の平均値を用いて評価する．集計したものの平均が 3.51 以上の場 合，同意と解釈して良いという先行研究 [18] に基づき，集計結果の平均値が 3.51 以上 の場合に十分に音色を再現できたと評価する．
アンケートフォーム内には音色評価の他に，年代，音楽経験の有無，演奏環境につ いての質問も含まれる．年齢を収集する理由は，回答者の聴覚特性の違いが音色評価 に影響を与える可能性があるためである．
加齢に伴い高周波数帯域を中心とした聴覚特性の変化が生じることが示されており [19]，これが楽器音のような複雑な音の音質・音色知覚や主観評価に影響を及ぼすと 考えられる．したがって，評価データの偏りを防ぎ，年代ごとの知覚傾向を正しく分 析するために年齢の項目を設けた．
音楽経験の有無を収集する理由は，音楽に関する知識や訓練経験の違いが音色評価 に影響を与える可能性があるためである．音楽経験者は楽器音に接する機会が多く， 音色の特徴や違いを識別する能力が高いと考えられる．一方で，音楽経験のない回答 者は一般的な聴取者としての評価を行うため，両者の評価傾向に差が生じる可能性が ある．したがって，音楽経験の有無による評価傾向の違いを分析するために当該項目 を設けた．
視聴環境を収集する理由は，再生機器の特性の違いが音色評価に影響を与える可能 性があるためである．イヤホン，ヘッドホン，PC スピーカ，スマートフォン内蔵ス ピーカなどの再生機器は周波数特性や音圧特性が異なり，同一の音源であっても聴取 者が知覚する音質や音色が変化する場合がある．したがって，視聴環境による評価結 果への影響を分析し，必要に応じて評価結果の解釈に反映するために当該項目を設 けた．

52

## 参考文献

[1] 神田竜, 岩野成利, 片寄晴弘, 複数のモバイルデバイスを九十九神と見立てるイ ンタラクティブメディアアート：九 i 九 i 九, 情報処理学会論文誌, 53 巻, 3 号,

p1061-1068.
[2] 亀川 徹, 4-3 演奏時における音声遅延の検知限とその影響, 映像情報メディア学

会誌, 2015, 69 巻, 5 号, p. 408-411.

[3] 総務省, 情報通信白書令和 2 年版, 総務省, 2020, https://www.soumu.go.jp/

johotsusintokei/whitepaper/ja/r02/pdf/index.html， (https://www.soumu.go.jp/johotsusintokei/whitepaper/ja/r02/pdf/index.html) 2026 年 4 月 21 日参照.

[4] Fada Pan, Li Zhang, Yuhong Ou, and Xinni Zhang, "Audiovisual integration effect on

music emotion: Behavioral and physiological evidence," PLoS ONE, Vol. 14, No. 5, p.

e0217040, 2019.
[5] 新 誠一, 計測制御のための無線通信技術の現状と展望, 計測と制御, 2009, 48 巻, 7

号, p. 537-541．

[6] 若森 和彦, 光無線通信と画像伝送, 画像電子学会誌, 2011, 40 巻, 1 号, p. 257-263.
[7] International Telecommunication Union, [Recommendation] Relative timing of sound

and vision for broadcasting (Recommendation ITU-R BT.1359-1), ITU Radiocommu-

nication Assembly, 1998.

[8] A. D. Brown, G. C. Stecker, D. J. Tollin, "The Precedence Effect in Sound Localization,"

Journal of the Association for Research in Otolaryngology, Vol. 16, No. 1, pp. 1-28, 2015.

[9] R. B. Miller, "Response time in man-computer conversational transactions," in Proceed-

ings of the AFIPS Fall Joint Computer Conference, Vol. 33, pp. 267-277, 1968.

[10] International Telecommunication Union, "Network performance objectives for IP-

based services," ITU-T Recommendation Y.1541, 2011.

[11] S. McAdams, S. Winsberg, S. Donnadieu, G. De Soete, J. Krimphoff, "Perceptual

scaling of synthesized musical timbres: Common dimensions, specificities, and latent

subject classes," Psychological Research, Vol. 58, No. 3, pp. 177-192, 1995.

[12] K. Siedenburg, "Timbral and dynamic differentiability of musical instrument tones,"

The Journal of the Acoustical Society of America, Vol. 145, No. 2, pp. 1078-1087, 2019.

[13] C. Wun, A. Horner, C. Wu, "Timbre discrimination of musical instruments in melody,"

Journal of the Audio Engineering Society, Vol. 62, No. 9, pp. 575-583, 2014.

53

[14] A. Horner, J. Beauchamp, R. So, "Detection of random spectral variation in musical

instrument sounds," The Journal of the Acoustical Society of America, Vol. 116, No. 3,

pp. 1800-1810, 2004.

[15] M. Mauch and S. Dixon, "pYIN: A fundamental frequency estimator using probabilistic

threshold distributions," in Proc. IEEE International Conference on Acoustics, Speech

and Signal Processing (ICASSP), pp. 659-663, 2014.

[16] A. Caclin, S. McAdams, B. K. Smith, S. Winsberg, "Acoustic correlates of timbre

space dimensions: A confirmatory study using synthetic tones," The Journal of the

Acoustical Society of America, Vol. 118, No. 1, pp. 471-482, 2005.

[17] S. McAdams, S. Winsberg, S. Donnadieu, G. De Soete, J. Krimphoff, "Perceptual

scaling of synthesized musical timbres: Common dimensions, specificities, and latent

subject classes," Psychological Research, Vol. 58, No. 3, pp. 177-192, 1995.

[18] J. R. Lindner, N. J. Lindner, "Interpreting Likert-type Scales, Summated Scales, Uni-

dimensional Scales, and Attitudinal Scales: I neither Agree nor Disagree, Likert or

Not," Advancements in Agricultural Development, Vol. 5, No. 2, 2024.
[19] 入野 俊夫, 加齢性難聴の模擬による聴覚特性理解へのアプローチ, 日本音響学会

誌, 2025, 81 巻, 5 号, p. 352-359.

54
