crab2424/LEDplaying_system/チーム内部資料/7_3_23時計画書/img/configuration_diagram.pdf

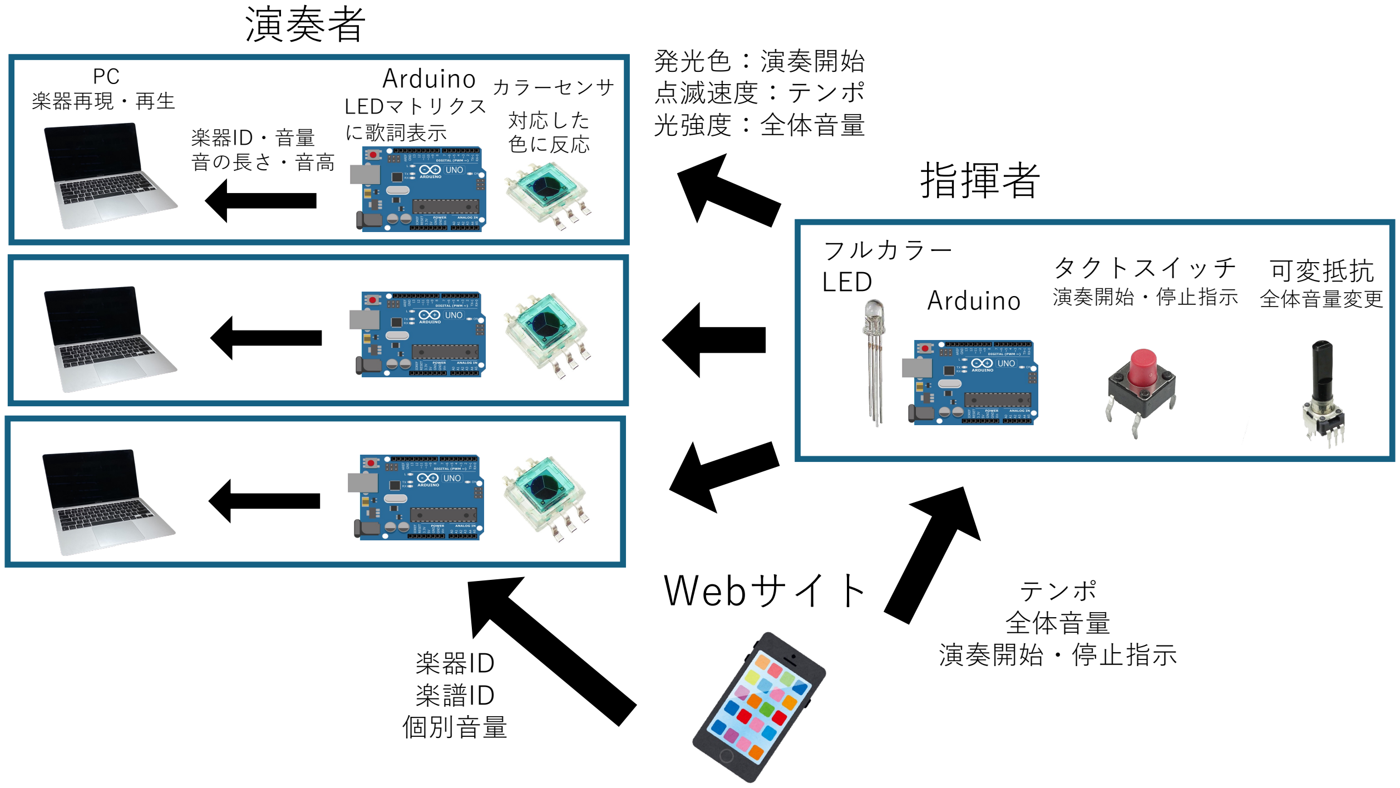
[picture p20: figure]
Arduino LEDマトリクス に歌詞表⽰; カラーセンサ; 楽器ID・⾳量 ⾳の⻑さ・⾳⾼; PC 楽器再現・再⽣; 演奏者; フルカラー LED; 指揮者; 発光⾊：演奏開始 点滅速度：テンポ; 対応した; 光強度：全体⾳量 ⾊に反応; Webサイト; テンポ; 楽器ID; 演奏開始・停⽌指⽰; 楽譜ID 個別⾳量; Arduino; タクトスイッチ 演奏開始・停⽌指⽰; 可変抵抗 全体⾳量変更
