crab2424/LEDplaying_system/チーム内部資料/7_3_23時計画書/img/FBS.pdf

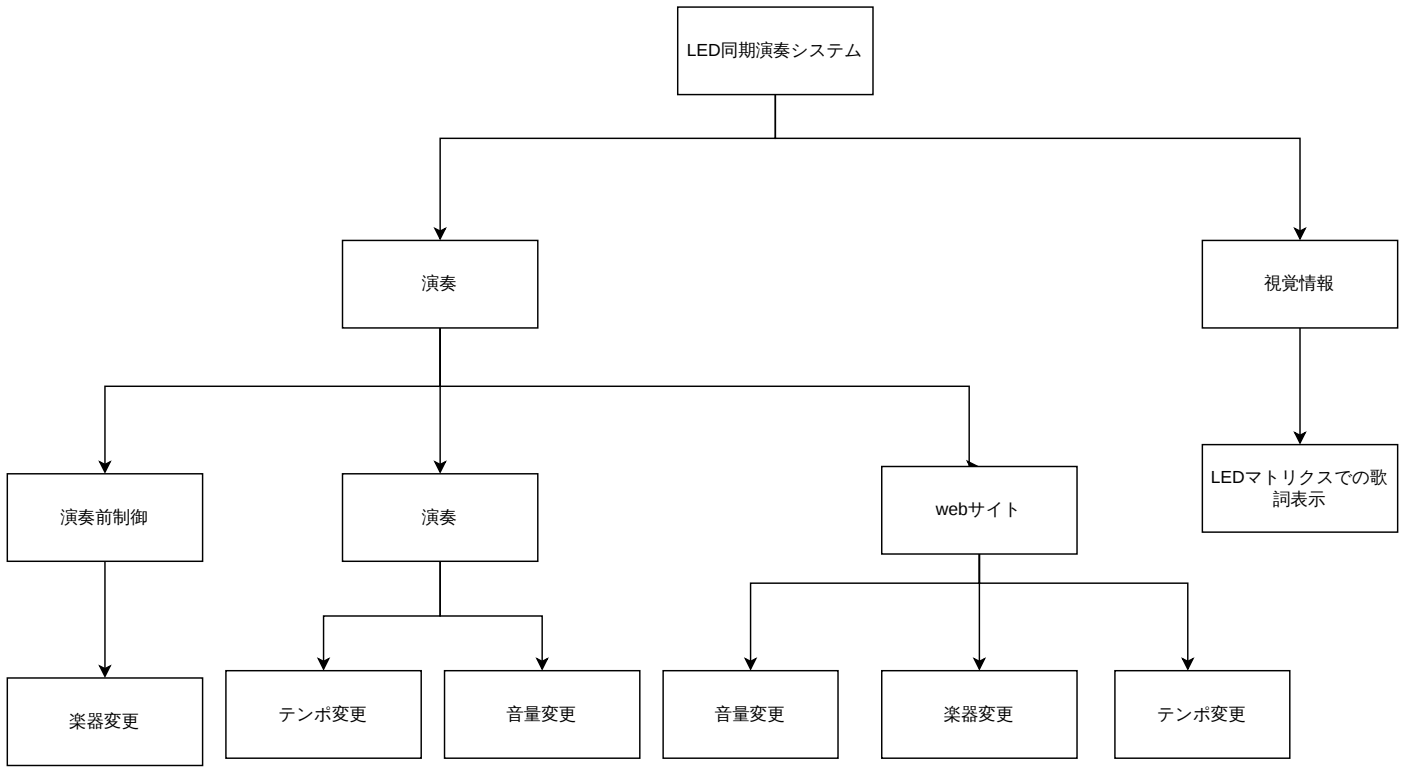
[picture p21: figure]
LED同期演奏システム; 視覚情報; LEDマトリクスでの歌 詞表示; 演奏前制御; webサイト; 楽器変更; テンポ変更; 音量変更
