crab2424/LEDplaying_system/チーム内部資料/7_3_23時計画書/img/gann6_10.pdf

こ
の LED の発光色による光同期システム | シンプル ガント チャート (Vertex42.com) (https://www.vertex42.com/ExcelTemplates/simple-gantt-chart.html)

セル B2 には会社の名前を入力します。 26班

https://www.vertex42.com/ExcelTemplates/simple-gantt-chart.html

セル B3 に、プロジェクト主任の名前を入力します。セル E3 には、プロジェクトの開始日を入力します。プロジェクトの開始: ラベルはセル C3 にあります。
セ
ル | 1
セ | 18 19 20 21 22 23 24 | 25 26 27 28 29 30 31 | 1 | 2 | 3 | 4 | 5 | 6 | 7 | 8 | 9 10 11 12 13 14 | 15 16 17 18 19 20 21 | 22 23 24 25 26 27 28 | 29 30 1 | 2 | 3 | 4 | 5
こ
の
タスク | 担当者 | 進捗状況 | 開始 | 終了 | 月 | 火 | 水 | 木 | 金 | 土 | 日 | 月 | 火 | 水 | 木 | 金 | 土 | 日 | 月 | 火 | 水 | 木 | 金 | 土 | 日 | 月 | 火 | 水 | 木 | 金 | 土 | 日 | 月 | 火 | 水 | 木 | 金 | 土 | 日 | 月 | 火 | 水 | 木 | 金 | 土 | 日 | 月 | 火 | 水 | 木 | 金 | 土 | 日

セ
ル | 基本設計

セ
ル | 楽器演奏 | 2年 | 5/20/26 | 5/23/26

行
1
Webサイト | 金枝 | 5/20/26 | 5/23/26
LEDマトリクスデザイン | ３年 | 5/20/26 | 5/23/26

右
の

詳細設計

LED点滅機能 | 佐藤 | 5/23/26 | 5/27/26
受光機能 | 飯塚 | 5/23/26 | 5/27/26
演奏開始、停止ボタン | 恩田 | 5/23/26 | 5/27/26
ArduinoとProcessing通信 | 飯塚 | 5/26/26 | 5/28/26
テンポ変更機能 | 佐藤 | 5/26/26 | 5/28/26
楽器変更機能 | 金枝 | 5/26/26 | 5/28/26
楽器音 | 2年 | 5/23/26 | 5/27/26
楽譜配列 | 恩田 | 5/26/26 | 5/28/26
LED マトリクス文字配列 | 3年 | 5/23/26 | 5/27/26

サンプル フェーズ タイトル ブロック 機材調達

部品選定 | 全員 | 5/20/26 | 5/24/26

サンプル フェーズ タイトル ブロック 実装

ピアノ音 | 飯塚→佐藤 | 5/25/26 | 6/12/26
フルート音 | 佐藤 | 5/25/26 | 6/12/26
バイオリン音 | 恩田 | 5/25/26 | 6/12/26
パーカッション音 | 荘司 | 5/25/26 | 6/12/26
光信号発信 | 佐藤 | 5/25/26 | 6/12/26
光信号受信 | 飯塚 | 5/25/26 | 6/12/26
演奏開始、停止ボタン | 恩田 | 5/25/26 | 6/12/26
テンポ変更機能 | 佐藤 | 5/25/26 | 6/12/26
楽器変更機能 | 金枝 | 5/25/26 | 6/12/26
Webサイト | 金枝 | 5/25/26 | 6/3/26
LEDマトリクス | 三芝 | 5/25/26 | 6/5/26
ArduinoとProcessing通信 | 飯塚 | 5/27/26 | 6/12/26

サンプル フェーズ タイトル ブロック テスト

楽器音テスト | 2年 | 6/13/26 | 6/19/26
遅延テスト | 佐藤 | 6/13/26 | 6/19/26
開始停止スイッチテスト | 恩田 | 6/13/26 | 6/19/26
テンポ変更スイッチテスト | 飯塚 | 6/13/26 | 6/19/26
楽器変更スイッチテスト | 佐藤 | 6/13/26 | 6/19/26
光通信同期テスト | 全員 | 6/20/26 | 6/25/26
接続テスト | 全員 | 6/20/26 | 6/25/26
遅延テスト | 全員 | 6/20/26 | 6/25/26
演奏が成り立っているかテスト | 全員 | 6/20/26 | 6/25/26

プロジェクトの開始:

週表示: | 2026/6/15

水, 2026/5/20

2026/5/18 | 2026/5/25 | 2026/6/1 | 2026/6/8 | 2026/6/22 | 2026/6/29
