crab2424/LEDplaying_system/チーム内部資料/7_3_23時計画書/img/LED点滅・受光回路(外部カラーLED付属版).pdf

1 | 2 | 3 | 4 | 5 | 6 1 | 2 | 3 | 4 | 5 | 6 ABCD | ABCD Date:

330Ω

### 3300Ω 1 2 3 可変抵抗

### 押しボタン

330Ω

330Ω | 330Ω | 330Ω | 330Ω D1/TX
Arduino Uno R4 Wifi Gin | Rin D3 | GND Bin | GND

### SCL SDA

### LED

INT D4 | A3 D5 | D2 Vin | A0A1A2

### 3V3 GND

### VIN

TCS34725 | D4 A5 | D1/TX D0/RX A4
Arduino Uno R4 Wifi | GND D13 D12 D11 5V | D6D5 | D3D2 Vin | A0 3.3V | D8 | D6 | RESET 3.3V D7 | D10D9D8D7
カラーLED | A1A2 GND GND | D0/RX SDA AREF SCL | GND D13 IOREF RESET D12 | 5V D9 D11 D10 | A5 AREF | A4 | Gin SCL | GND | GND Bin | Rin IOREF SDA

### カラーLED A3

330Ω

330Ω | 330Ω 330Ω
