crab2424/LEDplaying_system/doc_log/作業ログ_0707.tex

% 元の
% \documentclass[lualatex,book,paper=a4paper,jafontsize=11.5pt,jafontscale=1.05]{jlreq}
\documentclass[lualatex,paper=a4paper,jafontsize=11.5pt,jafontscale=1.05]{jlreq}
% 2ページ目や章の前に一ページ余分なものがあるのが気になる場合は openanyを\documentclass[...,book,openany ,..]として追加する

%フォント:
\usepackage{luatexja-fontspec}
\usepackage{hack-fonts}

%表紙用:
\usepackage{hack-cover}
\usepackage{enumitem}
% 画像
\usepackage{graphicx}
\usepackage{float}
\usepackage{array}
\usepackage{makecell}

% リンク
\usepackage[hidelinks]{hyperref}

% ソースコード
\usepackage{listings}
\lstset{
  frame=single,
  basicstyle=\small\ttfamily,
  tabsize=4,
  breaklines=true
}

% 色・ガントチャート
\usepackage{xcolor}
\usepackage{pgfgantt}

\begin{document}
\section*{作業ログ}
\noindent
報告者:恩田 隼士\\
報告日: \today \\
プロジェクト名: 単一のフルカラーLEDとArduinoを用いた光無線通信による楽器間同期演奏システム \\
\hrulefill

\section{進捗サマリー（概要）}
\begin{itemize}
 \item 全体進捗率: 95\%
 \item マイルストーン達成状況: 達成
 \item 主要成果:
 \begin{itemize}
    \item 遅延テストの完了\\
    光と音の発生時間差116.7\,ms：目標125\,ms以内を達成\\
    楽器間同期ズレ平均16.6\,ms：目標40\,ms以内を平均で達成\\
    Webサイト操作からLED反映までの遅延233.3\,msが目標100\,ms未達であるが，演奏成立自体には影響しないため開発報告書の考察で扱う
    \item 4台同時演奏テスト（光通信同期テスト）の完了（パケット到達率：全テンポで99\%以上，損失率1\%未満）
    \item 開発報告書の執筆（評価結果と考察・個人の技術的貢献・おわりに，の各章を執筆完了）
 \end{itemize}
 \item 重大課題（影響度）: なし
\end{itemize}

\noindent
※今週新たに「開発報告書執筆」を作業項目として追加した．前回追加した「遅延テスト」「4台同時演奏テスト」は完了した．

\section{作業ログ（詳細トラッキング）}
\begin{table}[H]
  \centering
  \caption{作業ログ}
   \scalebox{0.7}{
    \begin{tabular}{lcccccc} \hline
      作業項目 & 開始日 & 予定完了日 & 状態 & 進捗率 & 依存関係・ブロッカー & コメント \\ \hline
      楽器演奏 & 05/20 & 05/23 & 完了 & 100\% & なし & - \\
      演奏開始・停止ボタン（設計） & 05/23 & 05/27 & 完了 & 100\% & 部品入手 & - \\
      楽器音 & 05/23 & 05/27 & 完了 & 100\% & 楽器演奏 & - \\
      楽譜配列 & 05/26 & 05/28 & 完了 & 100\% & 楽器音 & - \\
      ヴァイオリン音 & 05/28 & 06/12 & 完了 & 100\% & 楽器音 & - \\
      演奏開始・停止ボタン（実装） & 05/28 & 06/09 & 完了 & 100\% & 設計 & - \\
      結合 & 06/17 & 07/07 & 完了 & 100\% & 単体実装 & \makecell[l]{4台演奏者Arduino＋指揮者1台での\\実機演奏動作を確認} \\
      開始停止スイッチテスト & 06/13 & 06/19 & 完了 & 100\% & 実装の完了 & - \\
      楽器音テスト & 06/13 & 06/19 & 完了 & 100\% & 実装の完了 & - \\
      輪唱演奏テスト & 06/17 & 06/25 & 完了 & 100\% & 結合の完了 & - \\
      演奏停止プログラム & 06/29 & 06/29 & 完了 & 100\% & 結合 & - \\
      遅延テスト & 06/30 & 07/07 & 完了 & 100\% & 結合の完了 & - \\
      4台同時演奏テスト & 06/30 & 07/07 & 完了 & 100\% & 結合の完了 & - \\
      開発報告書執筆 & 07/01 & 07/07 & 進行中 & 40\% & テストの完了 & - \\
      \hline
    \end{tabular}
  }
\end{table}

% ===== 計画前ガントチャート =====
\subsection{担当箇所のガントチャート（計画前）}
\noindent
\begin{figure}[H]
\centering
\resizebox{0.92\linewidth}{!}{%
\begin{ganttchart}[
  hgrid,
  vgrid=dotted,
  time slot format=isodate,
  time slot unit=day,
  x unit=0.52cm,
  y unit title=0.6cm,
  y unit chart=0.65cm,
  title label font=\tiny,
  bar label font=\small,
  bar label node/.append style={text width=4.8cm, align=right},
  bar height=0.55,
  bar top shift=0.23,
  bar/.append style={fill=violet!45, draw=violet!75},
]{2026-05-20}{2026-06-16}
  \gantttitlecalendar{month=shortname} \\
  \gantttitlecalendar{day} \\
  \ganttbar{楽器演奏}{2026-05-20}{2026-05-23} \\
  \ganttbar{演奏開始・停止ボタン}{2026-05-23}{2026-05-27} \\
  \ganttbar{楽器音}{2026-05-23}{2026-05-27} \\
  \ganttbar{楽譜配列}{2026-05-26}{2026-05-28} \\
  \ganttbar{ヴァイオリン音}{2026-05-28}{2026-05-31}
  \ganttbar[bar label node/.append style={opacity=0}]{}{2026-06-04}{2026-06-09} \\
  \ganttbar{開始停止スイッチテスト}{2026-06-10}{2026-06-16} \\
  \ganttbar{楽器音テスト}{2026-06-10}{2026-06-16}
\end{ganttchart}%
}
\caption{担当箇所ガントチャート（計画前）}
\end{figure}

% ===== 現在のガントチャート =====
% 凡例：■ 灰色 = 完了，■ 紫色 = 未完了 / 進行中
% タスクの状態に応じて fill=gray!60（完了）または fill=violet!50（未完了）を変更
\subsection{担当箇所のガントチャート（現在・進捗状況）}
\noindent
{\small \textcolor{gray!50}{\rule{1em}{0.8em}}\ 完了\quad
       \textcolor{violet!60}{\rule{1em}{0.8em}}\ 未完了／進行中}
\begin{figure}[H]
\centering
\resizebox{0.92\linewidth}{!}{%
\begin{ganttchart}[
  hgrid,
  vgrid=dotted,
  time slot format=isodate,
  time slot unit=day,
  x unit=0.52cm,
  y unit title=0.6cm,
  y unit chart=0.65cm,
  title label font=\tiny,
  bar label font=\small,
  bar label node/.append style={text width=4.8cm, align=right},
  bar height=0.55,
  bar top shift=0.23,
]{2026-05-20}{2026-07-07}
  \gantttitlecalendar{month=shortname} \\
  \gantttitlecalendar{day} \\
  % ---- 完了タスク (gray!60) ----
  \ganttbar[bar/.append style={fill=gray!60, draw=gray!80}]
    {楽器演奏}{2026-05-20}{2026-05-23} \\
  \ganttbar[bar/.append style={fill=gray!60, draw=gray!80}]
    {演奏開始・停止ボタン（設計）}{2026-05-23}{2026-05-27} \\
  \ganttbar[bar/.append style={fill=gray!60, draw=gray!80}]
    {楽器音}{2026-05-23}{2026-05-27} \\
  \ganttbar[bar/.append style={fill=gray!60, draw=gray!80}]
    {楽譜配列}{2026-05-26}{2026-05-28} \\
  % ---- ヴァイオリン音：完了 (gray!60) ----
  \ganttbar[bar/.append style={fill=gray!60, draw=gray!80}]
    {ヴァイオリン音}{2026-05-28}{2026-05-31}
  \ganttbar[bar/.append style={fill=gray!60, draw=gray!80},
    bar label node/.append style={opacity=0}]
    {}{2026-06-04}{2026-06-12} \\
  \ganttbar[bar/.append style={fill=gray!60, draw=gray!80}]
    {演奏開始・停止ボタン（実装）}{2026-05-28}{2026-05-31}
  \ganttbar[bar/.append style={fill=gray!60, draw=gray!80},
    bar label node/.append style={opacity=0}]
    {}{2026-06-04}{2026-06-09} \\
  \ganttbar[bar/.append style={fill=gray!60, draw=gray!80}]
    {開始停止スイッチテスト}{2026-06-13}{2026-06-19} \\
  \ganttbar[bar/.append style={fill=gray!60, draw=gray!80}]
    {楽器音テスト}{2026-06-13}{2026-06-19} \\
  % ---- 輪唱演奏（実機結合）：完了 ----
  \ganttbar[bar/.append style={fill=gray!60, draw=gray!80}]
    {輪唱演奏（実機結合）}{2026-06-17}{2026-07-07} \\
  % ---- 演奏停止プログラム：完了 ----
  \ganttbar[bar/.append style={fill=gray!60, draw=gray!80}]
    {演奏停止プログラム}{2026-06-29}{2026-06-29} \\
  % ---- 今週完了：遅延テスト ----
  \ganttbar[bar/.append style={fill=gray!60, draw=gray!80}]
    {遅延テスト}{2026-06-30}{2026-07-07} \\
  % ---- 今週完了：4台同時演奏テスト ----
  \ganttbar[bar/.append style={fill=gray!60, draw=gray!80}]
    {4台同時演奏テスト}{2026-06-30}{2026-07-07} \\
  % ---- 今週追加：開発報告書執筆 ----
  \ganttbar[bar/.append style={fill=violet!50, draw=violet!80}]
    {開発報告書執筆}{2026-07-01}{2026-07-07}
\end{ganttchart}%
}
\caption{担当箇所ガントチャート（現在：灰＝完了，紫＝未完了）}
\end{figure}

ガントチャートにおいて，06/01$\sim$06/03の期間は中間試験対策期間として空白にしている．
なお，計画前ガントチャートは計画当初の予定を保持するため，以降の計画変更は反映していない．現在の進捗状況との差分は，「現在・進捗状況」ガントチャートとの比較により確認できる．

% ===== 日ごとの作業時間・内容 =====
\subsection{日ごとの作業時間・内容}
\begin{table}[H]
  \centering
  \caption{日ごとの作業時間・内容}
  \scalebox{0.88}{
    \begin{tabular}{ccp{7.5cm}} \hline
      日付 & 作業時間 & 作業内容・備考 \\ \hline
      2026/07/01 & 4h & 結合テスト実施 \\
      2026/07/04 & 4h & 報告書執筆 \\
      2026/07/06 & 2h & テスト結果の数値測定 \\
      2026/07/07 & 6h & 報告書執筆・作業ログ作成 \\
        % ※必要に応じて行を追加
      \hline
    \end{tabular}
  }

\end{table}

% ===== 今週追加：ログの詳細（TPM・TRL） =====
\section{ログの詳細}

\subsection{遅延テスト}
指揮者LEDの点滅から演奏者Arduino受光・Processing発音までの伝送遅延をハイスピード撮影により計測した．
撮影動画からフレーム番号を読み取り，フレーム数とフレームレートから遅延時間を算出した．結果は以下の通りである．
\begin{itemize}
  \item 光と音の発生時間差：116.7\,ms（内訳：LED発光→色検知62.5\,ms，色検知→発音54.2\,ms）．目標値125\,ms以内を達成した．
  \item 楽器間の同期ズレ：平均16.6\,ms，最大80\,ms（演奏者2端末での同時発音テスト）．目標値40\,ms以内を平均では達成した．最大80\,msは外れ値であり，これを除いた最大値は40\,msであった．
  \item Webサイト操作からLED反映までの遅延：233.3\,ms．目標値100\,ms以内に対し未達となった．
\end{itemize}
未達となったWebサイト経由の遅延については，演奏自体の同期成立には影響しないことを確認済みであり，原因の考察は開発報告書にて行う．

\subsection{4台同時演奏テスト（光通信同期テスト）}
LED閾値設計の改善版（RGB割合ベースの色判定，および赤色LED光量の上方補正）を反映した上で，
演奏者Arduino4台と指揮者Arduino1台による同時演奏テストを実施した（07/01）．
光同期通信を複数のテンポ（BPM 30・60・120・180・240）で一定回数実施し，送受信ログの比較からパケット到達率を算出した結果，
いずれのテンポにおいても到達率99\%以上（損失率1\%未満）であることを確認した．
4声輪唱についても安定して成立することを確認し，結合作業および輪唱演奏テストを完了とした．

\subsection{開発報告書の執筆}
計画書・設計書（7/3版）を基に，開発報告書の執筆を進めた．
評価結果と考察（遅延テスト・音色評価の実測値と目標値の比較），個人の技術的貢献（開始停止制御・楽譜配列・結合統合作業），
おわりに，の各章の執筆を完了した．
アンケートによる聴取評価など結果待ちのデータの追記と，全体の推敲・提出要件との最終照合が残作業である．

\subsection{技術性能指標（TPM）}
TPMはシステムの最終的な性能に関わる技術を管理するための指標である．
本プロジェクトの各指標のうち，自分の担当は「音色の再現性」である．
音色の再現性については全4特徴量（AT，SC，DSV，OER）が目標値を達成済みである．
また今週は，結合後のシステムとしての性能指標である伝送遅延（116.7\,ms）・楽器間同期ズレ（平均16.6\,ms）・パケット到達率（99\%以上）の計測を完了した．

\subsection{技術成熟度（TRL）}
TRLは機能ごとの進捗を確認する指標である．定義を表\ref{tab:trl}に示す．

\begin{table}[H]
  \centering
  \caption{TRLの定義}
  \label{tab:trl}
  \scalebox{0.9}{
    \begin{tabular}{cp{10cm}} \hline
      TRL & 定義 \\ \hline
      1 & 概念レベル：アイディアや原理が確立されており，説明できるレベル \\
      2 & 基本動作レベル：単体で動作確認が可能なレベル \\
      3 & 結合動作レベル：機能を結合し，実際の使用環境に近い環境で動作確認が可能なレベル \\
      4 & 実運用レベル：実際の使用環境で安定的な稼働が確認できるレベル \\
      \hline
    \end{tabular}
  }
\end{table}

自分の担当機能の現状を表\ref{tab:trl_status}に示す．
LED閾値設計の改善（RGB割合ベース判定・赤色LED光量の上方補正）反映後の4台＋指揮者の実機構成において，
パケット到達率99\%以上での安定した輪唱演奏が確認できたため，
同期演奏システムの結合および輪唱演奏はいずれもTRL4に到達したと判定した．
演奏停止プログラムは結合構成での動作確認（指揮者切断時の待機復帰・再演奏）が完了しており，TRL3と判定した．

\begin{table}[H]
  \centering
  \caption{担当機能のTRL現状}
  \label{tab:trl_status}
  \scalebox{0.9}{
    \begin{tabular}{lcp{6cm}} \hline
      担当機能 & 現在のTRL & 根拠 \\ \hline
      同期演奏システムの結合 & TRL4 & 4台＋指揮者での安定演奏を確認（パケット到達率99\%以上） \\
      輪唱演奏 & TRL4 & 4台での4声輪唱が安定して成立することを確認 \\
      演奏停止プログラム & TRL3 & 結合構成での動作確認まで完了 \\
      \hline
    \end{tabular}
  }
\end{table}

\section{課題管理}\label{sec:issues}

\subsection{設計書要件との適合確認}
\begin{itemize}
  \item 原因: 結合・輪唱実装の過程で，設計書との整合確認が一部未完了であった．
  \item 影響度: 中
  \item 優先度: 中
  \item 対応策: チーム内で実装仕様と設計書記載を突き合わせ，追記・修正箇所を確定した．色判定ラッチ動作等の追記が7/3版設計書へ反映されたことを確認した．
  \item 期限: 2026/06/30
  \item 状態: 完了（設計書への反映済み）
\end{itemize}

\subsection{LED色判定閾値の環境依存}
\begin{itemize}
  \item 原因: TCS34725による色判定の閾値が，USB電源の変動および周囲光環境により一定に定まらず，4台同時起動時に検出が不安定となる．
  \item 影響度: 中
  \item 優先度: 高
  \item 対応策: 別担当により，色判定をRGB割合ベースの方式へ見直すとともに，閾値割れしやすかった赤色LEDの光量を上方補正することで対処した．改善版を反映した4台同時演奏テストにて安定動作を確認した．
  \item 期限: 2026/07/07
  \item 状態: 完了
\end{itemize}

\section{AI利用状況と検証}
\subsection{利用内容}
\subsubsection{遅延テスト結果の数値整理}
\begin{itemize}
    \item 利用目的：ハイスピード撮影動画から手動計測したフレーム番号のメモをもとに，各遅延時間（ms）への換算，平均値・最大値の算出，および目標値（MOP）との比較整理を行うこと
    \item 入力（プロンプト要旨）：
    \begin{itemize}
        \item 撮影動画ごとのフレーム番号計測メモと，各動画のフレームレートを与えた．
        \item フレーム数差とフレームレートから遅延時間（ms）へ換算し，光と音の発生時間差・楽器間同期ズレ・Webサイト反映遅延の3項目について平均値・最大値を算出するよう依頼した．
        \item 計画書のMOP目標値（125\,ms／40\,ms／100\,ms）との達成・未達の判定を合わせて整理するよう指定した．
    \end{itemize}
    \item 出力概要：
    \begin{itemize}
        \item 光と音の発生時間差116.7\,msとして目標達成の判定が得られた．
        \item 楽器間同期ズレは平均16.6\,ms・最大80\,msと算出され，80\,msは他の計測値（除外後最大40\,ms）から乖離した外れ値である可能性の指摘が得られた．
        \item Webサイト反映遅延は233.3\,msと算出され，目標100\,msに対して未達である判定が得られた．
    \end{itemize}
\end{itemize}

\subsection{検証方法}
% ※第三者が再現できるレベルで記述
\begin{itemize}
  \item 検証手法:
  \begin{itemize}
      \item 換算式（遅延時間\,[ms] $=$ フレーム数差 $\div$ フレームレート $\times$ 1000）に基づく表計算ソフトでの再計算による．
  \end{itemize}
  \item 参照資料:
  \begin{itemize}
      \item 本プロジェクト計画書・設計書（MOP目標値の定義）\footnote{チーム内部資料．}．
      \item 撮影動画ファイルのメタデータ（フレームレート設定値）．
  \end{itemize}
  \item 検証手順：
  \begin{enumerate}
      \item 各撮影動画のフレームレートをメタデータで確認し，計測メモに記載した値と一致することを確かめる．
      \item AIが算出した各遅延時間について，フレーム番号差とフレームレートから表計算ソフトで再計算し，値が一致することを確認する．
      \item 平均値・最大値および目標値との達成判定を，計画書のMOP表と突き合わせて確認する．
  \end{enumerate}
\end{itemize}

\subsection{ファクトチェック}
\begin{itemize}
  \item 一致点：
  \begin{itemize}
    \item 全項目の換算結果は表計算ソフトでの再計算と一致した．
    \item 目標値（125\,ms／40\,ms／100\,ms）は計画書のMOP表の記載と一致しており，達成・未達の判定も正しい．
    \item 同期ズレ80\,msを外れ値と見る指摘は，他の計測値の分布（除外後最大40\,ms）と整合する．
  \end{itemize}
  \item 不一致・疑義：なし
  \item 最終判断：採用
  \item 根拠：
  \begin{itemize}
    \item 換算式・換算係数を含む全数値を表計算ソフトで再現できたため，整理結果を開発報告書（評価結果と考察）へ採用した．
    \item 外れ値80\,msについては除外せず「最大値」として併記した上で，発生要因の考察を開発報告書側で行う方針とした．
  \end{itemize}
\end{itemize}

\section{次回計画（次回までに実施する内容）}
\begin{itemize}
  \item 目標：
  \begin{itemize}
    \item 開発報告書の完成：アンケートによる聴取評価等の結果待ちデータを追記し，全体の推敲および提出要件との最終照合を行った上で提出する．
    \item プレゼン実施：被験者アンケートの結果を整理し，プレゼン資料を完成させて発表練習を行う．
  \end{itemize}
  \item 達成基準：
  \begin{itemize}
    \item 開発報告書が提出要件（ルーブリック・チェックリスト）を満たした状態で提出完了していること．
    \item プレゼン資料・アンケート結果の整備が完了し，発表を実施できること．
  \end{itemize}
  \item 期限：2026/07/14
\end{itemize}

\section{その他}
連絡事項・懸念点：なし

\section{付録}
添付資料を以下のリポジトリURLに示す．添付範囲は全体である．\\
\url{https://github.com/crab2424/LEDplaying_system}

% 今回の報告内容では外部Web資料の引用がないため参考文献リストは省略
% （参照資料はチーム内部資料のため脚注で対応）

\end{document}
