crab2424/LEDplaying_system/チーム内部資料/7_3_23時計画書/img/serial_bit.pdf

# uint32_t data

| i 2 | d | d2 | d3 | d4 | d5 | d6 | d7 | d8 | d9 | d10 | d11 d12 i 1 | v1 | v2 | v3 | v4 | v5 | v6 | v7 | p1 | p2 | p3 | p4 1 | p5 | p6
2bit 余り | | 音の長さ 12bit | | | | | | | | | | | 音量 7bit | | | | | | | 音高 6bit 楽器ID
v4 | v5 | v6 | v7 | p1 | p2 | p3 | p4 d | v1 | v2 | v3 i 2 | d1 | d2 | d3 | d4 | d5 | d6 | 8 | d9 | d10 | d11 | d12 i 1 | d7

# 送信データ uint8_t buf[4]

buf[0] | buf[1] | buf[2] | buf[3]
p5 | p6
