crab2424/LEDplaying_system/チーム内部資料/7_3_23時計画書/img/ハッカソンRGB割合計測図.pdf

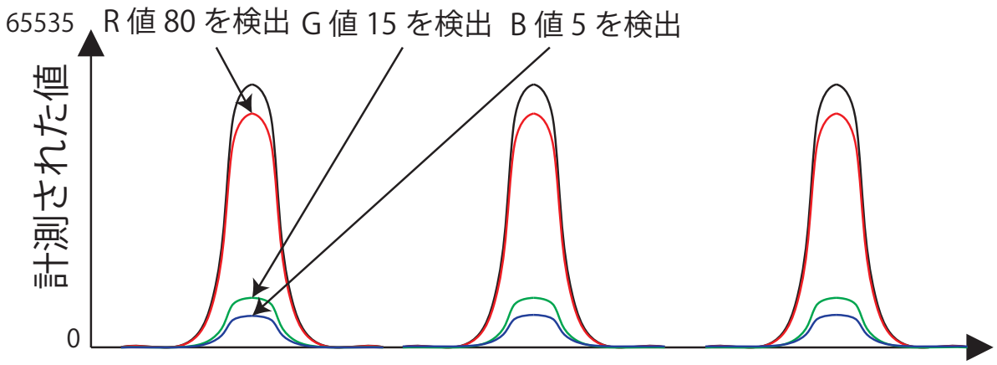
[picture p24: figure]
R 値 80 を検出; B 値 5 を検出; 計測された値; G 値 15 を検出

### 経過時間 [ms]

光量 clear 値の線
赤色の強さ R 値の線
緑色の強さ G 値の線
青色の強さ B 値の線

## 赤色であることを検出する場合

測定する色
赤
緑
青
紫
