crab2424/LEDplaying_system/チーム内部資料/7_3_23時計画書/img/ハッカソンRGB割合計算図.pdf

R 値
R 値 +G 値 +B 値

R 値の割合 =

G 値
R 値 +G 値 +B 値

G 値の割合 =
B 値
R 値 +G 値 +B 値

B 値の割合 =

## 割合導出と閾値チェック

R 値の割合≧50

G 値の割合≦20

B 値の割合≦20

割合閾値を満たしたため
赤色と判定

予め色判定の割合を決定
