crab2424/LEDplaying_system/チーム内部資料/7_3_23時計画書/img/受光.pdf

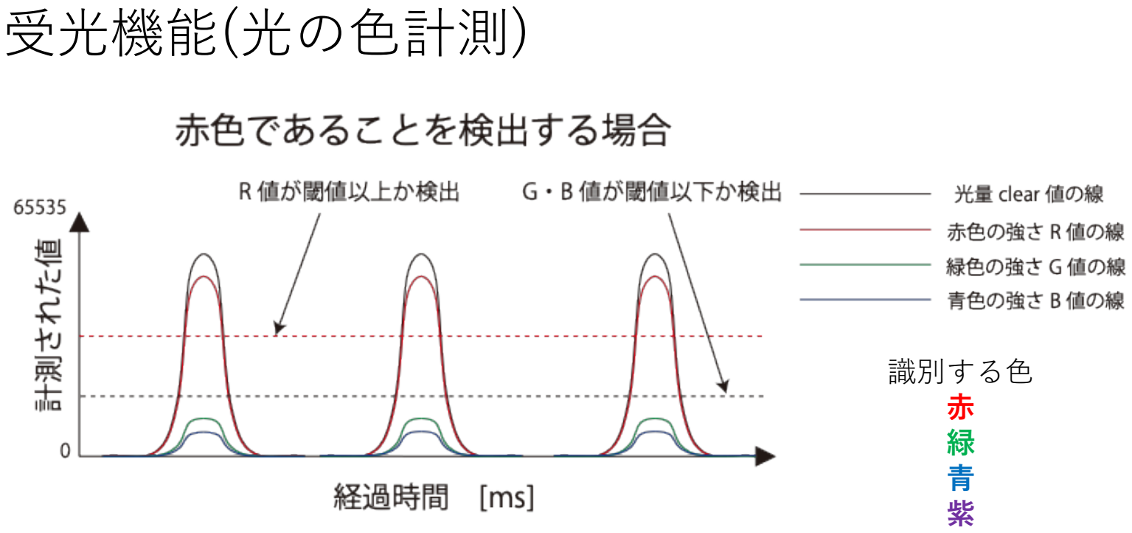
[picture p25: page 1]

受光機能(光の色計測)

識別する色
赤
緑
青
紫
