crab2424/LEDplaying_system/チーム内部資料/7_3_23時計画書/img/最大値.pdf

受光機能(光量最大値の計測)

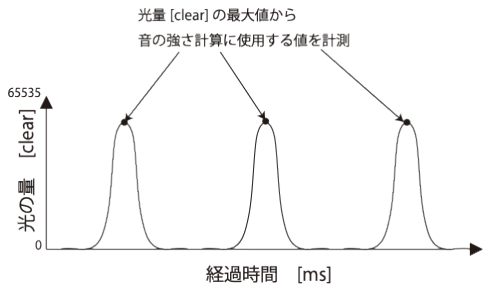
[picture p26: figure]
