crab2424/LEDplaying_system/チーム内部資料/7_3_23時計画書/img/点滅間隔.pdf

受光機能(点滅間隔の計測)

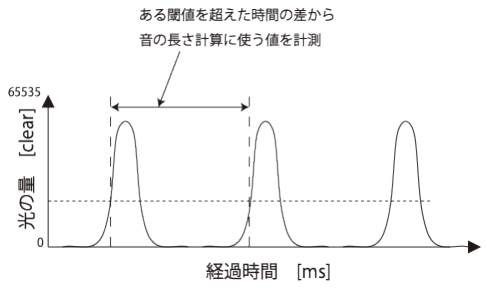
[picture p27: figure]
