crab2424/LEDplaying_system/チーム内部資料/7_3_23時計画書/img/FBS.png

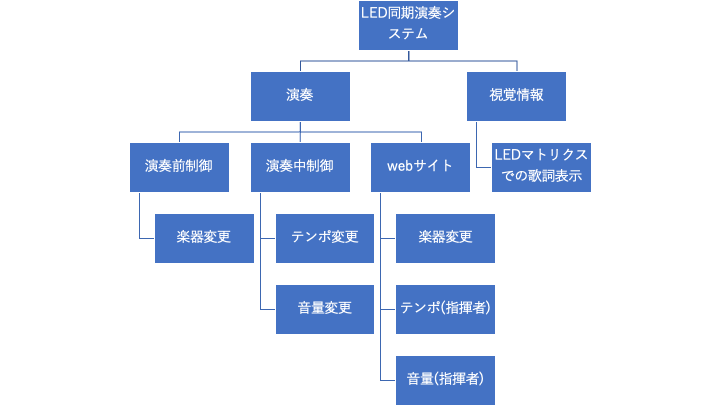
チーム内部資料/7_3_23時計画書/img/FBS.png
