crab2424/LEDplaying_system/チーム内部資料/7_3_23時計画書/img/fbs_7_1.pdf

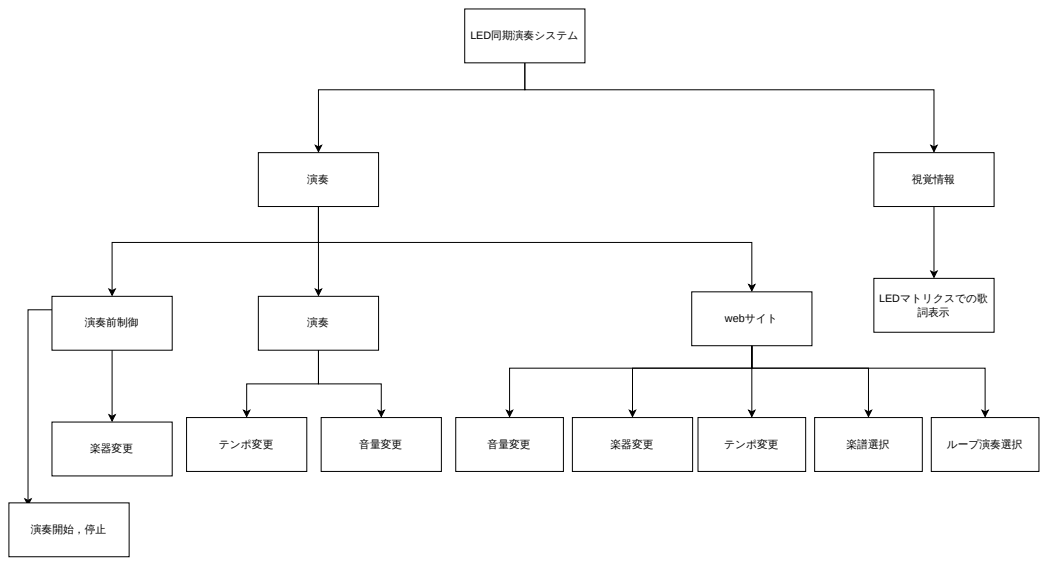
[picture p40: page 1]
LED同期演奏システム; 視覚情報; LEDマトリクスでの歌 詞表示; 演奏前制御; webサイト; 楽器変更; テンポ変更; 音量変更; 楽譜選択; ループ演奏選択; 演奏開始，停止
