crab2424/LEDplaying_system/チーム内部資料/7_3_23時計画書/img/LED点滅・受光回路(外部LEDピン対応修正).pdf

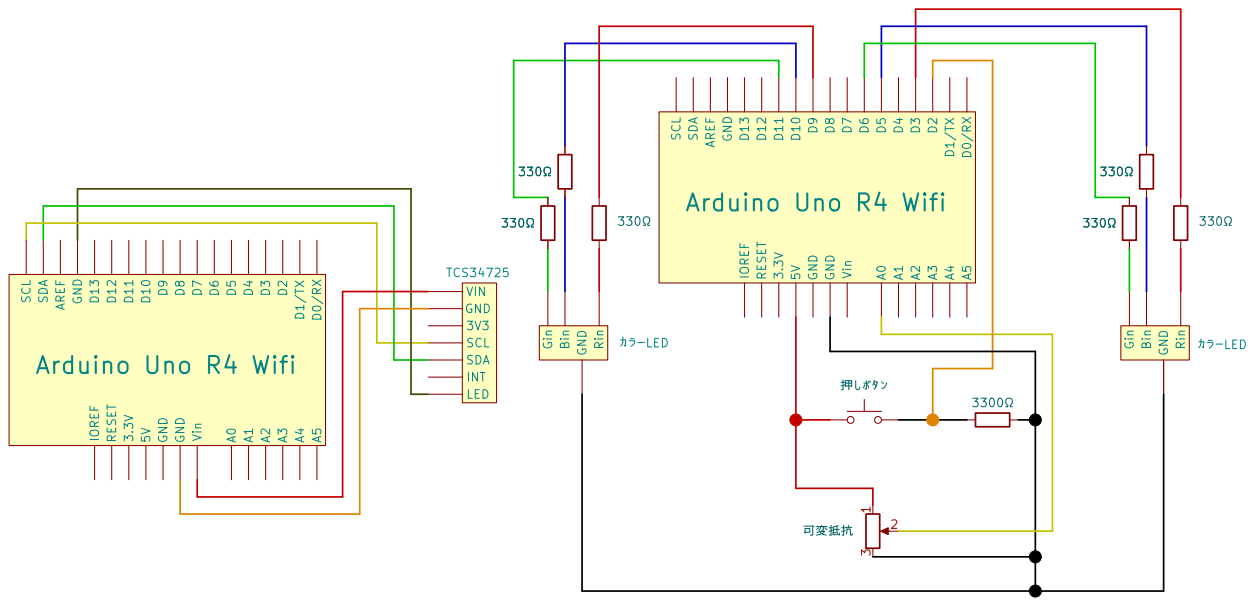
[picture p41: page 1]

Arduino Uno R4 Wifi RESET

Size: A4 | Rev:
KiCad E.D.A. 10.0.3 | Id: 1/1
