crab2424/LEDplaying_system/チーム内部資料/7_3_23時計画書/img/LED点滅・受光回路(外部LEDピン対応修正)訂正版.pdf

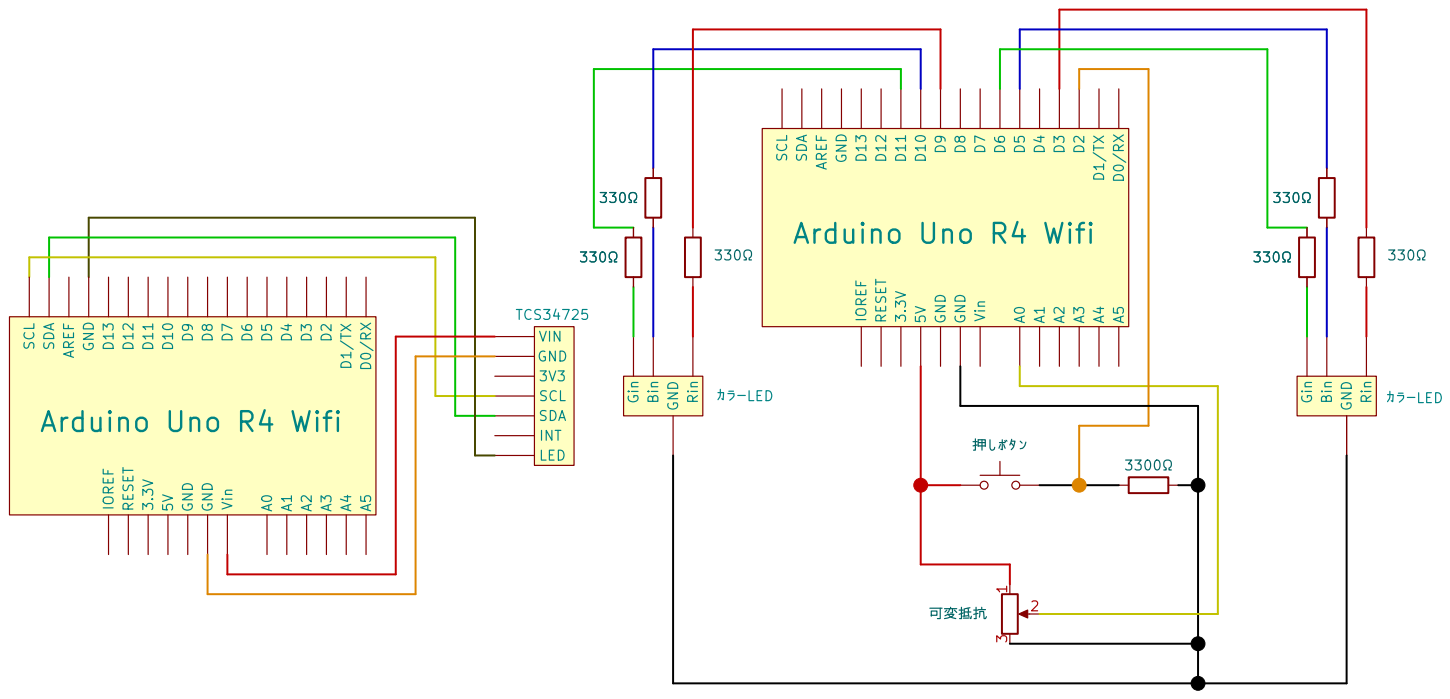
[picture p42: page 1]

Arduino Uno R4 Wifi RESET
