crab2424/LEDplaying_system/チーム内部資料/7_3_23時計画書/img/pbs_6_26.pdf

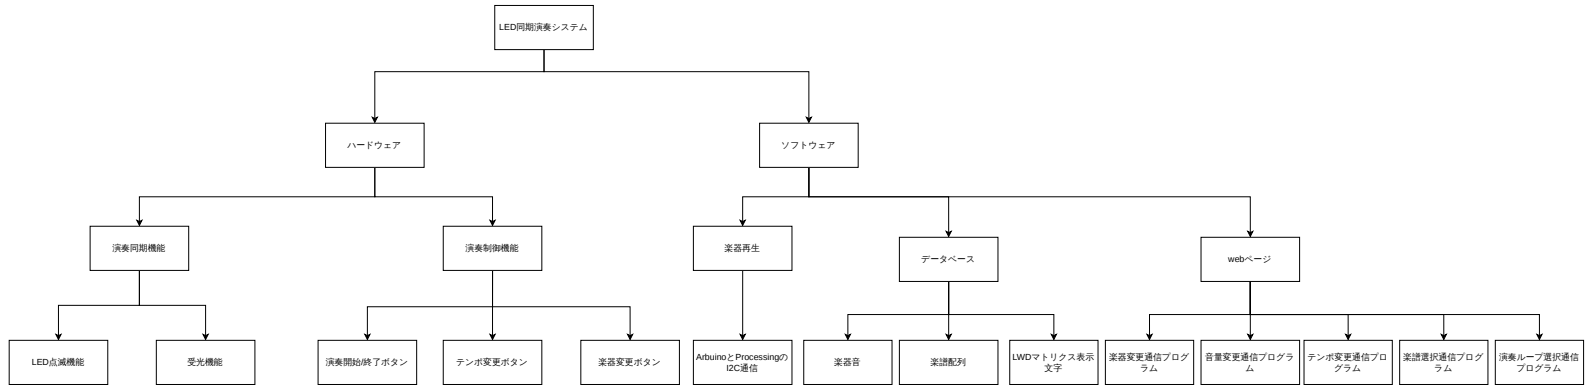
[picture p44: page 1]
LED同期演奏システム; ハードウェア; ソフトウェア; 演奏同期機能; 演奏制御機能; 楽器再生; LED点滅機能; 受光機能; 演奏開始/終了ボタン; テンポ変更ボタン; 楽器変更ボタン; ArbuinoとProcessingの; I2C通信; データベース; 楽譜配列; LWDマトリクス表示; 文字 楽器音; webページ; 音量変更通信プログラ ム; テンポ変更通信プロ グラム; 楽器変更通信プログ ラム; 楽譜選択通信プログ ラム; 演奏ループ選択通信 プログラム
