crab2424/LEDplaying_system/チーム内部資料/7_3_23時計画書/img/playerFlowchar_7_3.pdf

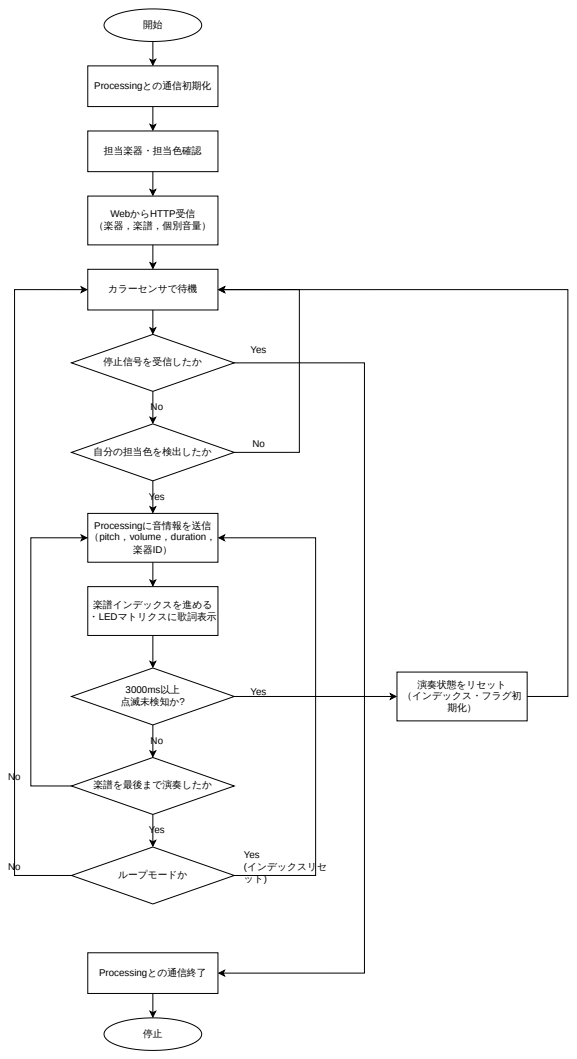
[picture p45: page 1]
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

WebからHTTP受信
（楽器，楽譜，個別音量）

Yes

Processingに音情報を送信
（pitch，volume，duration，
