crab2424/LEDplaying_system/チーム内部資料/7_3_23時計画書/img/シーケンス.pdf

# 指揮者Arduino 初期化LED点灯制御ループ

# Processing 音再生ループ

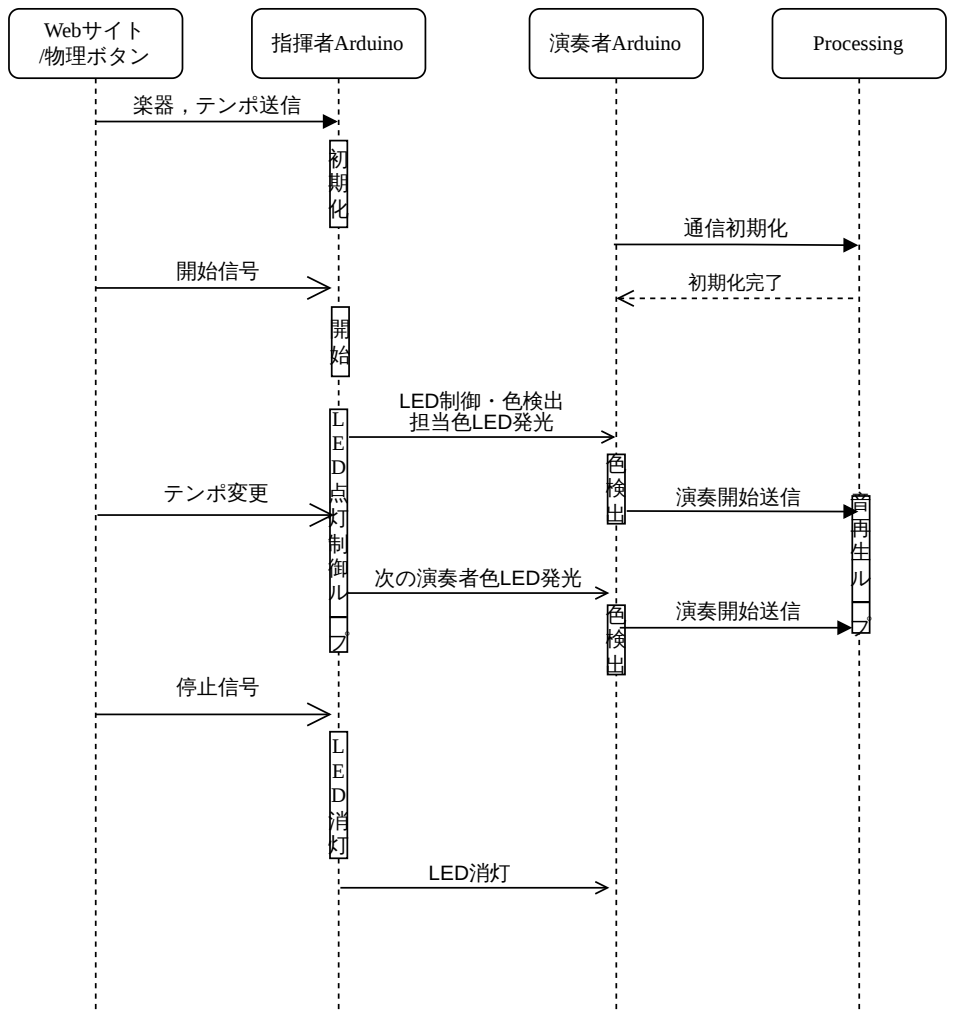
[picture p46: page 1]
テンポ変更; LED消灯; 演奏者Arduino; LED制御・色検出; 色検出; 次の演奏者色LED発光; 初期化完了; Webサイト /物理ボタン; 通信初期化; 楽器，テンポ送信; 開始信号; 担当色LED発光; 演奏開始送信; 停止信号
