crab2424/LEDplaying_system/チーム内部資料/7_3_23時計画書/img/シーケンス_6_26.pdf

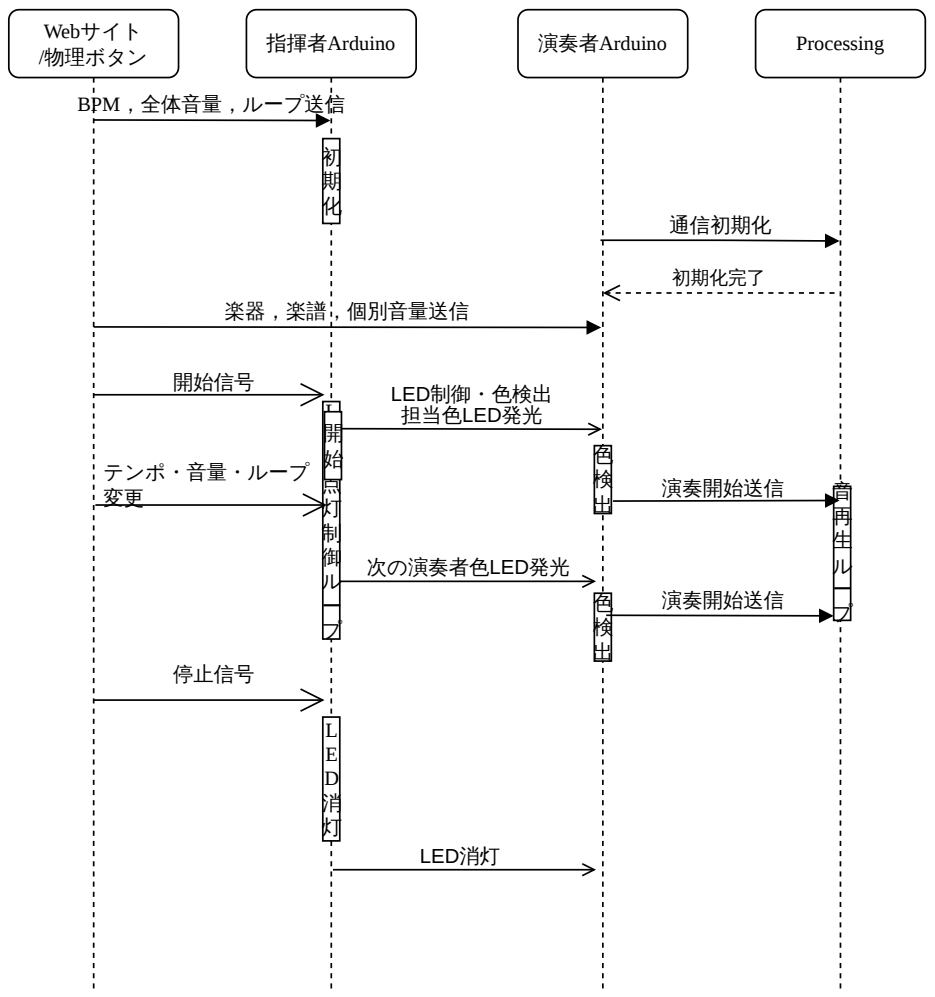
[picture p47: page 1]
指揮者Arduino; 演奏者Arduino; LED制御・色検出; 次の演奏者色LED発光; Processing; 初期化完了; 通信初期化; 開始信号; 担当色LED発光; 演奏開始送信; 停止信号; LED消灯

Webサイト
/物理ボタン
BPM，全体音量，ループ送信

楽器，楽譜，個別音量送信

テンポ・音量・ループ
