crab2424/LEDplaying_system/チーム内部資料/7_3_23時計画書/img/指揮者フロー_6_26.pdf

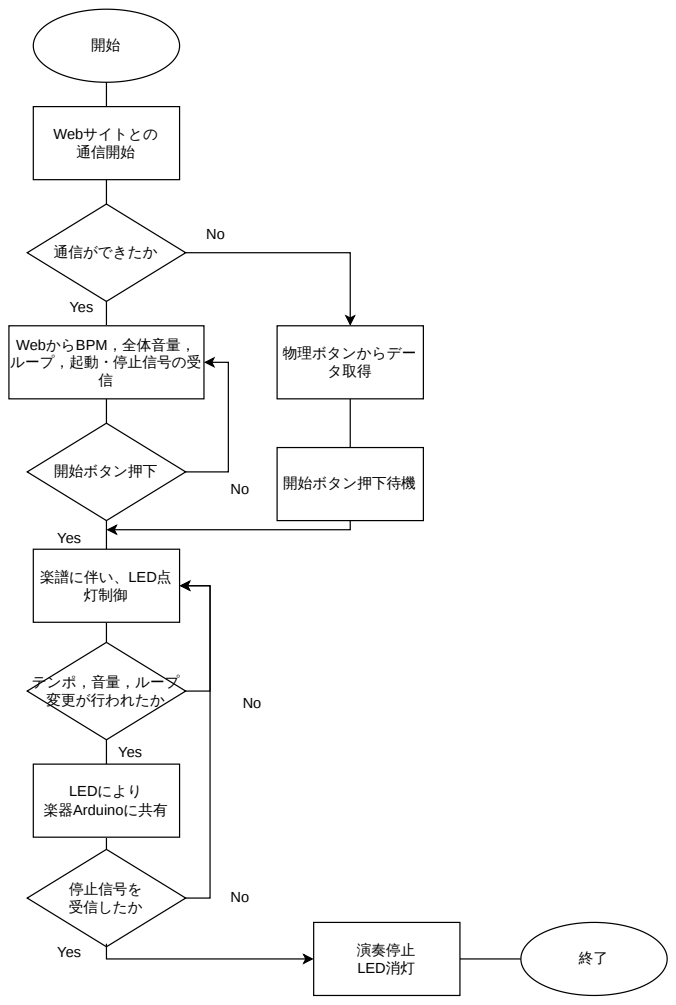
[picture p48: page 1]
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

WebからBPM，全体音量，
ループ，起動・停止信号の受

テンポ，音量，ループ
変更が行われたか
