crab2424/LEDplaying_system/チーム内部資料/7_3_23時計画書/img/指揮者側.pdf

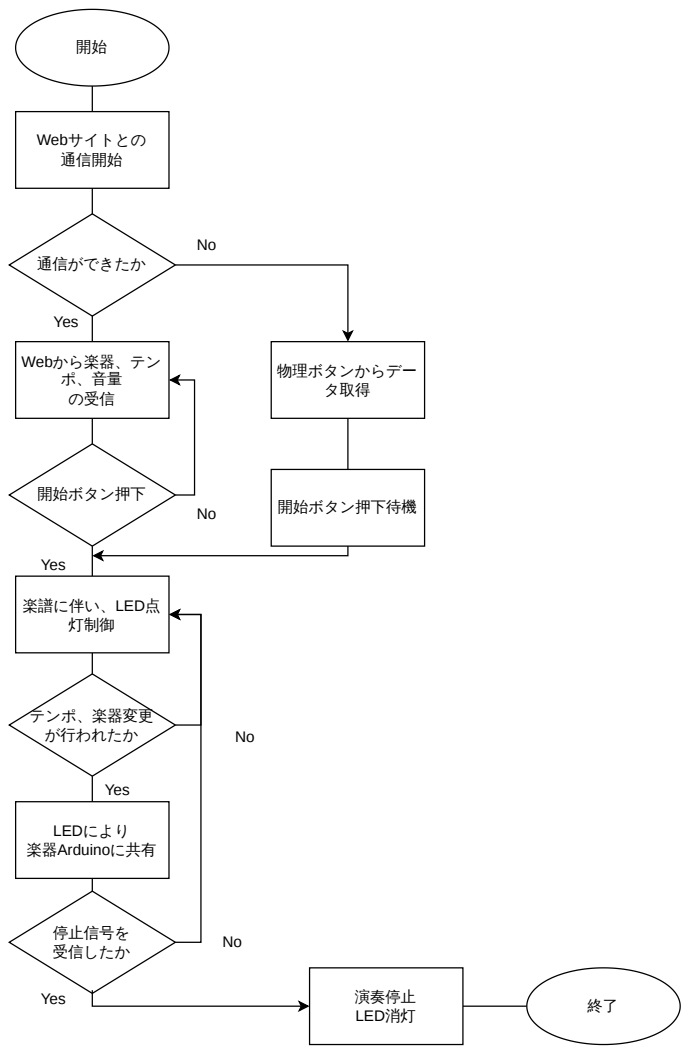
[picture p49: page 1]
Webサイトとの 通信開始; Webから楽器、テン ポ、音量 の受信; 楽譜に伴い、LED点 灯制御; 停止信号を 受信したか; 演奏停止; LED消灯; 開始ボタン押下; テンポ、楽器変更 が行われたか; Yes; 通信ができたか; 物理ボタンからデー タ取得; 開始ボタン押下待機; LEDにより 楽器Arduinoに共有
