crab2424/LEDplaying_system/チーム内部資料/7_3_23時計画書/img/構成図.pdf

### Arduino

# 演奏者

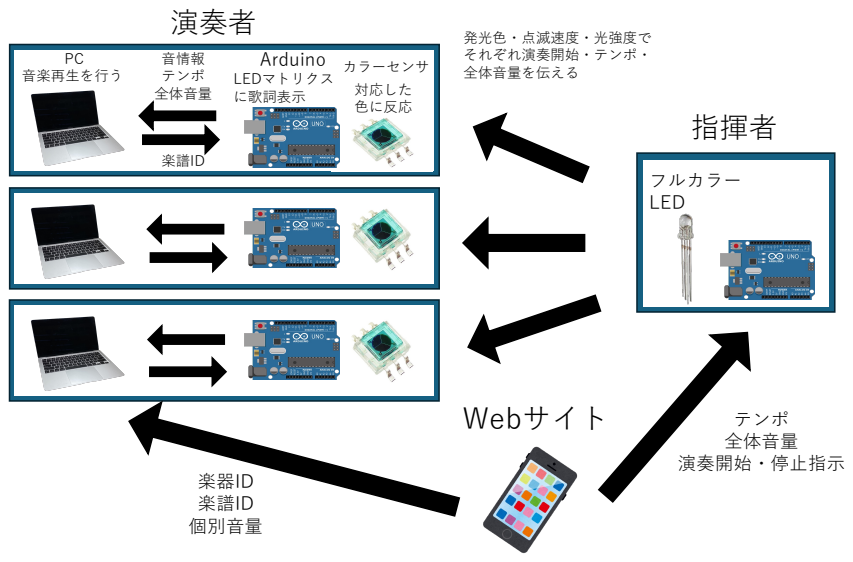
[picture p50: page 1]
LEDマトリクス に歌詞表⽰; カラーセンサ ⾳情報 テンポ 全体⾳量; フルカラー LED; 指揮者; 対応した ⾊に反応; Webサイト; テンポ; 全体⾳量 演奏開始・停⽌指⽰; 楽器ID 楽譜ID 個別⾳量; 楽譜ID

発光⾊・点滅速度・光強度で
それぞれ演奏開始・テンポ・
全体⾳量を伝える
