crab2424/LEDplaying_system/チーム内部資料/7_3_23時計画書/img/LED点滅・受光回路.pdf

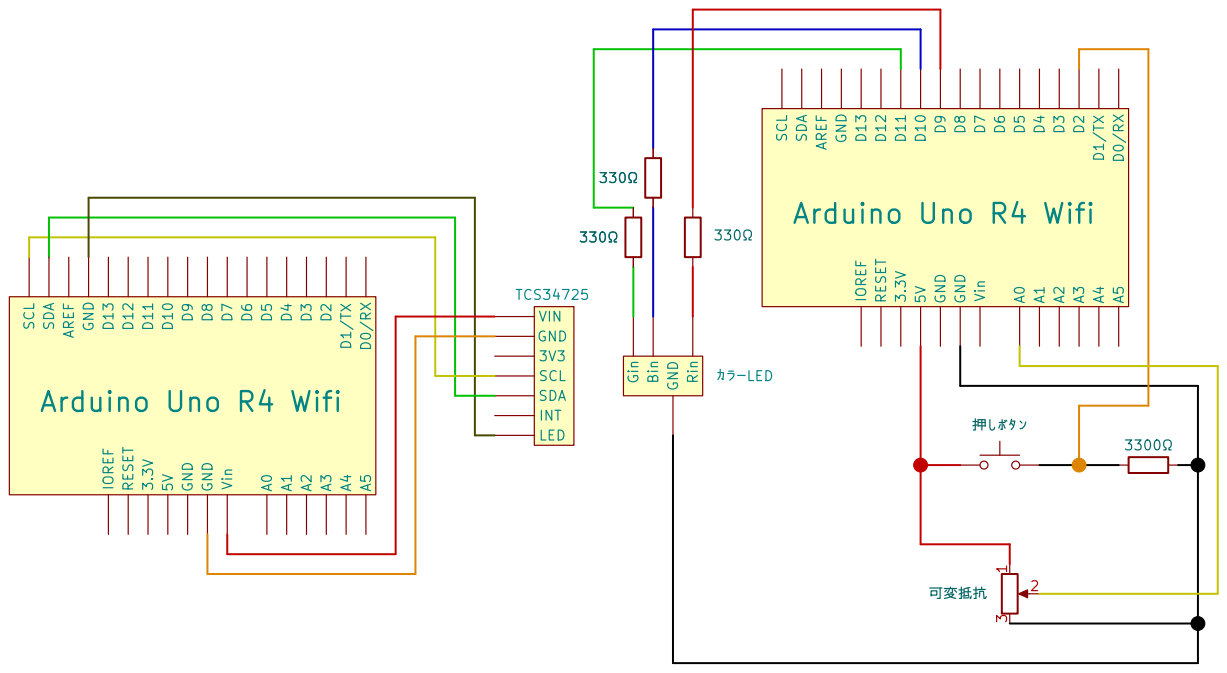
[picture p51: page 1]
