crab2424/LEDplaying_system/チーム内部資料/7_3_23時計画書/img/playerFlowchar_6_26.pdf

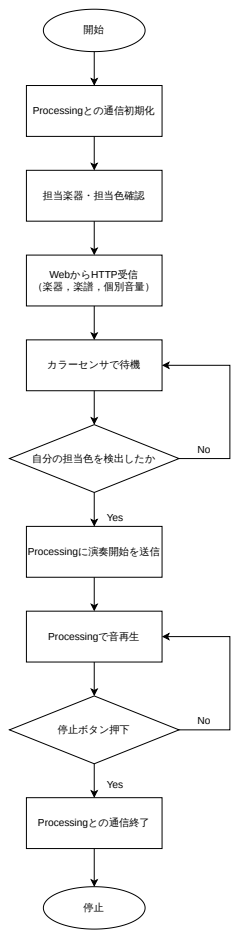
[picture p52: page 1]
Processingとの通信初期化; 担当楽器・担当色確認; カラーセンサで待機; 自分の担当色を検出したか; Processingに演奏開始を送信; Processingで音再生; 停止ボタン押下; Processingとの通信終了; Yes

WebからHTTP受信
（楽器，楽譜，個別音量）
