crab2424/LEDplaying_system/チーム内部資料/7_3_23時計画書/img/Web.pdf

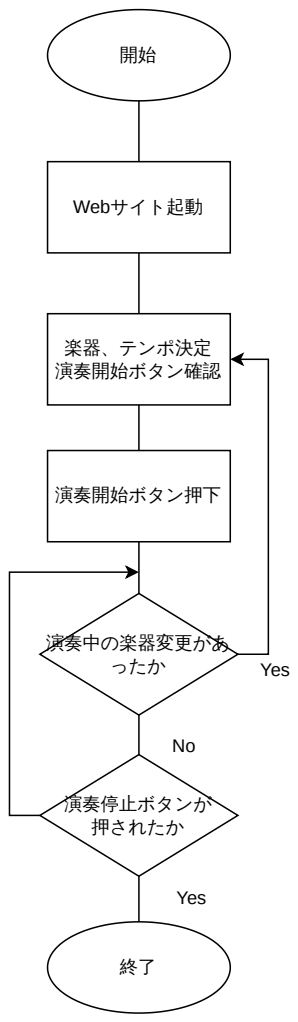
[picture p53: page 1]
楽器、テンポ決定 演奏開始ボタン確認; 演奏開始ボタン押下; 演奏中の楽器変更があ ったか; Webサイト起動; Yes; 演奏停止ボタンが 押されたか
