crab2424/LEDplaying_system/チーム内部資料/7_3_23時計画書/img/Webフロー_6_26.pdf

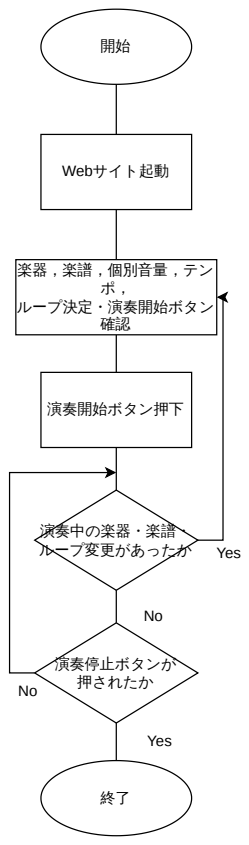
[picture p54: page 1]
ポ， ループ決定・演奏開始ボタン 確認; 演奏開始ボタン押下; 演奏中の楽器・楽譜・ ループ変更があったか; Webサイト起動; Yes; 演奏停止ボタンが 押されたか No

楽器，楽譜，個別音量，テン
