crab2424/LEDplaying_system/チーム内部資料/7_3_23時計画書/img/アローダイアグラム.pdf

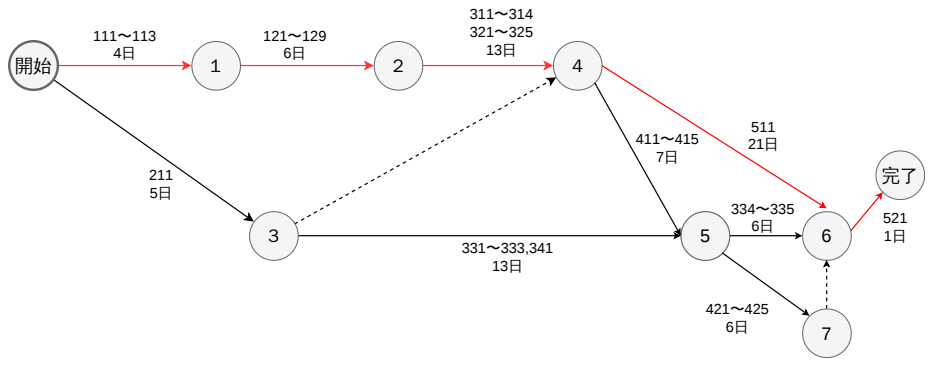
[picture p55: page 1]
