crab2424/LEDplaying_system/チーム内部資料/7_3_23時計画書/img/演奏者側.pdf

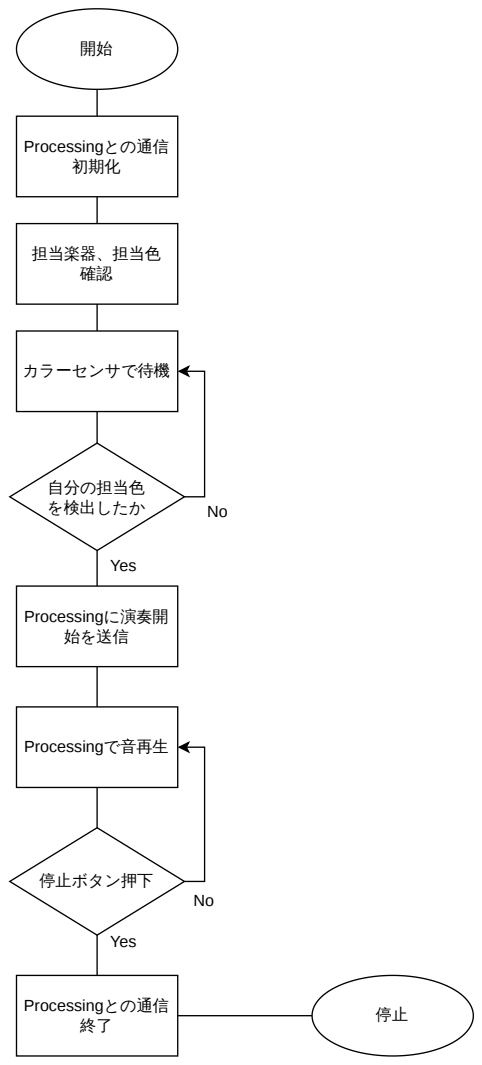
[picture p56: page 1]
Processingとの通信 初期化; 担当楽器、担当色 確認; カラーセンサで待機; 自分の担当色 を検出したか; Processingに演奏開 始を送信; Processingで音再生; 停止ボタン押下; Processingとの通信; Yes
