crab2424/LEDplaying_system/演奏/player/lyrics.h

#ifndef LYRICS_H
#define LYRICS_H
#define MELODY_LENGTH 64

#include <stdint.h>
#include "katakana.h"

// ============================================================
// LEDマトリクス用 歌詞配列（カエルの歌：36文字）
// ============================================================
#define LYRICS_LENGTH 36
extern const uint32_t *kaeruNoUta[LYRICS_LENGTH];

// ============================================================
// 楽譜配列（melody.pde より移植）
// ============================================================
// 音高インデックス＝ C3 からの半音数（クロマチック方式・オクターブ拡張）
//   C3=0, C4=12, C5=24
//   例) G3=7, Ab3=8, A3=9, Bb3=10, D4=14, E4=16, F4=17, G4=19, A4=21
// → 低音域（伴奏）や半音（♭/♯）も表現できるよう拡張した．

// ============================================================
// メロディー楽譜（カエルの歌）
// ============================================================
// 各音の高さ（音名 → ピッチインデックス: C3 からの半音数）
static const uint8_t melodyScore_pitch[MELODY_LENGTH] = {
  24, 0, 26, 2, 28, 2, 29, 0, 28, 0, 26, 0, 24, 0, 0, 0, // C5 D5 E5 F5 E5 D5 C5
  28, 0, 29, 0, 31, 0, 33, 0, 31, 0, 29, 0, 28, 0, 0, 0, // E5 F5 G5 A5 G5 F5 E5
  24, 0,  0, 0, 24, 0,  0, 0, 24, 0,  0, 0, 24, 0,  0, 0, // C5 C5 C5 C5
  24, 24, 26, 26, 28, 28, 29, 29, 28, 0, 26,  0, 24,  0,  0,  0, // C5 C5 D5 D5 E5 E5 F5 F5 E5 D5 C5
};

// 各音の長さ（拍）
static const float melodyScore_duration[MELODY_LENGTH] = {
  2.0f, 0.0f, 2.0f, 0.0f, 2.0f, 0.0f, 2.0f, 0.0f, 2.0f, 0.0f, 2.0f, 0.0f, 2.0f, 0.0f, 0.0f, 0.0f,
  2.0f, 0.0f, 2.0f, 0.0f, 2.0f, 0.0f, 2.0f, 0.0f, 2.0f, 0.0f, 2.0f, 0.0f, 2.0f, 0.0f, 0.0f, 0.0f,
  2.0f, 0.0f, 0.0f, 0.0f, 2.0f, 0.0f, 0.0f, 0.0f, 2.0f, 0.0f, 0.0f, 0.0f, 2.0f, 0.0f, 0.0f, 0.0f,
  1.0f, 1.0f, 1.0f, 1.0f, 1.0f, 1.0f, 1.0f, 1.0f, 1.0f, 0.0f, 1.0f, 0.0f, 1.0f, 0.0f, 0.0f, 0.0f,
};

// 各音の強弱（音量倍率: 0.0〜1.0）
static const float melodyScore_amplitude[MELODY_LENGTH] = {
  1.0f, 0.0f, 1.0f, 0.0f, 1.0f, 0.0f, 1.0f, 0.0f, 1.0f, 0.0f, 1.0f, 0.0f, 1.0f, 0.0f, 0.0f, 0.0f,
  1.0f, 0.0f, 1.0f, 0.0f, 1.0f, 0.0f, 1.0f, 0.0f, 1.0f, 0.0f, 1.0f, 0.0f, 1.0f, 0.0f, 0.0f, 0.0f,
  1.0f, 0.0f, 0.0f, 0.0f, 1.0f, 0.0f, 0.0f, 0.0f, 1.0f, 0.0f, 0.0f, 0.0f, 1.0f, 0.0f, 0.0f, 0.0f,
  1.0f, 1.0f, 1.0f, 1.0f, 1.0f, 1.0f, 1.0f, 1.0f, 1.0f, 0.0f, 1.0f, 0.0f, 1.0f, 0.0f, 0.0f, 0.0f,
};

// メロディー楽譜の歌詞表示タイミング
static const float melodyScore_lyricTiming[MELODY_LENGTH] = {
  2.0f, 0.0f, 2.0f, 0.0f, 2.0f, 0.0f, 2.0f, 0.0f, 2.0f, 0.0f, 2.0f, 0.0f, 2.0f, 0.0f, 0.0f, 0.0f,
  2.0f, 0.0f, 2.0f, 0.0f, 2.0f, 0.0f, 2.0f, 0.0f, 2.0f, 0.0f, 2.0f, 0.0f, 2.0f, 0.0f, 0.0f, 0.0f,
  1.0f, 1.0f, 0.0f, 0.0f, 1.0f, 1.0f, 0.0f, 0.0f, 1.0f, 1.0f, 0.0f, 0.0f, 1.0f, 1.0f, 0.0f, 0.0f,
  1.0f, 1.0f, 1.0f, 1.0f, 1.0f, 1.0f, 1.0f, 1.0f, 1.0f, 1.0f, 1.0f, 1.0f, 1.0f, 1.0f, 0.0f, 0.0f,
};

// ============================================================
// リズム楽譜（一定間隔で同じ音が鳴る楽譜）
//   8分音符間隔で「1回鳴る → 7回休み」を繰り返す
//   音高は固定で C5（ピッチインデックス24）を使用
// ============================================================
static const uint8_t rhythmScore_pitch[MELODY_LENGTH] = {
  24, 0, 0, 0, 0, 0, 0, 0,
  24, 0, 0, 0, 0, 0, 0, 0,
  24, 0, 0, 0, 0, 0, 0, 0,
  24, 0, 0, 0, 0, 0, 0, 0,
  24, 0, 0, 0, 0, 0, 0, 0,
  24, 0, 0, 0, 0, 0, 0, 0,
  24, 0, 0, 0, 0, 0, 0, 0,
  24, 0, 0, 0, 0, 0, 0, 0,
};

static const float rhythmScore_duration[MELODY_LENGTH] = {
  1.0f, 0.0f, 0.0f, 0.0f, 1.0f, 0.0f, 0.0f, 0.0f,
  1.0f, 0.0f, 0.0f, 0.0f, 1.0f, 0.0f, 0.0f, 0.0f,
  1.0f, 0.0f, 0.0f, 0.0f, 1.0f, 0.0f, 0.0f, 0.0f,
  1.0f, 0.0f, 0.0f, 0.0f, 1.0f, 0.0f, 0.0f, 0.0f,
  1.0f, 0.0f, 0.0f, 0.0f, 1.0f, 0.0f, 0.0f, 0.0f,
  1.0f, 0.0f, 0.0f, 0.0f, 1.0f, 0.0f, 0.0f, 0.0f,
  1.0f, 0.0f, 0.0f, 0.0f, 1.0f, 0.0f, 0.0f, 0.0f,
  1.0f, 0.0f, 0.0f, 0.0f, 1.0f, 0.0f, 0.0f, 0.0f,
};

static const float rhythmScore_amplitude[MELODY_LENGTH] = {
  1.0f, 0.0f, 0.0f, 0.0f, 1.0f, 0.0f, 0.0f, 0.0f,
  1.0f, 0.0f, 0.0f, 0.0f, 1.0f, 0.0f, 0.0f, 0.0f,
  1.0f, 0.0f, 0.0f, 0.0f, 1.0f, 0.0f, 0.0f, 0.0f,
  1.0f, 0.0f, 0.0f, 0.0f, 1.0f, 0.0f, 0.0f, 0.0f,
  1.0f, 0.0f, 0.0f, 0.0f, 1.0f, 0.0f, 0.0f, 0.0f,
  1.0f, 0.0f, 0.0f, 0.0f, 1.0f, 0.0f, 0.0f, 0.0f,
  1.0f, 0.0f, 0.0f, 0.0f, 1.0f, 0.0f, 0.0f, 0.0f,
  1.0f, 0.0f, 0.0f, 0.0f, 1.0f, 0.0f, 0.0f, 0.0f,
};

static const float rhythmScore_lyricTiming[MELODY_LENGTH] = {
  2.0f, 0.0f, 2.0f, 0.0f, 2.0f, 0.0f, 2.0f, 0.0f, 2.0f, 0.0f, 2.0f, 0.0f, 2.0f, 0.0f, 0.0f, 0.0f,
  2.0f, 0.0f, 2.0f, 0.0f, 2.0f, 0.0f, 2.0f, 0.0f, 2.0f, 0.0f, 2.0f, 0.0f, 2.0f, 0.0f, 0.0f, 0.0f,
  1.0f, 1.0f, 0.0f, 0.0f, 1.0f, 1.0f, 0.0f, 0.0f, 1.0f, 1.0f, 0.0f, 0.0f, 1.0f, 1.0f, 0.0f, 0.0f,
  1.0f, 1.0f, 1.0f, 1.0f, 1.0f, 1.0f, 1.0f, 1.0f, 1.0f, 1.0f, 1.0f, 1.0f, 1.0f, 1.0f, 0.0f, 0.0f,
};

// ============================================================
// 楽譜選択用 構造体・テーブル
//   0 = リズム楽譜
//   1 = メロディー楽譜
//   ※ server.js の score パラメータと対応
// ============================================================
typedef struct {
  const uint8_t *pitch;
  const float   *duration;
  const float   *amplitude;
  const float   *lyricTiming;
} ScoreData;

#define SCORE_ID_RHYTHM 0
#define SCORE_ID_MELODY 1
#define SCORE_COUNT     2

static const ScoreData scoreTable[SCORE_COUNT] = {
  { rhythmScore_pitch, rhythmScore_duration, rhythmScore_amplitude, rhythmScore_lyricTiming }, // 0: リズム
  { melodyScore_pitch, melodyScore_duration, melodyScore_amplitude, melodyScore_lyricTiming }, // 1: メロディー
};

// ピッチインデックス → 周波数(Hz) 変換テーブル（C3〜C6・半音単位）
#define PITCH_TABLE_LEN 37
static const float pitchFreqHz[PITCH_TABLE_LEN] = {
  130.81f, // 0  C3
  138.59f, // 1  C#3
  146.83f, // 2  D3
  155.56f, // 3  D#3
  164.81f, // 4  E3
  174.61f, // 5  F3
  185.00f, // 6  F#3
  196.00f, // 7  G3
  207.65f, // 8  G#3 / Ab3
  220.00f, // 9  A3
  233.08f, // 10 A#3 / Bb3
  246.94f, // 11 B3
  261.63f, // 12 C4 (ド)
  277.18f, // 13 C#4
  293.66f, // 14 D4 (レ)
  311.13f, // 15 D#4
  329.63f, // 16 E4 (ミ)
  349.23f, // 17 F4 (ファ)
  369.99f, // 18 F#4
  392.00f, // 19 G4 (ソ)
  415.30f, // 20 G#4
  440.00f, // 21 A4 (ラ)
  466.16f, // 22 A#4
  493.88f, // 23 B4 (シ)
  523.25f, // 24 C5 (ド)
  554.37f, // 25 C#5
  587.33f, // 26 D5 (レ)
  622.25f, // 27 D#5
  659.25f, // 28 E5 (ミ)
  698.46f, // 29 F5 (ファ)
  739.99f, // 30 F#5
  783.99f, // 31 G5 (ソ)
  830.61f, // 32 G#5
  880.00f, // 33 A5 (ラ)
  932.33f, // 34 A#5
  987.77f, // 35 B5 (シ)
  1046.50f // 36 C6
};

#endif
