crab2424/LEDplaying_system/演奏/player/katakana.h

#ifndef KATAKANA_H
#define KATAKANA_H

#include <stdint.h>

extern const uint32_t a[3];
extern const uint32_t i[3];
extern const uint32_t u[3];
extern const uint32_t e[3];
extern const uint32_t o[3];

extern const uint32_t ka[3];
extern const uint32_t ki[3];
extern const uint32_t ku[3];
extern const uint32_t ke[3];
extern const uint32_t ko[3];

extern const uint32_t sa[3];
extern const uint32_t si[3];
extern const uint32_t su[3];
extern const uint32_t se[3];
extern const uint32_t so[3];

extern const uint32_t ta[3];
extern const uint32_t ti[3];
extern const uint32_t tu[3];
extern const uint32_t te[3];
extern const uint32_t to[3];

extern const uint32_t na[3];
extern const uint32_t ni[3];
extern const uint32_t nu[3];
extern const uint32_t ne[3];
extern const uint32_t no[3];

extern const uint32_t ha[3];
extern const uint32_t hi[3];
extern const uint32_t hu[3];
extern const uint32_t he[3];
extern const uint32_t ho[3];

extern const uint32_t ma[3];
extern const uint32_t mi[3];
extern const uint32_t mu[3];
extern const uint32_t me[3];
extern const uint32_t mo[3];

extern const uint32_t ya[3];
extern const uint32_t yu[3];
extern const uint32_t yo[3];

extern const uint32_t ra[3];
extern const uint32_t ri[3];
extern const uint32_t ru[3];
extern const uint32_t re[3];
extern const uint32_t ro[3];

extern const uint32_t wa[3];
extern const uint32_t wo[3];
extern const uint32_t n[3];

extern const uint32_t ga[3];

#endif
