crab2424/LEDplaying_system/(commit log)

2026-06-09 演奏開始・停止スイッチの制御
2026-06-09 作業ログ
2026-06-09 作業ログの更新
2026-06-16 ヴァイオリン波形修正・結果表示
2026-06-16 作業ログの修正
2026-06-20 結合用フォルダ
2026-06-20 指揮者用
2026-06-20 演奏者用をリネーム
2026-06-20 ガントチャート修正
2026-06-20 conductor: WiFi接続にタイムアウトを追加してスタンドアロン動作を可能に
    WiFi未接続時にsetup()内の無限ループでsetup()を抜けられず
    LEDが動作しない問題に対応。10秒で接続を諦め、
    スイッチ+可変抵抗による単体動作モードで起動を続行する。
2026-06-20 player: 歌詞表示タイミングを melody と同形式の配列で制御
    - lyrics.h に lyricTiming[MELODY_LENGTH] を追加（duration[] と同じ拍単位）
    - kaeruNoUta[] は LYRICS_LENGTH=36 のフラットな文字配列に整理
    - player.ino で実音符ゲートを撤去し、lyricTiming[noteNum] > 0 で
    次の文字を表示するロジックに変更（休符スロットを使った
    「1音=2文字（クワ等）」表現が可能）
2026-06-20 主旋律の修正
2026-06-20 歌詞表示の修正
2026-06-20 歌詞のタイミングずれを修正
2026-06-21 LED色切り替え処理を追加
2026-06-21 名称変更
2026-06-21 通信速度を修正
2026-06-21 輪唱可能にするよう修正
2026-06-21 通信速度調整
2026-06-21 今週の作業ログ
2026-06-21 IDの対応，設定確認
2026-06-22 作業ログ0623更新：結合・輪唱の詳細記述とAI利用3件を追記
2026-06-22 ログの詳細追加
2026-06-23 文章の修正，調整
2026-06-23 フォント警告を修正
2026-06-23 文法の修正
2026-06-23 参考文献の修正
2026-06-23 作業ログ 06/23
2026-06-23 作業ログ表のコメントを修正
2026-06-24 今週の演奏ファイルを共有
2026-06-30 作業ログの修正・加筆
2026-07-06 作業ログの編集
2026-07-06 チーム内部資料の追加
2026-07-07 作業ログの日付変更
2026-07-07 最終報告書→開発報告書に名称変更
2026-07-07 作業ログの編集・更新
2026-07-07 誤字の訂正
